ZegarNotAvailable/CloneFactory/CA80-Cube/README.MD

# CA80-Cube.

Jest to kolejna wersja CA80-mini. Wymiary płytek zostały ujednolicone, co umożliwia budowę komputera w formie nakładanych na siebie modułów.

## Hardware

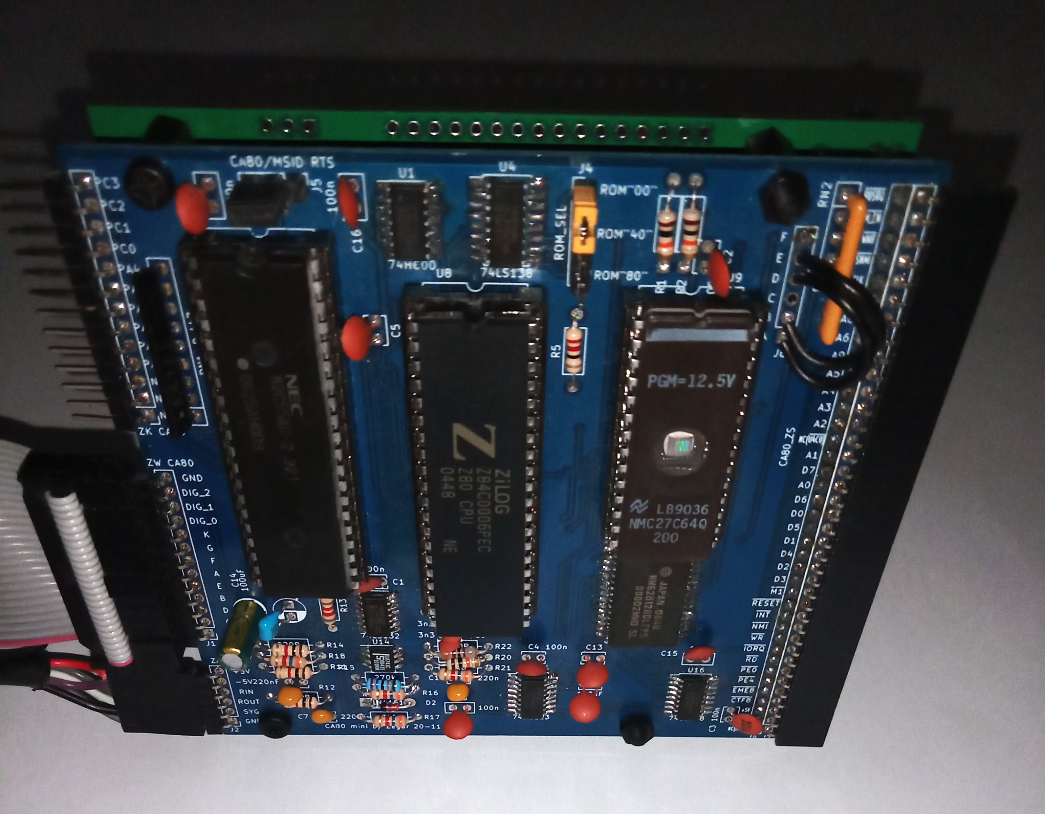
[picture p4: CA80-Cube/HW/Pics/Kanapka-mini-CPU.jpg]
Assembled modules


It is not a CP/M system, but a self-sufficient computer with a hexadecimal keyboard and a seven-segment display.
In the minimum version, 2kB EPROM and 2kB RAM are enough, but it is optimal to use the full 64kB RAM.
It is possible to build a classic version with EPROM and a CLK generator, but using an additional module with an ATmega32A microcontroller significantly increases the computer's capabilities.

### CA80-mini.

It's MIK90 equivalent. Includes processor and memory. The decoder is consistent with the original and divides the address space into four parts. 
By default, all memory is allocated to RAM. We can allocate one or two sixteen-kilobyte areas to EPROM, which we can insert into the U9 socket. 

Contains system interfaces: 
- keyboard,
- display,
- and tape recorder.

### MIK89 module.

The original only included the i8255 and Z80 CTC. On the edge was a ZS connector containing signals for use outside the motherboard. 
Soldering points scattered throughout the board were connected with wires to a male DB50 called ZU50.
In the new version CA80 (1989 - 1990) these chips were moved to the motherboard and ZU64 was added.

Clone takes this change. I also added a CLK generator and an NMI divider, which did not fit on the CA80-CPU.
They are not needed when we use the CA80-bootloader module.

- CLK was originally 4 MHz. This is important in tape recorder operating procedures. We can use a different frequency with some restrictions.
- NMI is the computer's most important signal. In the original it was 500 Hz and that's what it should always be.
  As the name suggests, this signal reports a non-maskable interrupt, which:
  - displays successive display digits multiplexed.
  - Checks if the "M" key has been pressed.
  - Counts down seconds, minutes, hours... years in RTC.
 
### CA80-multi module.

This is an extended replacement for MIK89. Adapted to the CA80-mini format, it allows you to build a "sandwich" computer.

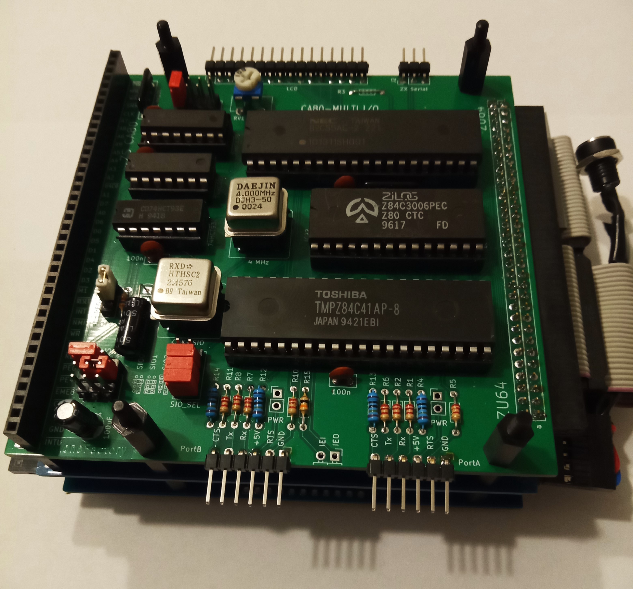
[picture p5: CA80-mini/HW/Pics/CA-MULTI-ASEMBLED.jpg]
CA80-multi


Includes:
- 8255,
- Z80CTC,
- 4 MHz generator,
- NMI divider,
- ZU64 connector,
- Z80SIO,
- 2.4576 MHz generator,
- Port A and Port B serial connectors,
- LCD display interface (HD44780).

### Software.

Dla wersji bez bootloadera należy zastosować zmodyfikowane wersje oprogramowania.

CA80-Cube/Code/HEX/CA804KFL.HEX to pierwsze 4 kB monitora CA80 z dodatkowymi zleceniami. 
*8d przepisuje CAFL z flash do RAM (4000H)
*88 przełącza sektor flash na 0FFH i uruchamia tam monitor CA88. Aktywne są wtedy również pozostałe zlecenia powyżej *84

CA80-Cube/Code/HEX/SST39SF040-CAFL-mini.BIN to program "magnetofonu" z chronionymi sektorami.

File CA80-MLT.HEX (Code-HEX/CA80-MLT.HEX)

In addition to the basic CA80 monitor (MIK290), full "tape recorder" software with functions supporting HEX files, redirected from 2000H. 
You can load it from SD card using CA80-boot module, or program EPROM. It also works without "flash" module.

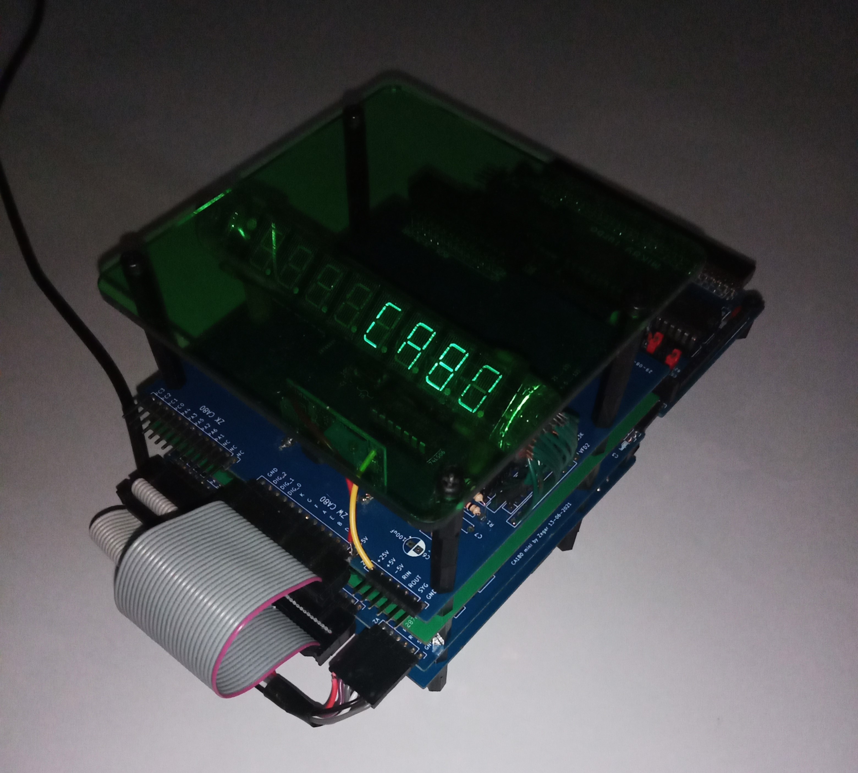
[picture p6: CA80-mini/HW/Pics/Kanapka-big.jpg]
CA80 big sandwich.


## Code for CA80 with Msid

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
