ZegarNotAvailable/CloneFactory/HardWare/IDC-CONN/CA80-Kbd-Disp-Conn.pdf

# | Reference | Qty | Value | Footprint

1 | C1, C2, C3 | 3 | 100n | Capacitor_THT:C_Disc_D3.8mm_W2.6mm_P2.50mm
2 | D1, D2, D3, D4, D5, D6 | 6 | 1N4148 | Diode_THT:D_DO-35_SOD27_P7.62mm_Horizontal
4 | J1 | 1 | ZW, ZK | PinSocket_2x13_P2.54mm_Vertical
5 | J2 | 1 | ZW, ZK | IDC26_Vertical
6 | Boot Loader | 1 | ZK | PinSocket_1x13_P2.54mm_Vertical
