ZegarNotAvailable/CloneFactory/CA80-Cube/HW/Pics/CA-SANDWICH-MINI.jpg

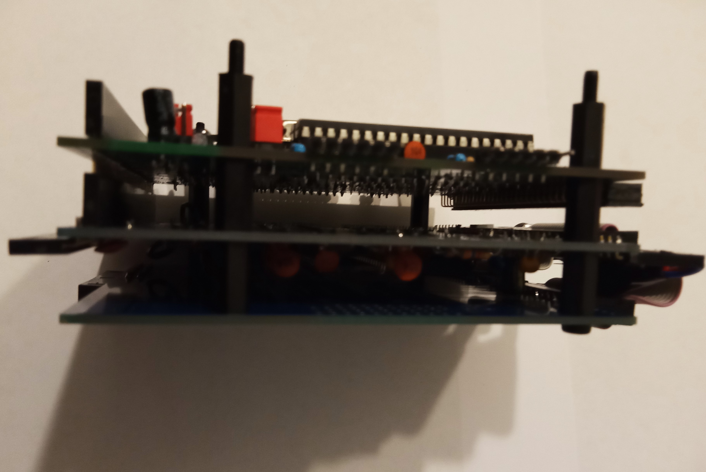
CA80-Cube/HW/Pics/CA-SANDWICH-MINI.jpg
