ZegarNotAvailable/CloneFactory/CA80-Cube/HW/Pics/Kanapka-terminal.jpg

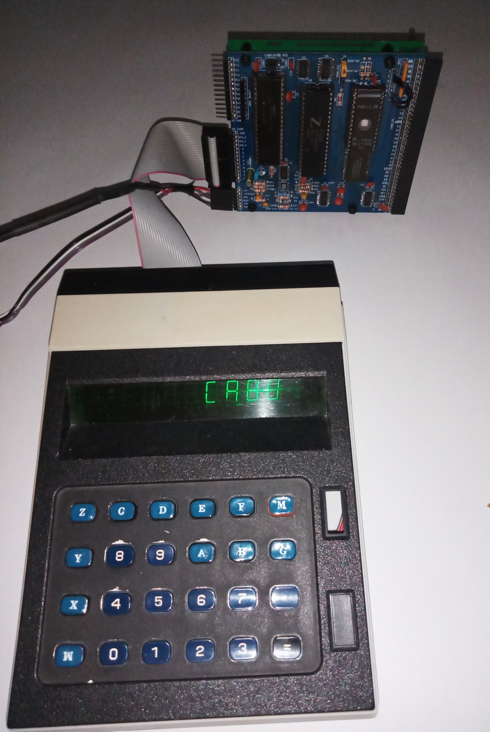
CA80-Cube/HW/Pics/Kanapka-terminal.jpg
