ZegarNotAvailable/CloneFactory/CA80-mini/HW/CA80-FLASH-CF/CA80-FLASH-CF.jpg

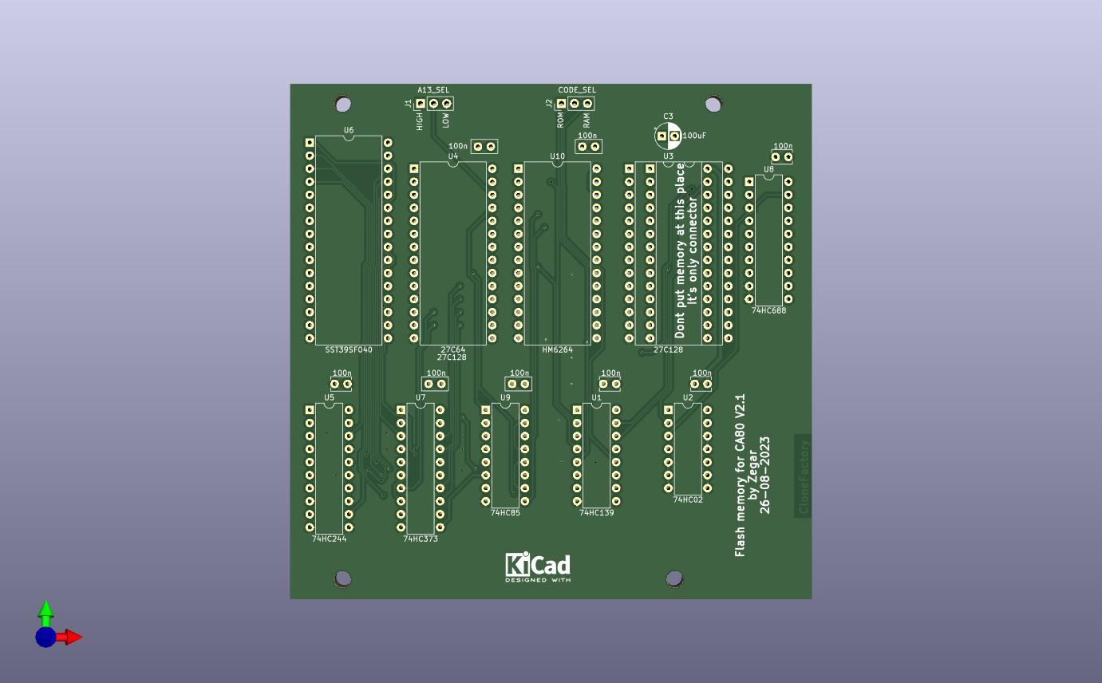
CA80-mini/HW/CA80-FLASH-CF/CA80-FLASH-CF.jpg
