ZegarNotAvailable/CloneFactory/CA80-mini/HW/CA80-mini-boot/CA80-mini-boot.png

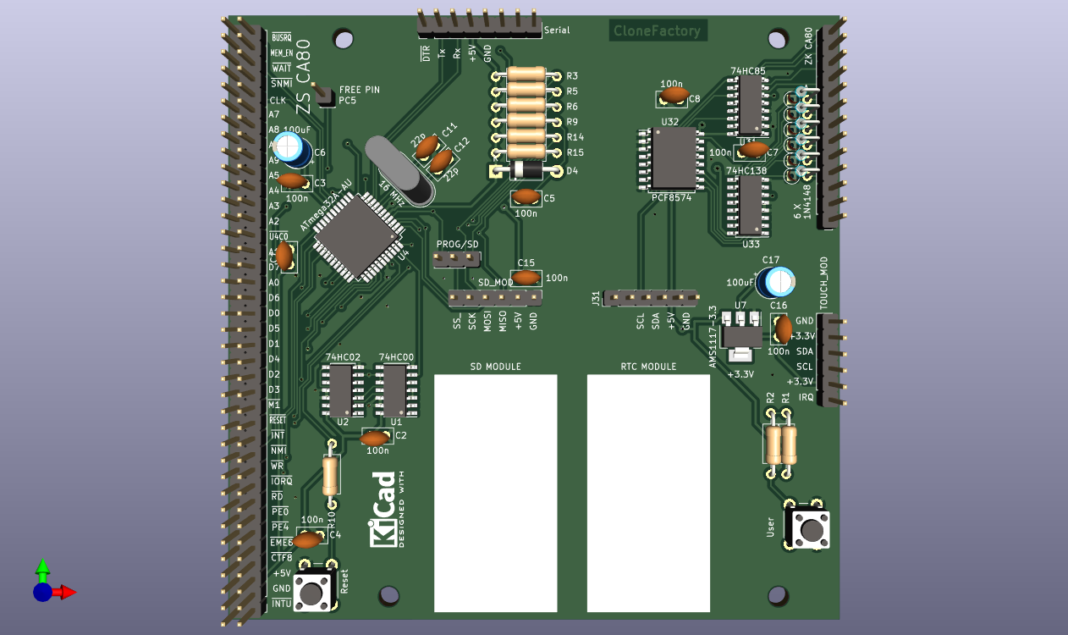
CA80-mini/HW/CA80-mini-boot/CA80-mini-boot.png
