ZegarNotAvailable/CloneFactory/CA80-mini/HW/CA80-mini/CA80-mini-03-23.jpg

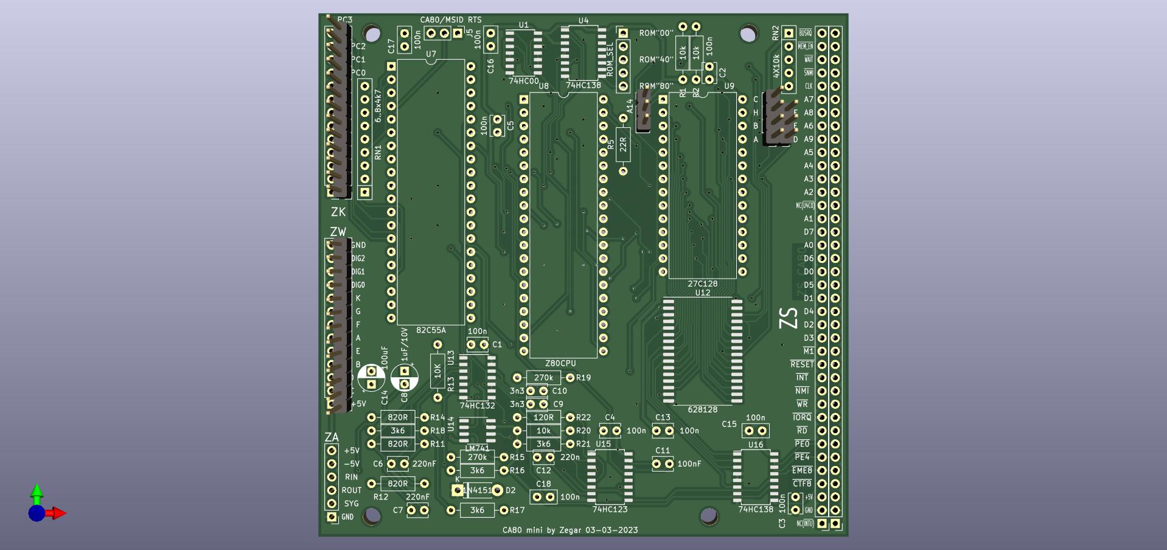
CA80-mini/HW/CA80-mini/CA80-mini-03-23.jpg
