ZegarNotAvailable/CloneFactory/CA80-mini/HW/CA80-mini/CA80-mini-23.png

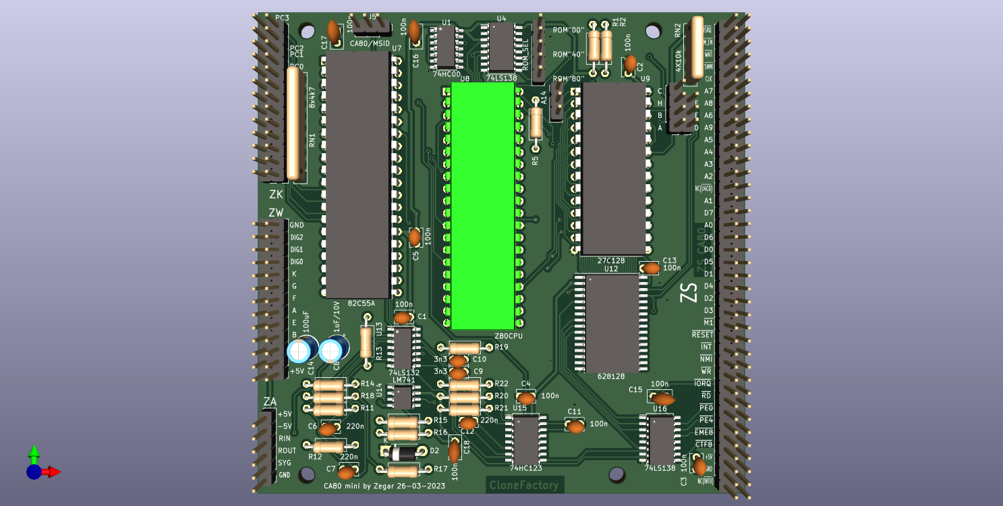
CA80-mini/HW/CA80-mini/CA80-mini-23.png
