ZegarNotAvailable/CloneFactory/CA80-mini/HW/CA80-multi/CA80-MULTI-IO.jpg

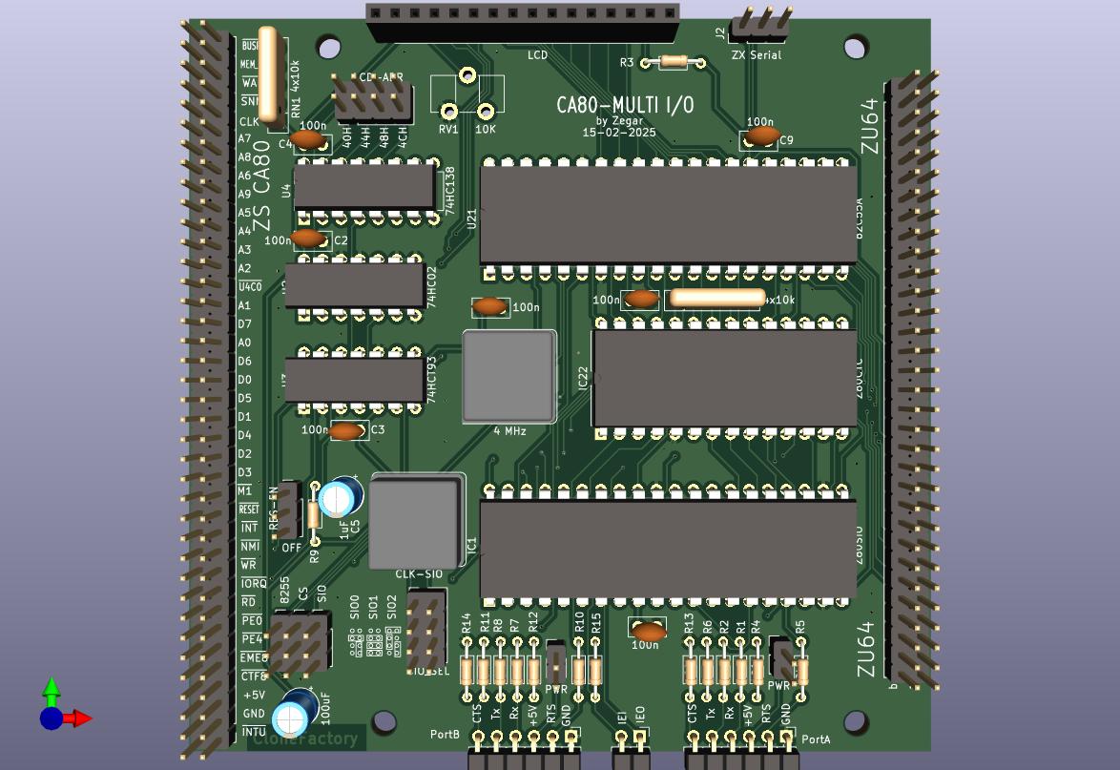
CA80-mini/HW/CA80-multi/CA80-MULTI-IO.jpg
