ZegarNotAvailable/CloneFactory/CA80-mini/HW/MIK89/MIK89_EXT-a.png

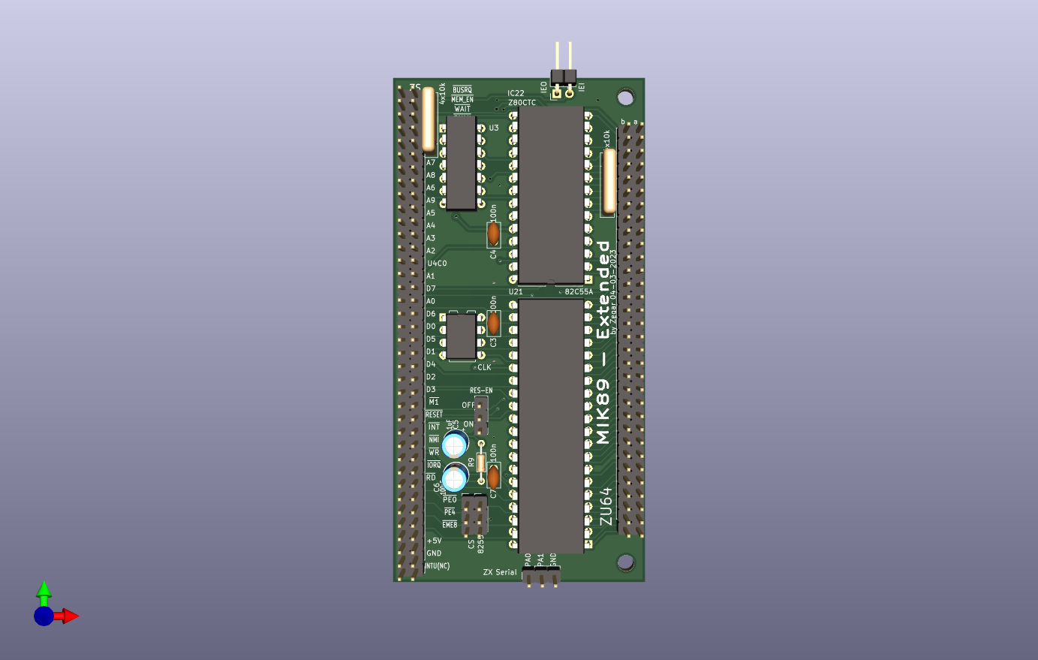
CA80-mini/HW/MIK89/MIK89_EXT-a.png
