ZegarNotAvailable/CloneFactory/CA80-mini/HW/Pics/CA80-mini-sandwich1.jpg

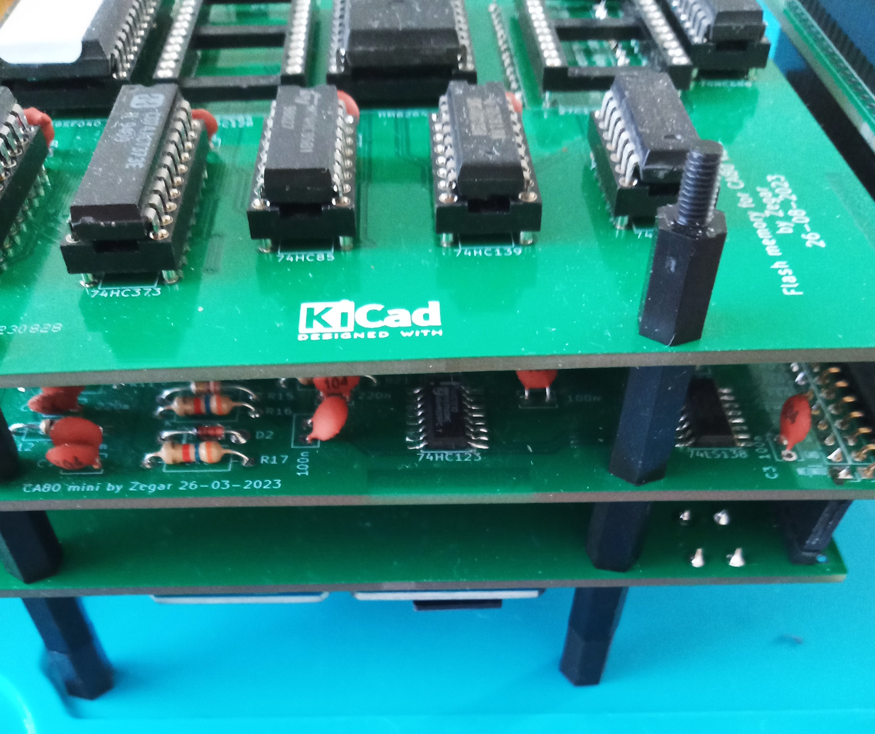
CA80-mini/HW/Pics/CA80-mini-sandwich1.jpg
