ZegarNotAvailable/CloneFactory/CA80-mini/HW/Pics/CA80-mini-sandwich.jpg

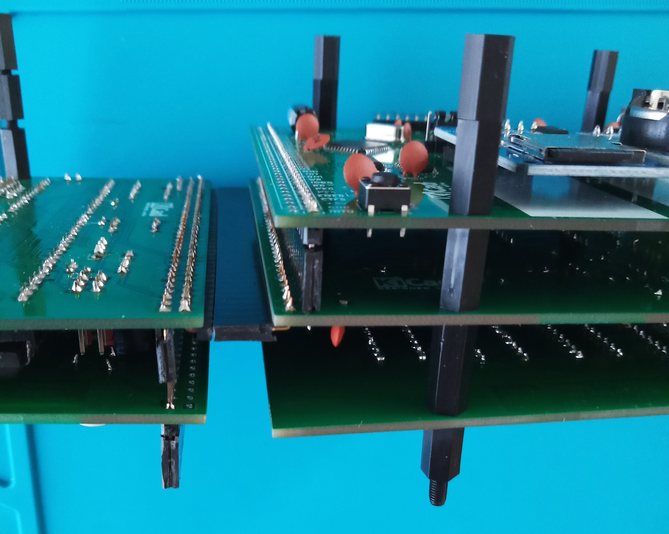
CA80-mini/HW/Pics/CA80-mini-sandwich.jpg
