ZegarNotAvailable/CloneFactory/CA80-mini/HW/Pics/CA80-Multi.jpg

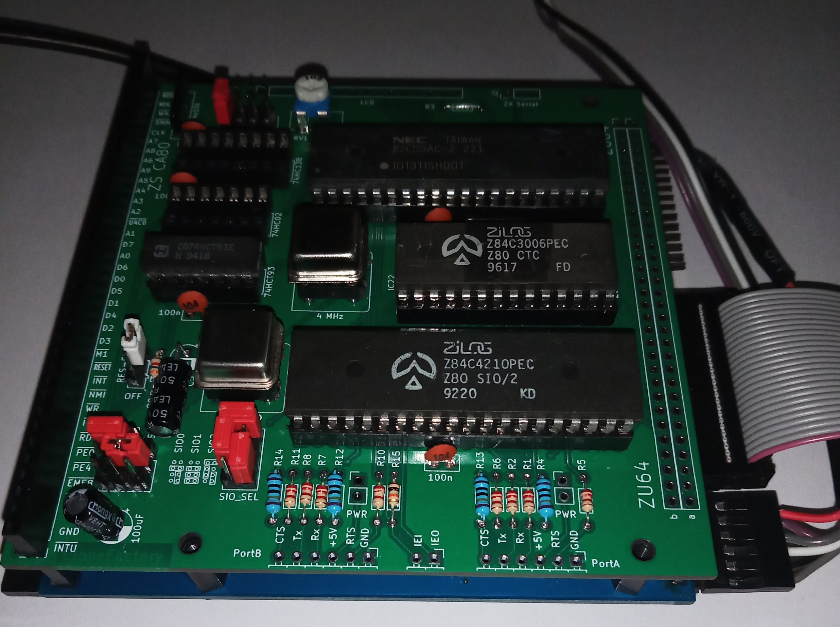
CA80-mini/HW/Pics/CA80-Multi.jpg
