ZegarNotAvailable/CloneFactory/CA80-mini/HW/Pics/Mini-boot-asembled.jpg

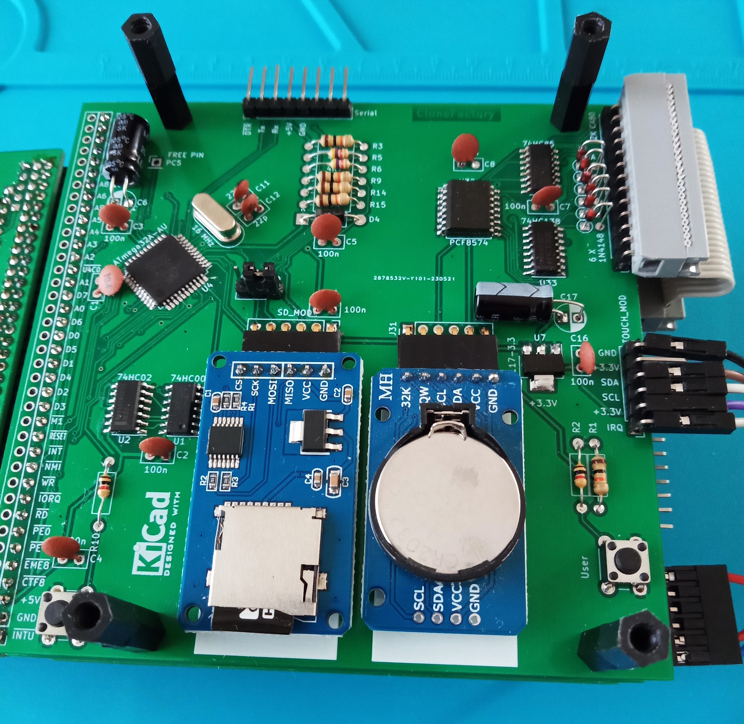
CA80-mini/HW/Pics/Mini-boot-asembled.jpg
