ZegarNotAvailable/CloneFactory/CA80-mini/HW/Pics/Touch-asembled1.jpg

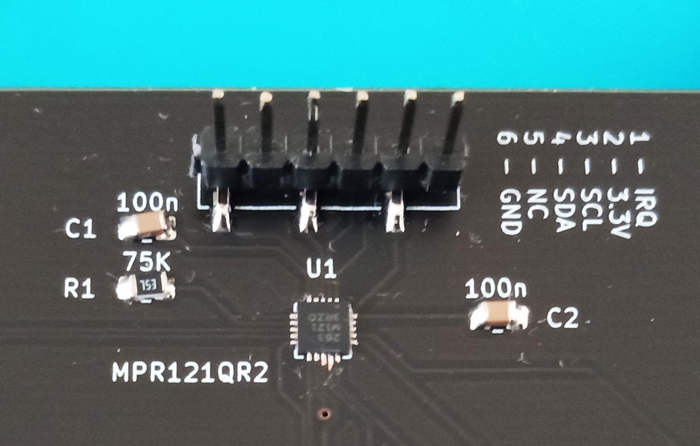
CA80-mini/HW/Pics/Touch-asembled1.jpg
