ZegarNotAvailable/CloneFactory/HardWare/CA80-bootloader/CA80-bootload.jpg

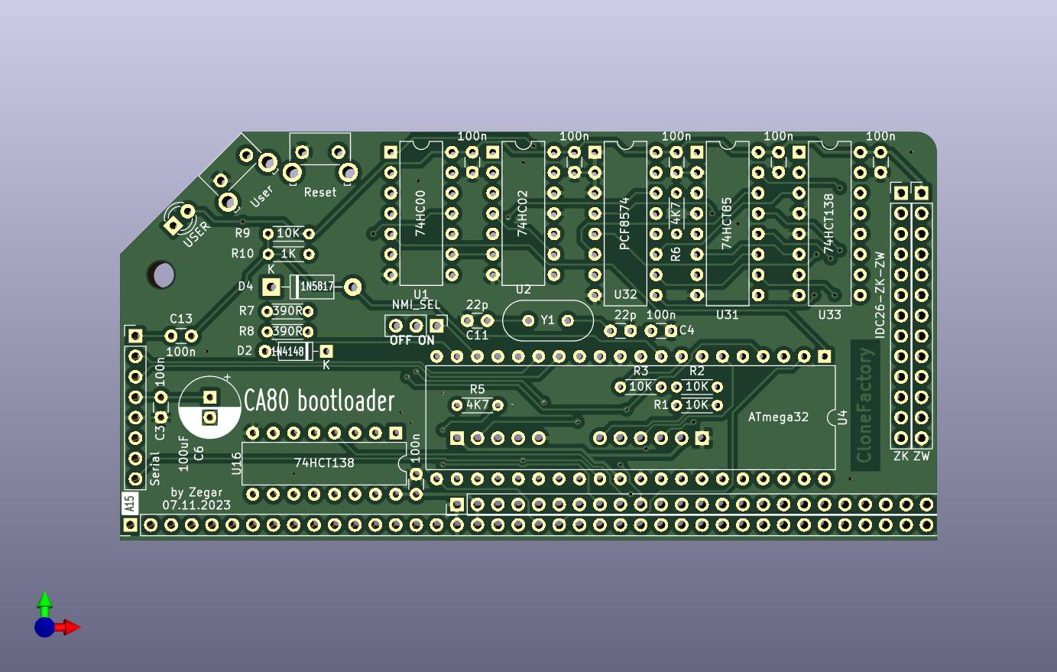
HardWare/CA80-bootloader/CA80-bootload.jpg
