ZegarNotAvailable/CloneFactory/HardWare/CA80-bootloader/CA80-bootloader.jpg

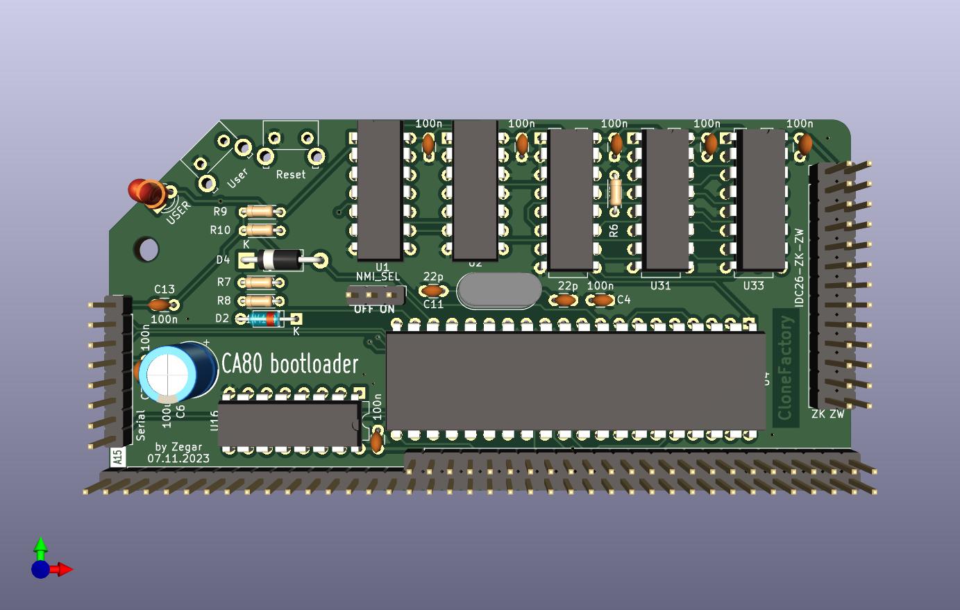
HardWare/CA80-bootloader/CA80-bootloader.jpg
