ZegarNotAvailable/CloneFactory/HardWare/CA80-flash/CA80_flash_RC.png

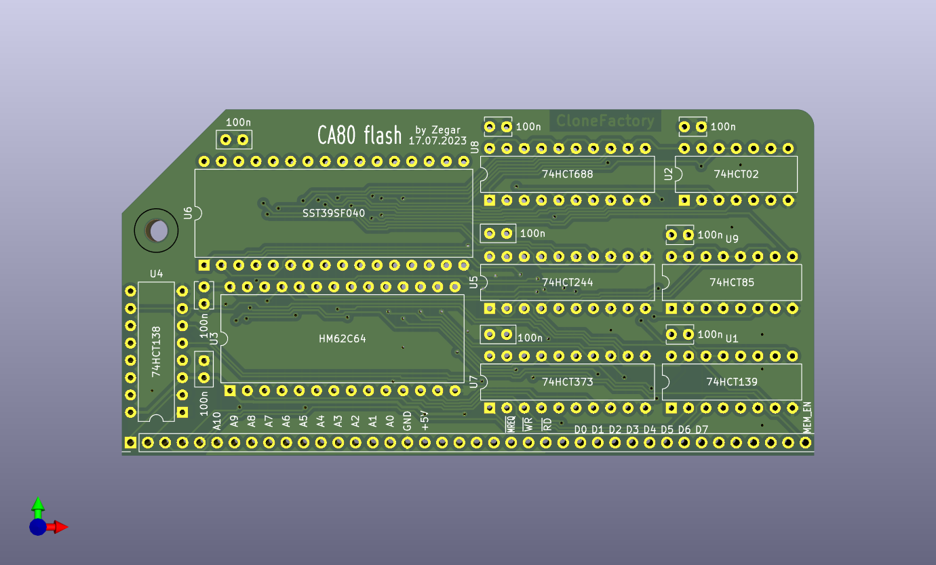
HardWare/CA80-flash/CA80_flash_RC.png
