ZegarNotAvailable/CloneFactory/HardWare/CA80-flash/CA80_flash_RC_uc.png

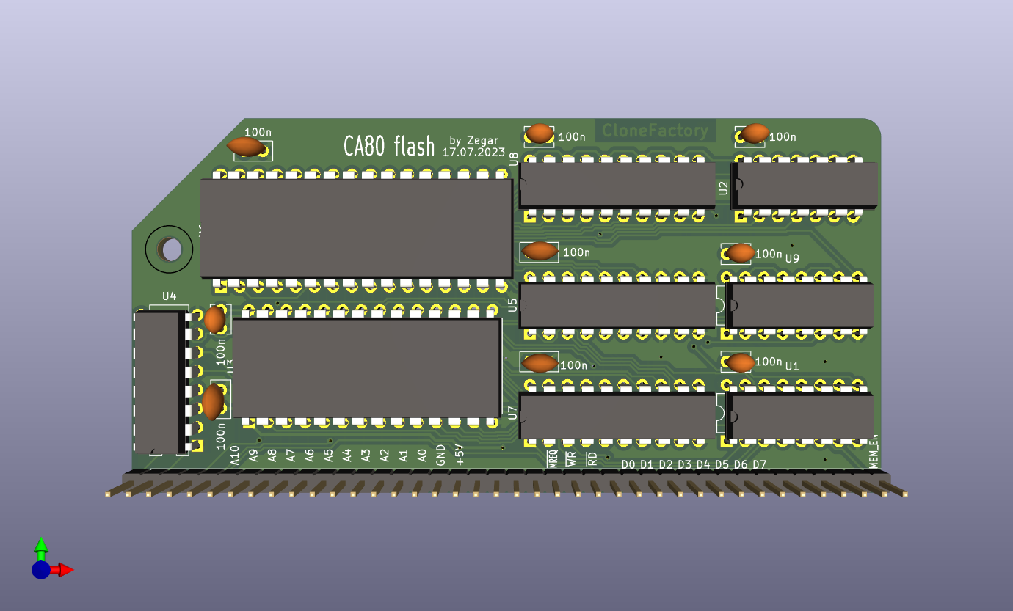
HardWare/CA80-flash/CA80_flash_RC_uc.png
