ZegarNotAvailable/CloneFactory/HardWare/CPU-N/CA80-CPU-12-mod.png

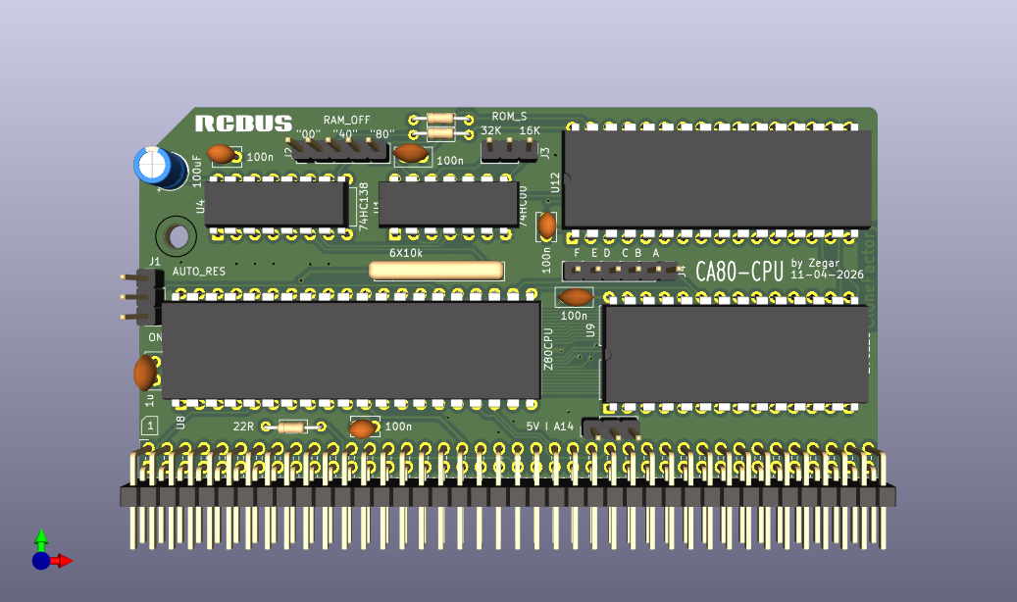
HardWare/CPU-N/CA80-CPU-12-mod.png
