ZegarNotAvailable/CloneFactory/HardWare/CPU-N/CA80-CPU-12-PCB.png

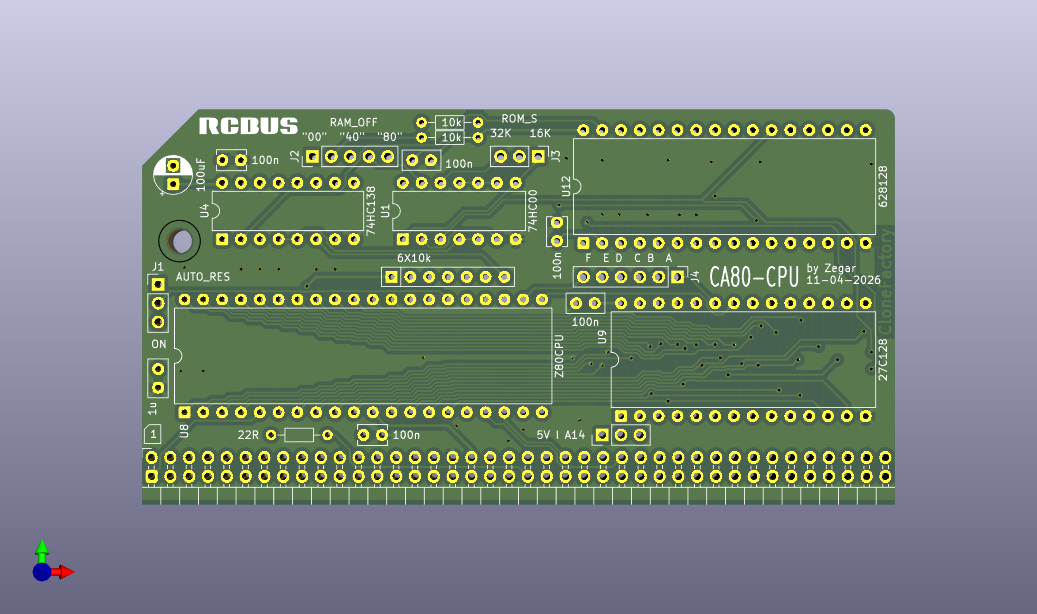
HardWare/CPU-N/CA80-CPU-12-PCB.png
