ZegarNotAvailable/CloneFactory/HardWare/CPU-N/CA80-CPU-N.jpg

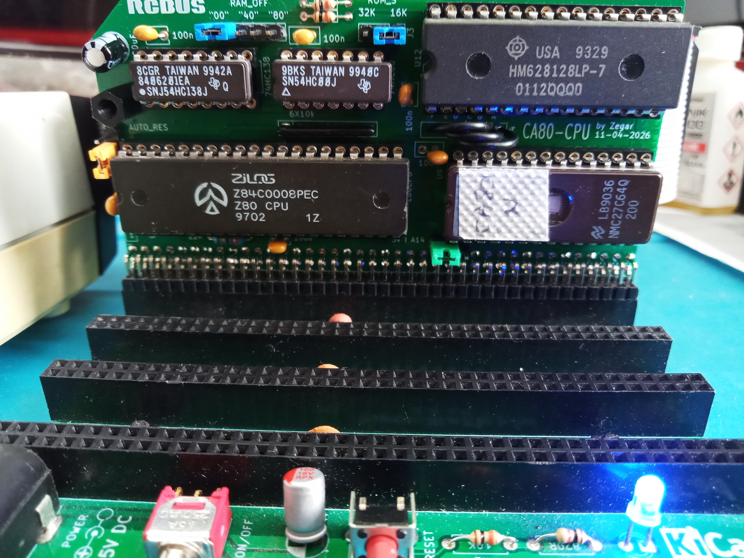
HardWare/CPU-N/CA80-CPU-N.jpg
