ZegarNotAvailable/CloneFactory/HardWare/CPU-N/CA80-RC-N-asembled.jpg

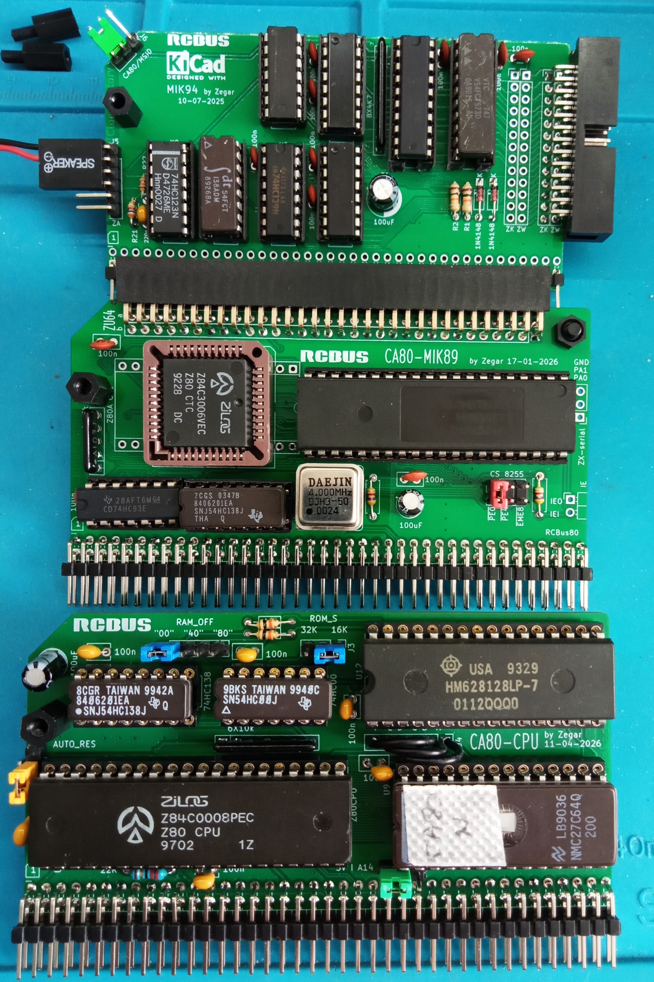
HardWare/CPU-N/CA80-RC-N-asembled.jpg
