ZegarNotAvailable/CloneFactory/HardWare/CPU/CA80-CPU-RCbus.jpg

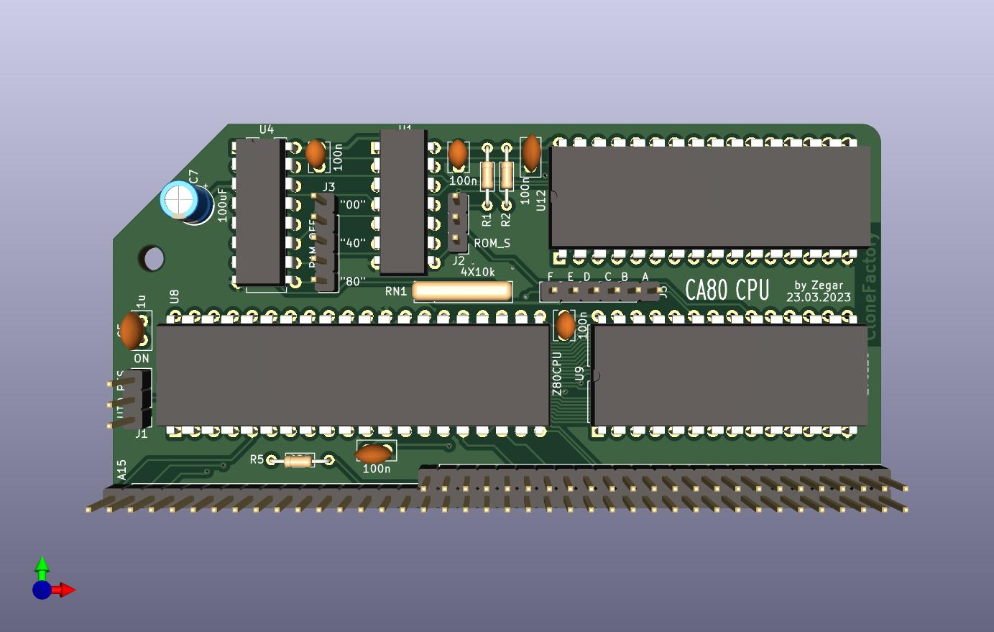
HardWare/CPU/CA80-CPU-RCbus.jpg
