ZegarNotAvailable/CloneFactory/HardWare/Dual-RAM-backplane/D-RAM-backplane-front.png

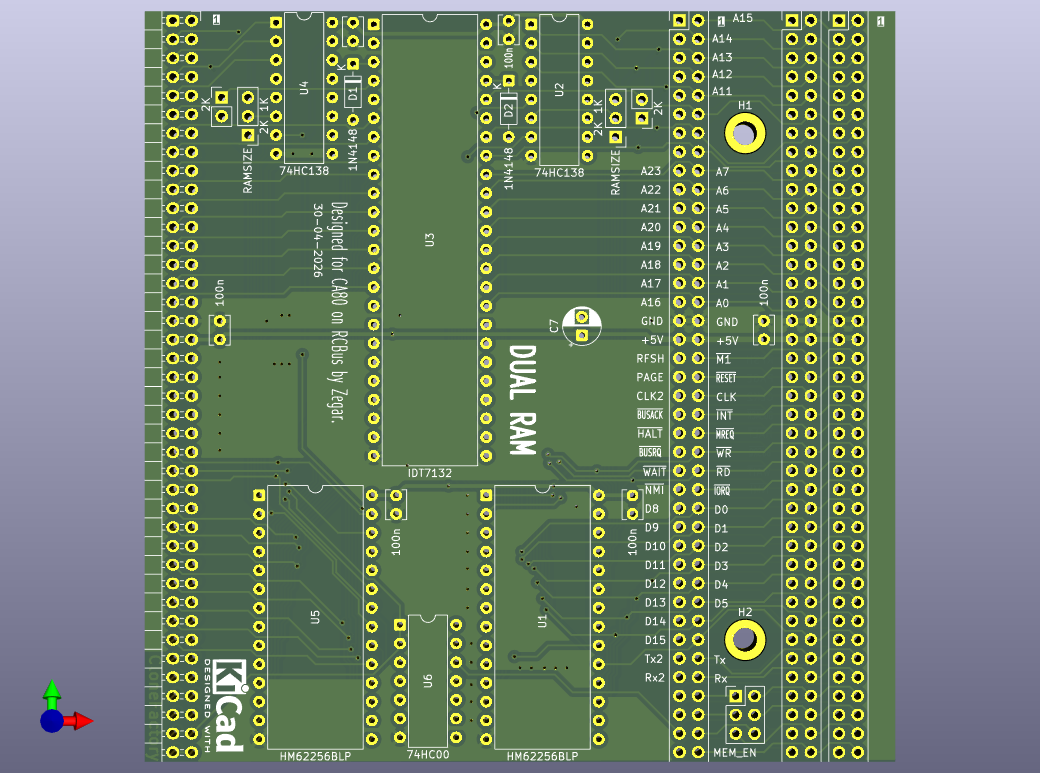
HardWare/Dual-RAM-backplane/D-RAM-backplane-front.png
