ZegarNotAvailable/CloneFactory/HardWare/Dual-RAM-backplane/D-RAM-backplane-PSEN.png

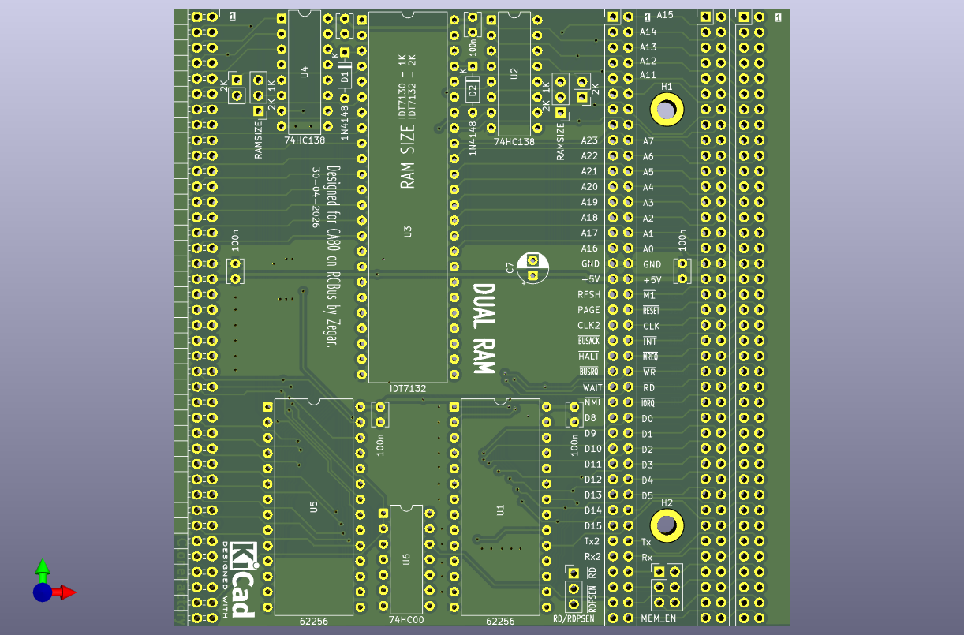
HardWare/Dual-RAM-backplane/D-RAM-backplane-PSEN.png
