ZegarNotAvailable/CloneFactory/HardWare/Dual-RAM-backplane/D-RAM-backplane.png

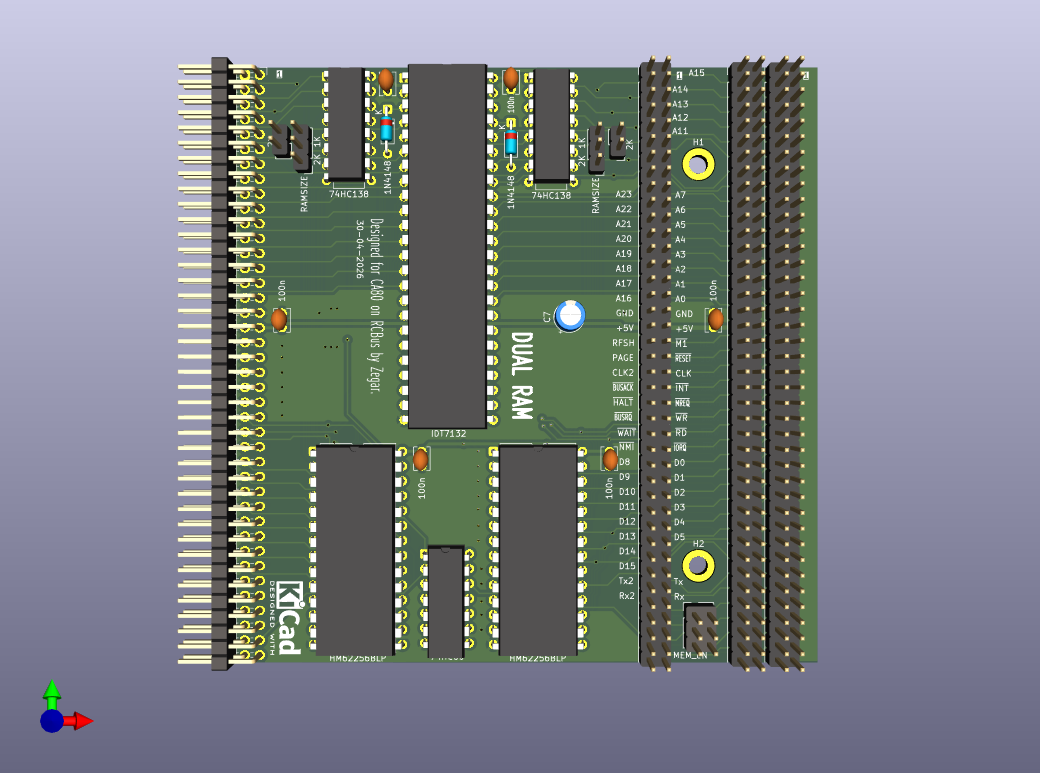
HardWare/Dual-RAM-backplane/D-RAM-backplane.png
