ZegarNotAvailable/CloneFactory/HardWare/IDC-CONN/SYS-IO-BOOT-CONN.jpg

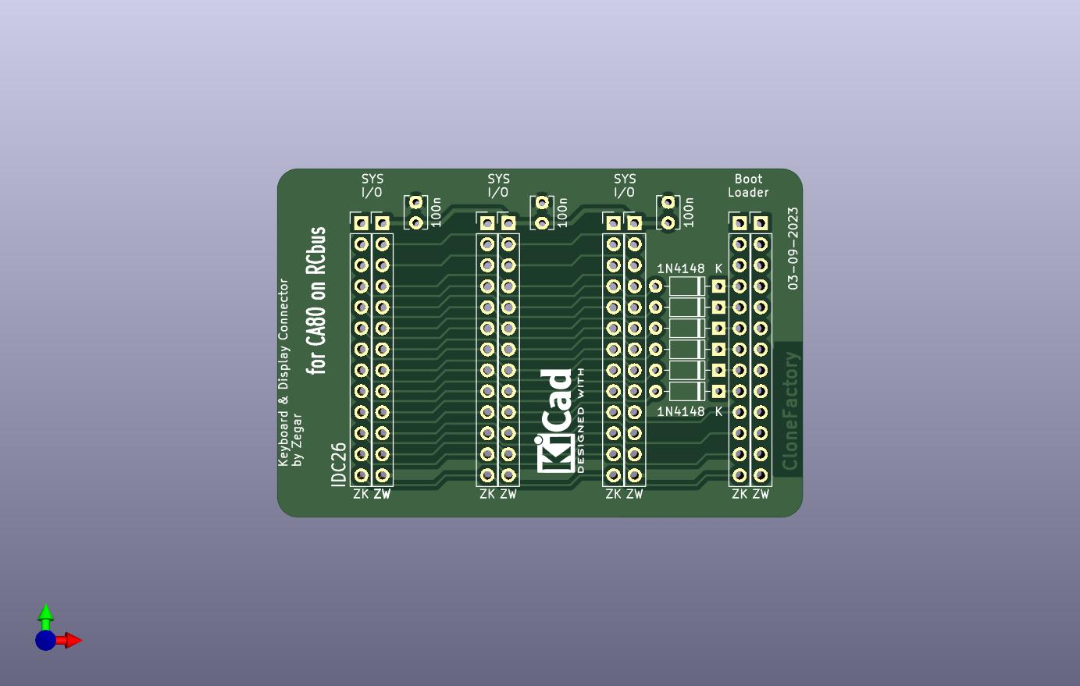
HardWare/IDC-CONN/SYS-IO-BOOT-CONN.jpg
