ZegarNotAvailable/CloneFactory/HardWare/MIK1-PROTO/MIK1-K.jpg

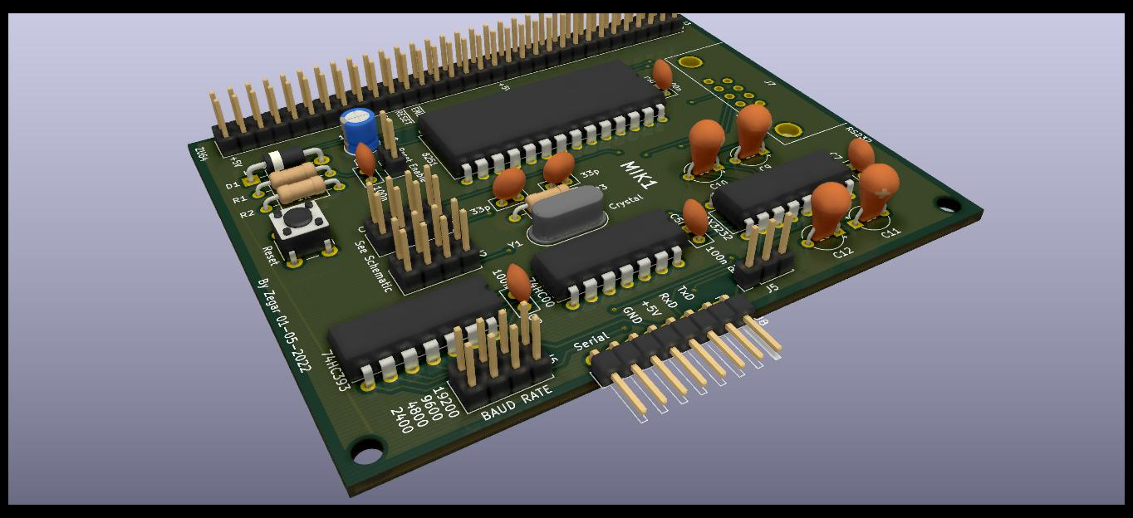
HardWare/MIK1-PROTO/MIK1-K.jpg
