ZegarNotAvailable/CloneFactory/HardWare/MIK1-PROTO/MIK1_RC2014.png

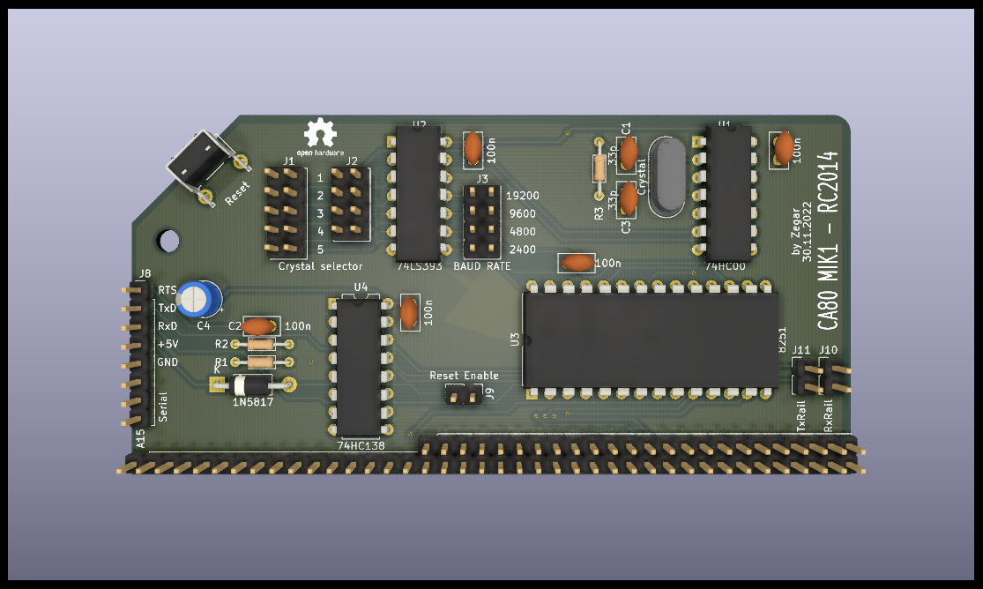
HardWare/MIK1-PROTO/MIK1_RC2014.png
