ZegarNotAvailable/CloneFactory/HardWare/MIK1/MIK1-RC-PCB.png

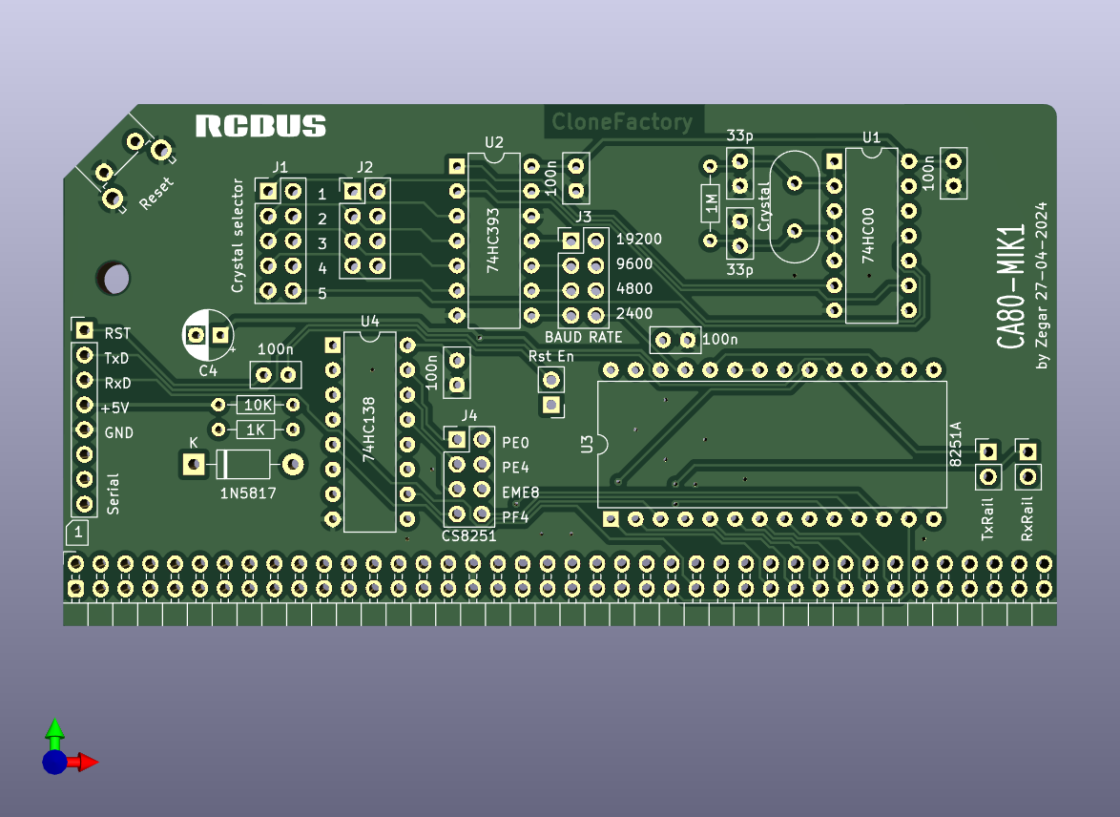
HardWare/MIK1/MIK1-RC-PCB.png
