ZegarNotAvailable/CloneFactory/HardWare/MIK1/MIK1-RC.png

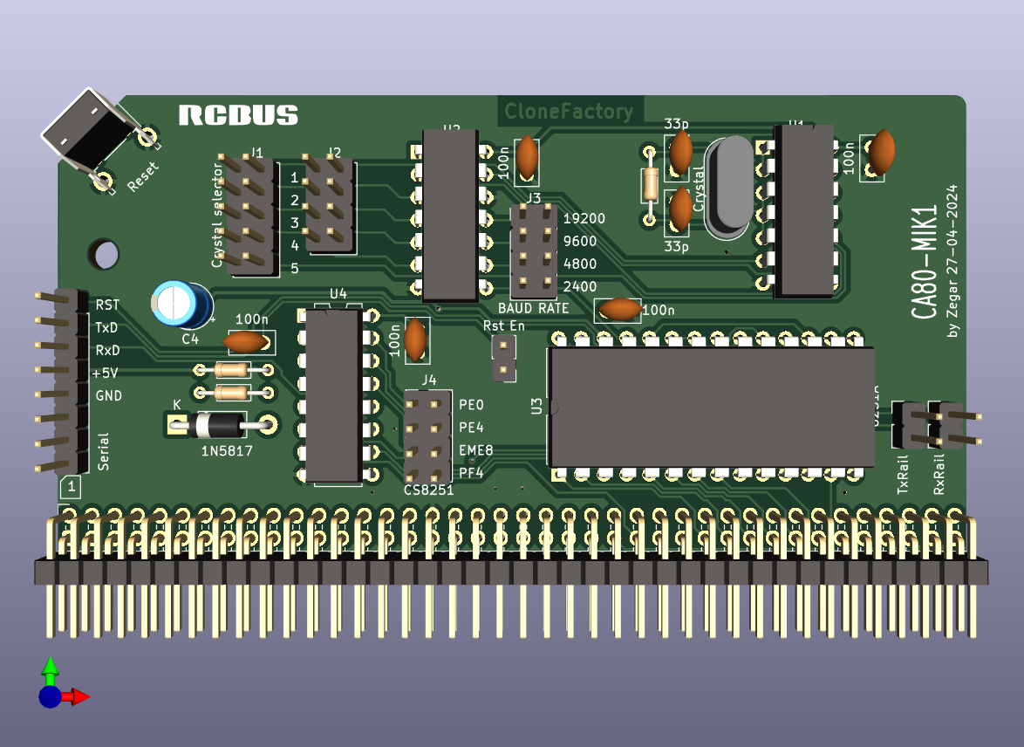
HardWare/MIK1/MIK1-RC.png
