ZegarNotAvailable/CloneFactory/HardWare/MIK51/MIK51-A.png

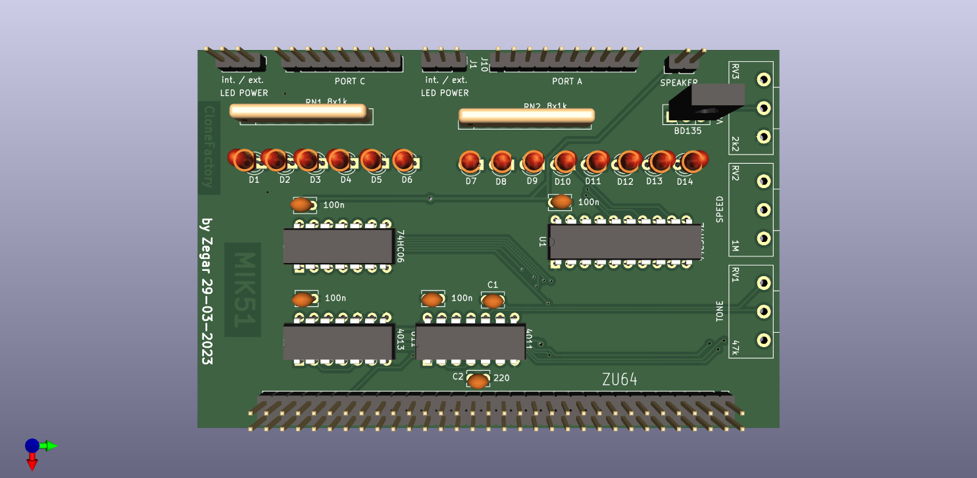
HardWare/MIK51/MIK51-A.png
