ZegarNotAvailable/CloneFactory/HardWare/MIK89-n/CA80-MIK89-n.jpg

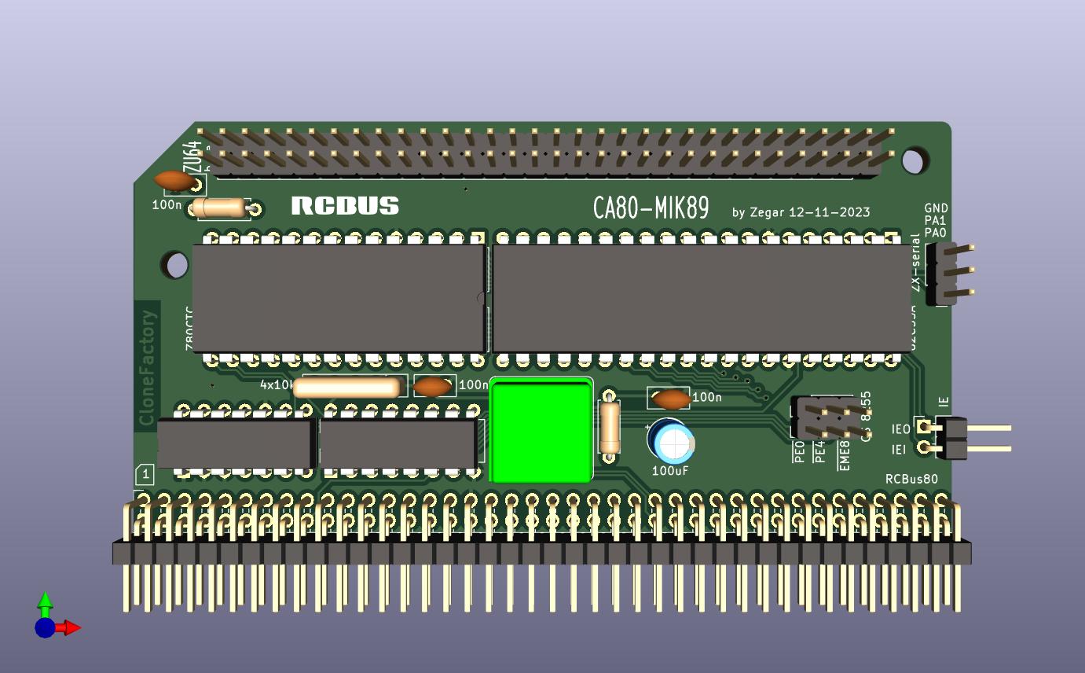
HardWare/MIK89-n/CA80-MIK89-n.jpg
