ZegarNotAvailable/CloneFactory/HardWare/MIK89-n/CA80-MIK89-nc.png

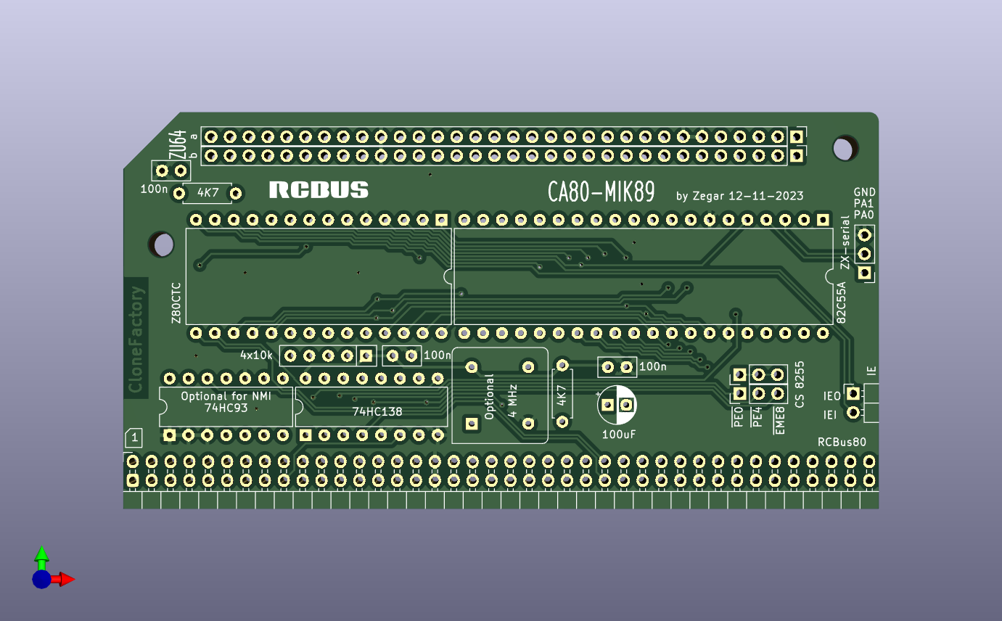
HardWare/MIK89-n/CA80-MIK89-nc.png
