ZegarNotAvailable/CloneFactory/HardWare/MIK89-PLCC/MIK89-RC-PLCC-pcb.png

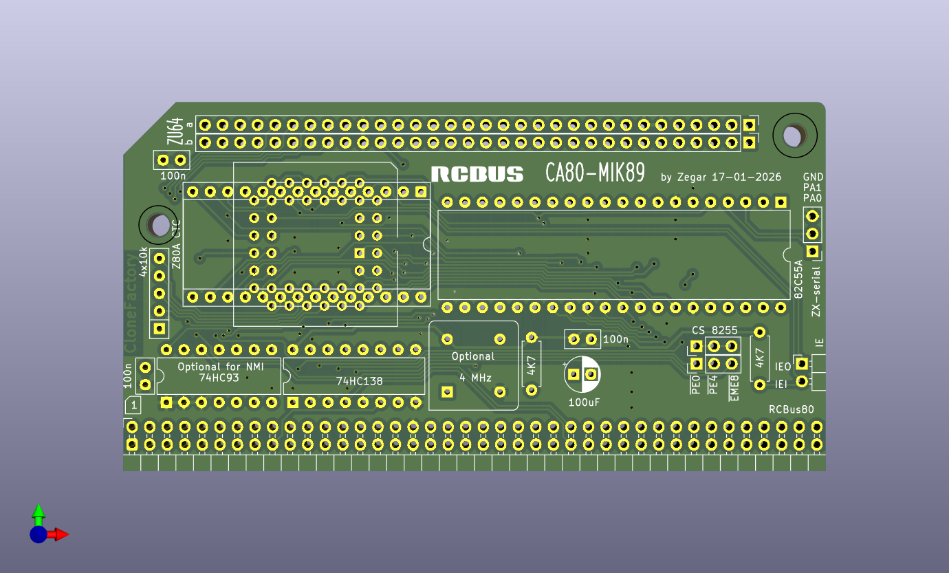
HardWare/MIK89-PLCC/MIK89-RC-PLCC-pcb.png
