ZegarNotAvailable/CloneFactory/HardWare/MIK89-PLCC/MIK89-RC-PLCC.png

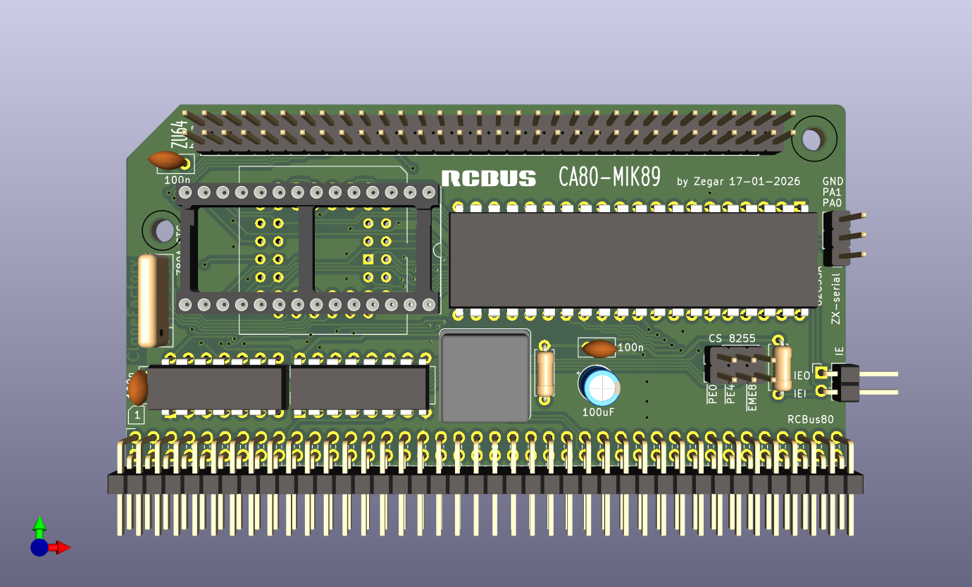
HardWare/MIK89-PLCC/MIK89-RC-PLCC.png
