ZegarNotAvailable/CloneFactory/HardWare/MIK94-N/MIK94-N-RCBus.png

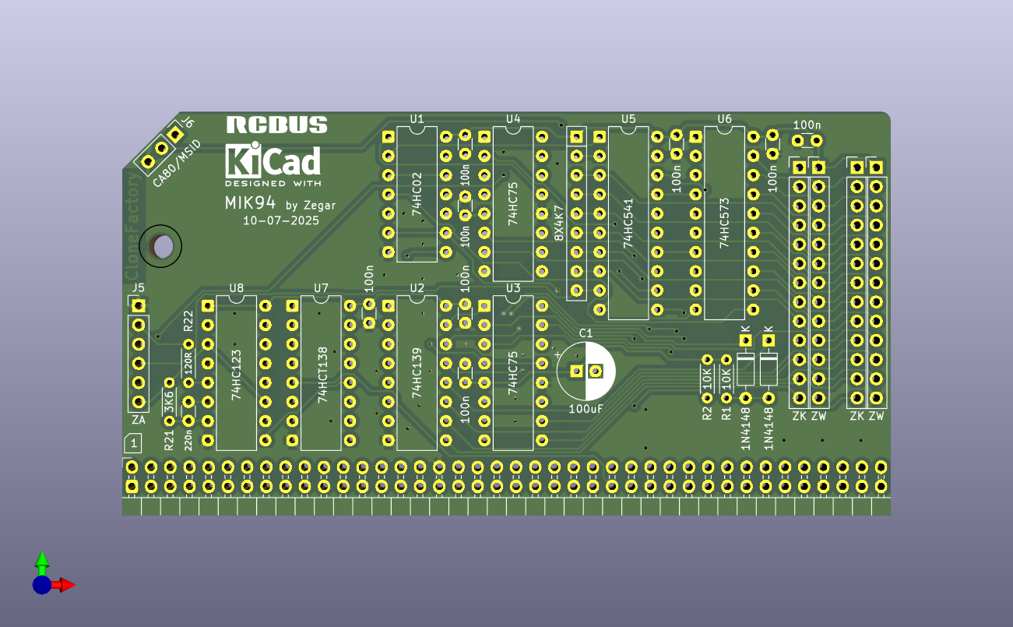
HardWare/MIK94-N/MIK94-N-RCBus.png
