ZegarNotAvailable/CloneFactory/HardWare/Pictures/LED-green.jpg

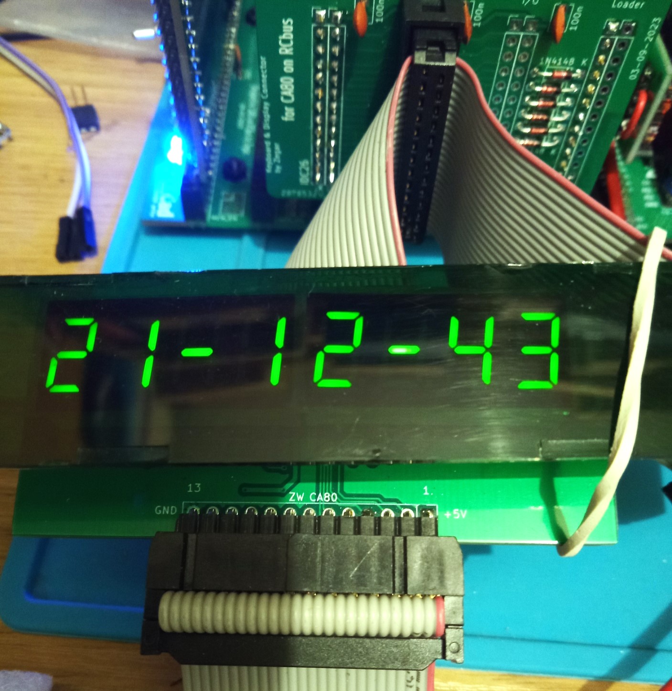
HardWare/Pictures/LED-green.jpg
