ZegarNotAvailable/CloneFactory/HardWare/Pictures/MIK89-CLK.jpg

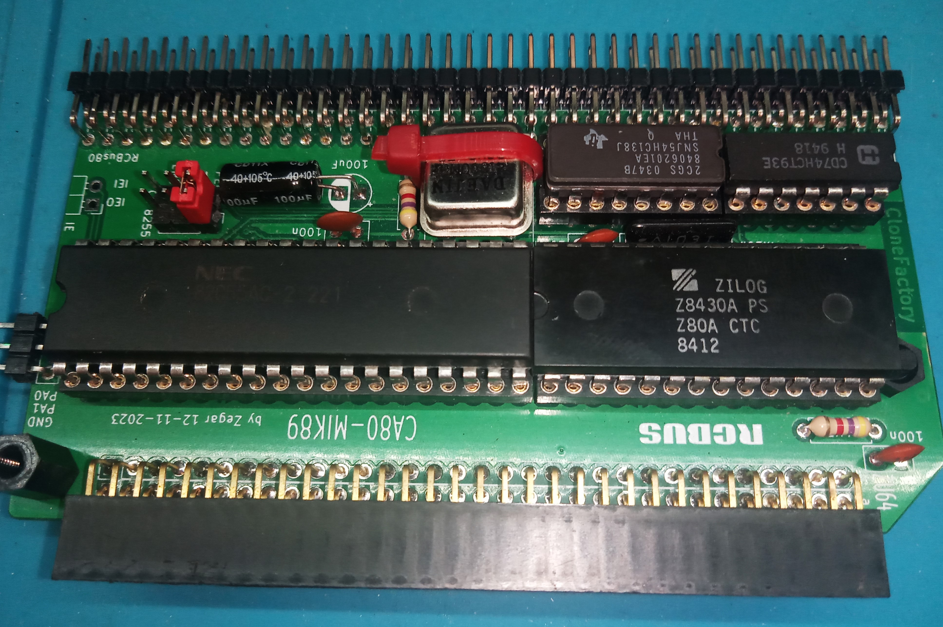
HardWare/Pictures/MIK89-CLK.jpg
