ZegarNotAvailable/CloneFactory/HardWare/Pictures/MSid-simply.jpg

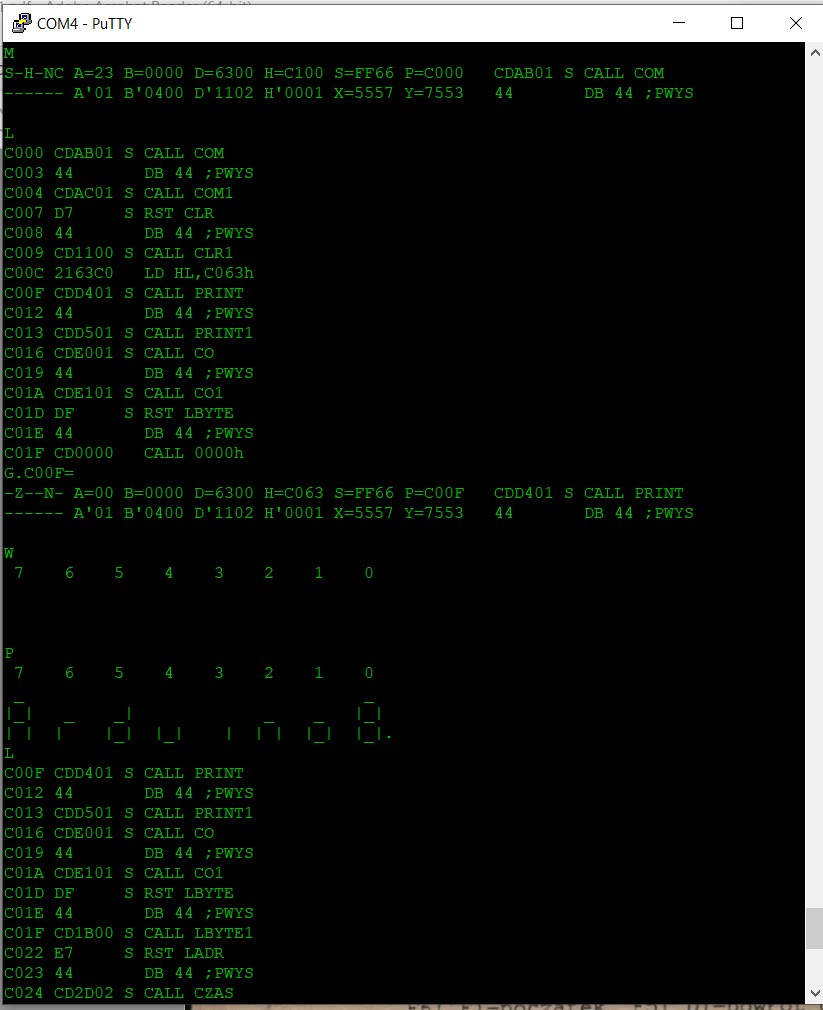
HardWare/Pictures/MSid-simply.jpg
