ZegarNotAvailable/CloneFactory/HardWare/Pictures/Touchpad-CA80-back.jpg

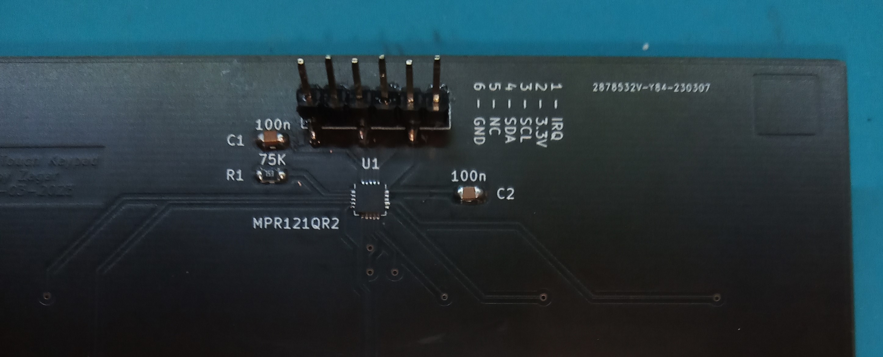
HardWare/Pictures/Touchpad-CA80-back.jpg
