ZegarNotAvailable/CloneFactory/HardWare/Pictures/Touchpad-CA80.jpg

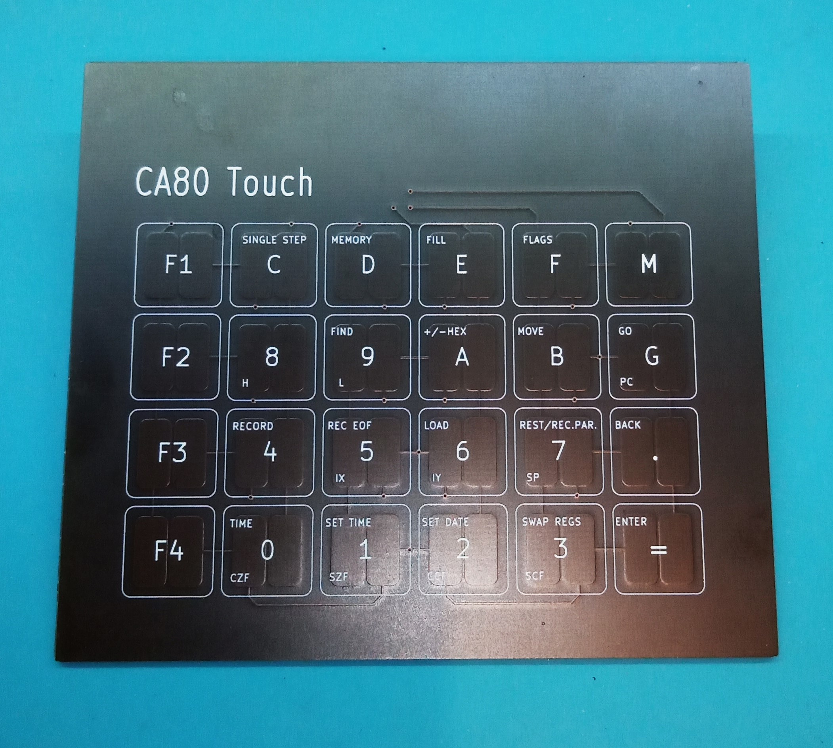
HardWare/Pictures/Touchpad-CA80.jpg
