ZegarNotAvailable/CloneFactory/HardWare/SYS-IO/CA80-SYS-IO-RCbus.jpg

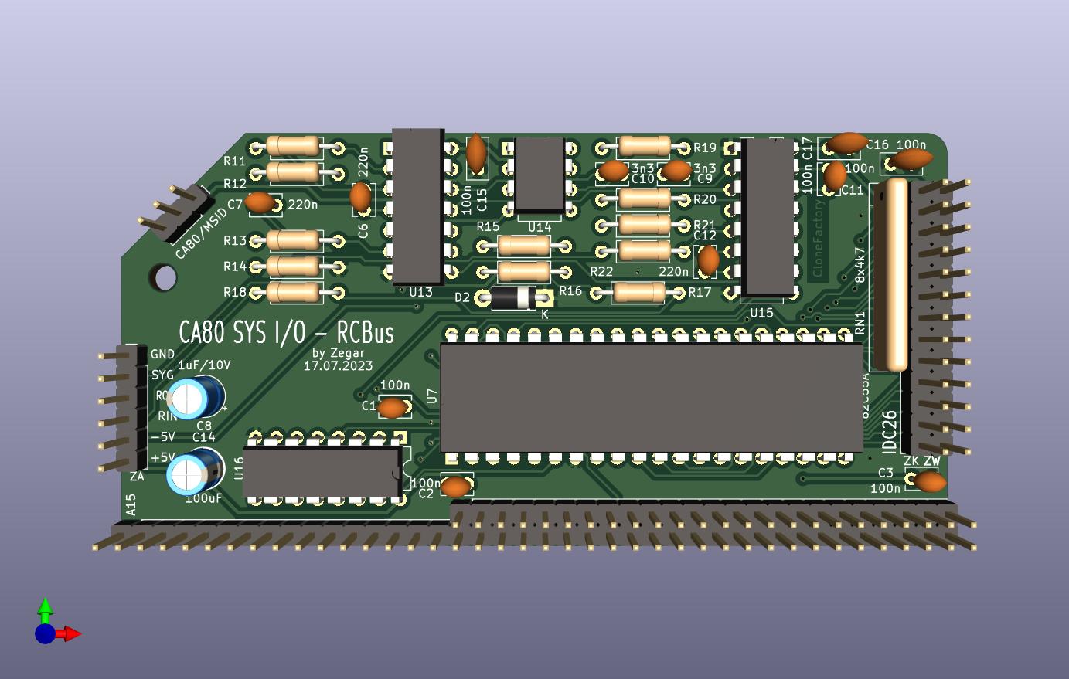
HardWare/SYS-IO/CA80-SYS-IO-RCbus.jpg
