ZegarNotAvailable/CloneFactory/HardWare/MIK94-N/MIK94-RC-BOM.pdf

MIK94-RC

Reference | Value | Footprint | Qty
C1 | 100uF | Capacitor_THT:CP_Radial_D7.5mm_P2.50mm | 1
C2,C3,C4,C5,C6,C7,C8,C9 | 100n | Capacitor_THT:C_Disc_D3.0mm_W1.6mm_P2.50mm | 8
C12 | 220n | Capacitor_THT:C_Disc_D3.0mm_W1.6mm_P2.50mm | 1
D1,D2 | 1N4148 | Diode_THT:D_DO-35_SOD27_P7.62mm_Horizontal | 2
ZW-ZK | ZW-ZK | PinHeader_2x13_P2.54mm_Vertical | 2
ZW-ZK | ZW-ZK | IDC26_ANGLE | 2
J5 | ZA | PinHeader_1x06_P2.54mm_Horizontal | 1
J6 | CA80/MSID | PinHeader_1x03_P2.54mm_Horizontal | 1
R1,R2 | 10K | Resistor_THT_L3.6mm_D1.6mm_P5.08mm_Horizontal | 2
R21 | 3K6 | Resistor_THT_L3.6mm_D1.6mm_P5.08mm_Horizontal | 1
R22 | 120R | Resistor_THT_L3.6mm_D1.6mm_P5.08mm_Horizontal | 1
RN1 | 8X4K7 | Resistor_THT:R_Array_SIP9 | 1
S1 | RCBus80 | RCbus:PinHeader_RCBus80 | 1
U1 | 74HC02 | Package_DIP:DIP-14_W7.62mm | 1
U2 | 74HC139 | Package_DIP:DIP-16_W7.62mm | 1
U3,U4 | 74HC75 | Package_DIP:DIP-16_W7.62mm | 2
U5 | 74HC541 | Package_DIP:DIP-20_W7.62mm | 1
U6 | 74HC573 | Package_DIP:DIP-20_W7.62mm | 1
U7 | 74HCT138 | Package_DIP:DIP-16_W7.62mm | 1
U8 | 74HC123 | Package_DIP:DIP-16_W7.62mm | 1

CA80-RC-BOM
