ZegarNotAvailable/CloneFactory/HardWare/CPU/CA80-RC-BOM.pdf

CA80-RC-BOM

# | Reference | Qty | Value | Footprint

1 | C1, C2, C3, C4, C6 | 5 | 100n | Capacitor_THT:C_Disc_D3.8mm_W2.6mm_P2.50mm
3 | C5 | 1 | 1u | Capacitor_THT:C_Disc_D5.0mm_W2.5mm_P2.50mm
4 | C7 | 1 | 100uF | Capacitor_THT:CP_Radial_D5.0mm_P2.50mm
6 | J1 | 1 | AUTO_RES | PinHeader_1x03_P2.54mm_Vertical
7 | J2 | 1 | ROM_S | PinHeader_1x03_P2.54mm_Vertical
8 | J3 | 1 | RAM_OFF | PinHeader_1x05_P2.54mm_Vertical
9 | J4 | 1 | Rcbus | PinHeader_2x40_P2.54mm_Angle
10 | J5 | 1 | F E D C B A | PinHeader_1x06_P2.54mm_Vertical
12 | R1, R2 | 2 | 10k | Resistor_1/8W
13 | R5 | 1 | 22R | Resistor_1/8W
14 | RN1 | 1 | 4X10k | Resistor_THT:R_Array_SIP5
15 | U1 | 1 | 74HC00 | Package_DIP:DIP-14_W7.62mm
16 | U4 | 1 | 74LS138 | Package_DIP:DIP-16_W7.62mm
17 | U8 | 1 | Z80CPU | Package_DIP:DIP-40_W15.24mm
18 | U9 | 1 | 27C128 | Package_DIP:DIP-28_W15.24mm
19 | U12 | 1 | HM628128 | Package_DIP:DIP-32_W15.24mm

CPU
