ZegarNotAvailable/CloneFactory/HardWare/SYS-IO/CA80-RC-SYS-IO-BOM.pdf

CA80-RC-BOM

Reference | Value | Footprint | Liczba
C1-C3, C11, C15-C17 | 100n | Capacitor_THT:C_Disc_D3.8mm_W2.6mm_P2.50mm | 7
C6, C7, C12 | 220nF | Capacitor_THT:C_Disc_D3.8mm_W2.6mm_P2.50mm | 3
C8 | 1uF/10V | Capacitor_THT:CP_Radial_D5.0mm_P2.50mm | 1
C9, C10 | 3n3 | Capacitor_THT:C_Disc_D3.8mm_W2.6mm_P2.50mm | 2
C14 | 100uF | Capacitor_THT:CP_Radial_D5.0mm_P2.50mm | 1
D2 | 1N4151 | Diode_THT:D_DO-41_SOD81_P7.62mm_Horizontal | 1
J1 | ZW, ZK CA80 | IDC 26 | 1
J2 | ZA | PinHeader_1x06_P2.54mm_Angle | 1
J4 | RCbus | PinHeader_2x40_P2.54mm_Angle | 1
J5 | CA80/MSID RTS | PinHeader_1x03_P2.54mm_Angle | 1
R11, R12, R14 | 820R | Resistor_THT 1/8W | 3
R13, R20 | 10K | Resistor_THT 1/8W | 2
R15, R19 | 270k | Resistor_THT 1/8W | 2
R16-R18, R21 | 3k6 | Resistor_THT 1/8W | 4
R22 | 120R | Resistor_THT 1/8W | 1
RN1 | 8x4k7 | Resistor_THT:R_Array_SIP9 | 1
U7 | 82C55A | Package_DIP:DIP-40_W15.24mm | 1
U13 | 74HCT132 | Package_DIP:DIP-14_W7.62mm | 1
U14 | LM741 | Package_DIP:DIP-8_W7.62mm | 1
U15 | 74HCT123 | Package_DIP:DIP-16_W7.62mm | 1
U16 | 74HCT138 | Package_DIP:DIP-16_W7.62mm | 1

SYS IO
