ZegarNotAvailable/CloneFactory/Z80-Tester/Schematic/Tester-mini-BOM.pdf

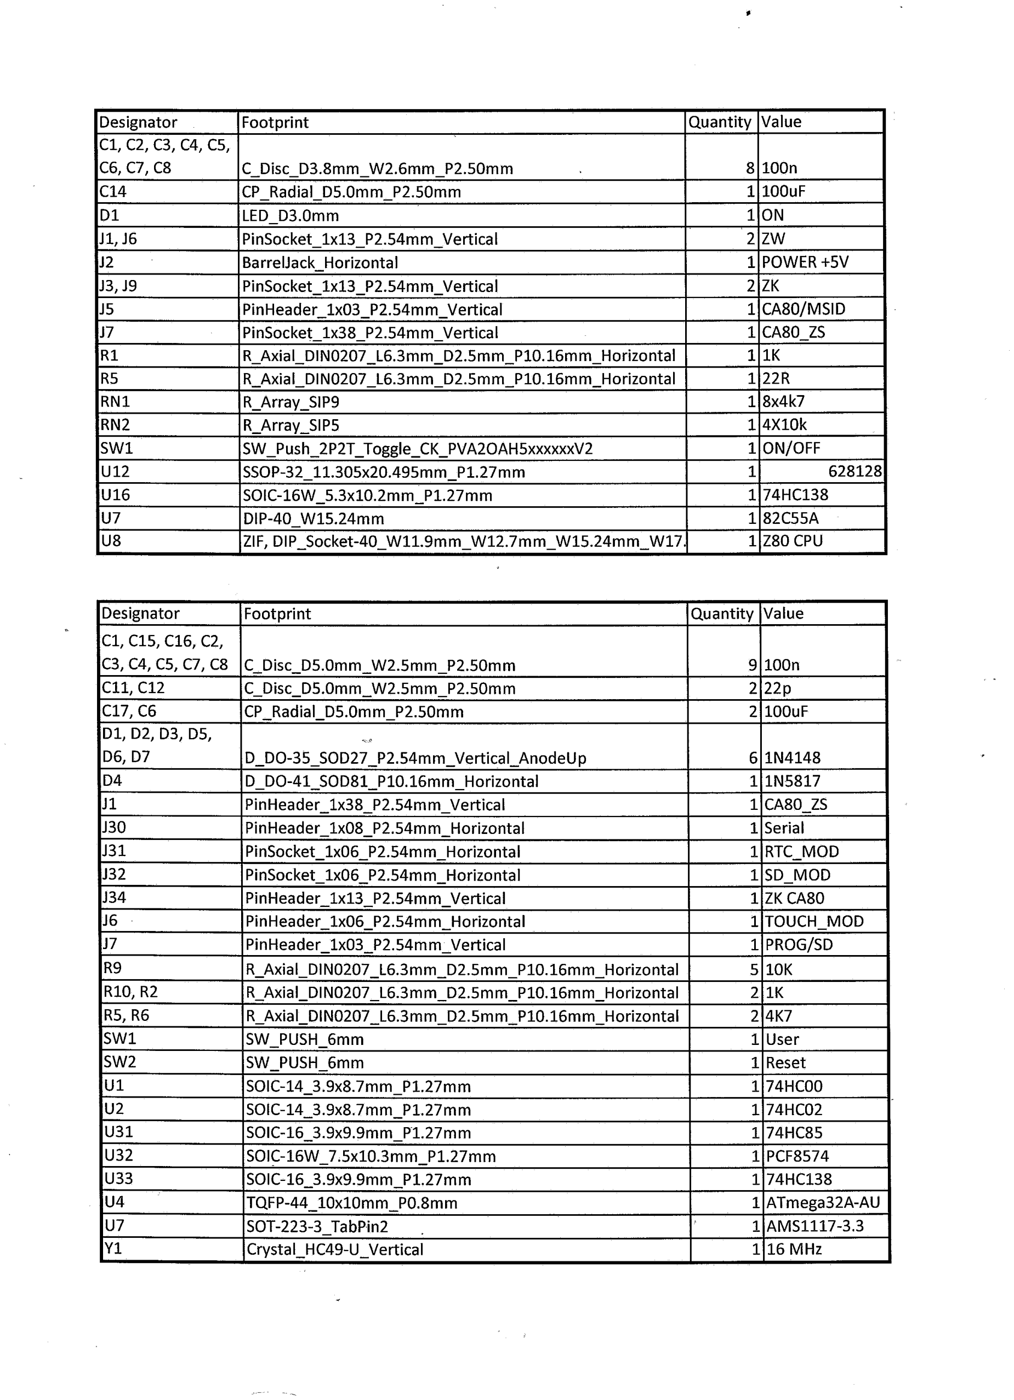
[picture p50: page 1]
