ZegarNotAvailable/CloneFactory/CA80-mini/HW/Pics/Touch-parts.jpg

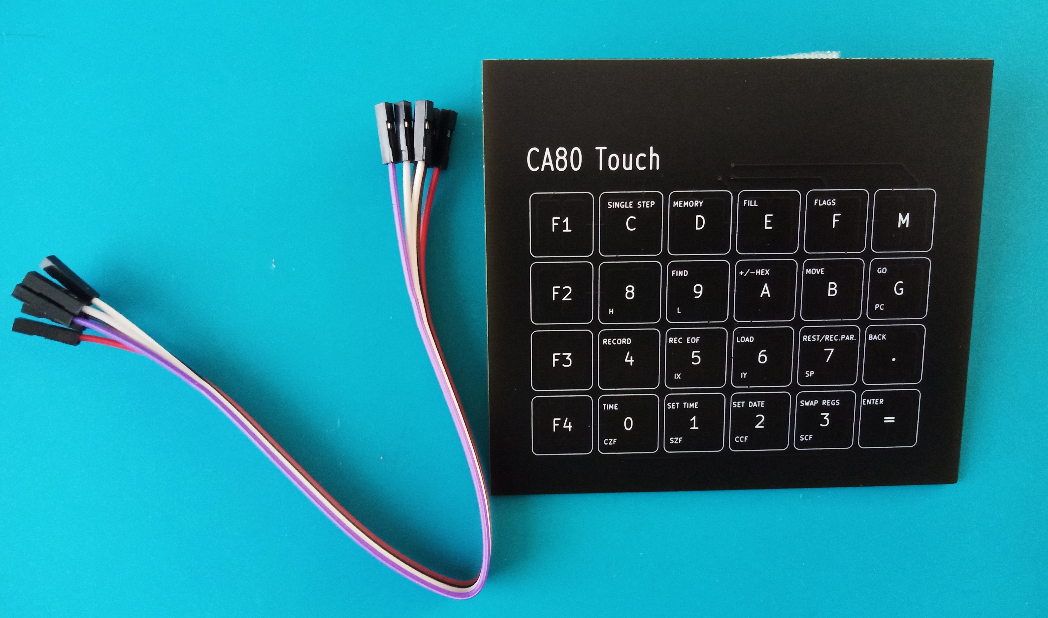
CA80-mini/HW/Pics/Touch-parts.jpg
