ZegarNotAvailable/CloneFactory/Z80-Tester/Schematic/Z80-tester-RC.jpg

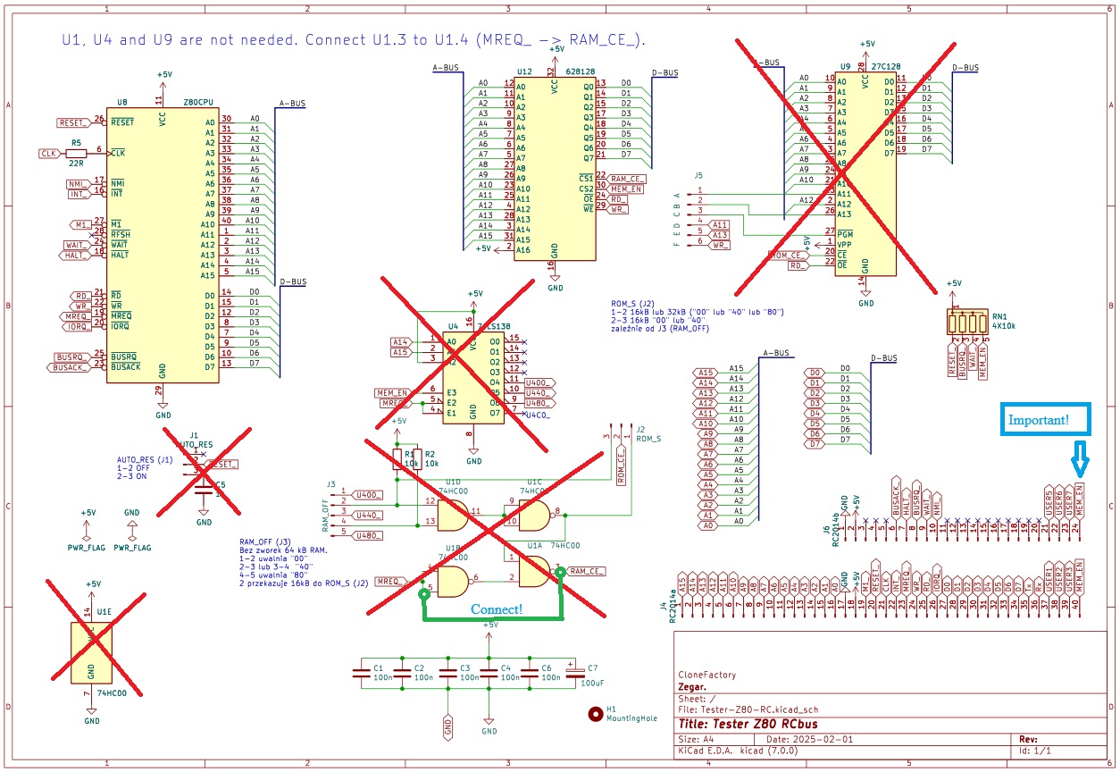
Z80-Tester/Schematic/Z80-tester-RC.jpg
