ZegarNotAvailable/CloneFactory/Z80-Tester/Schematic/Tester-Z80-mini12.pdf

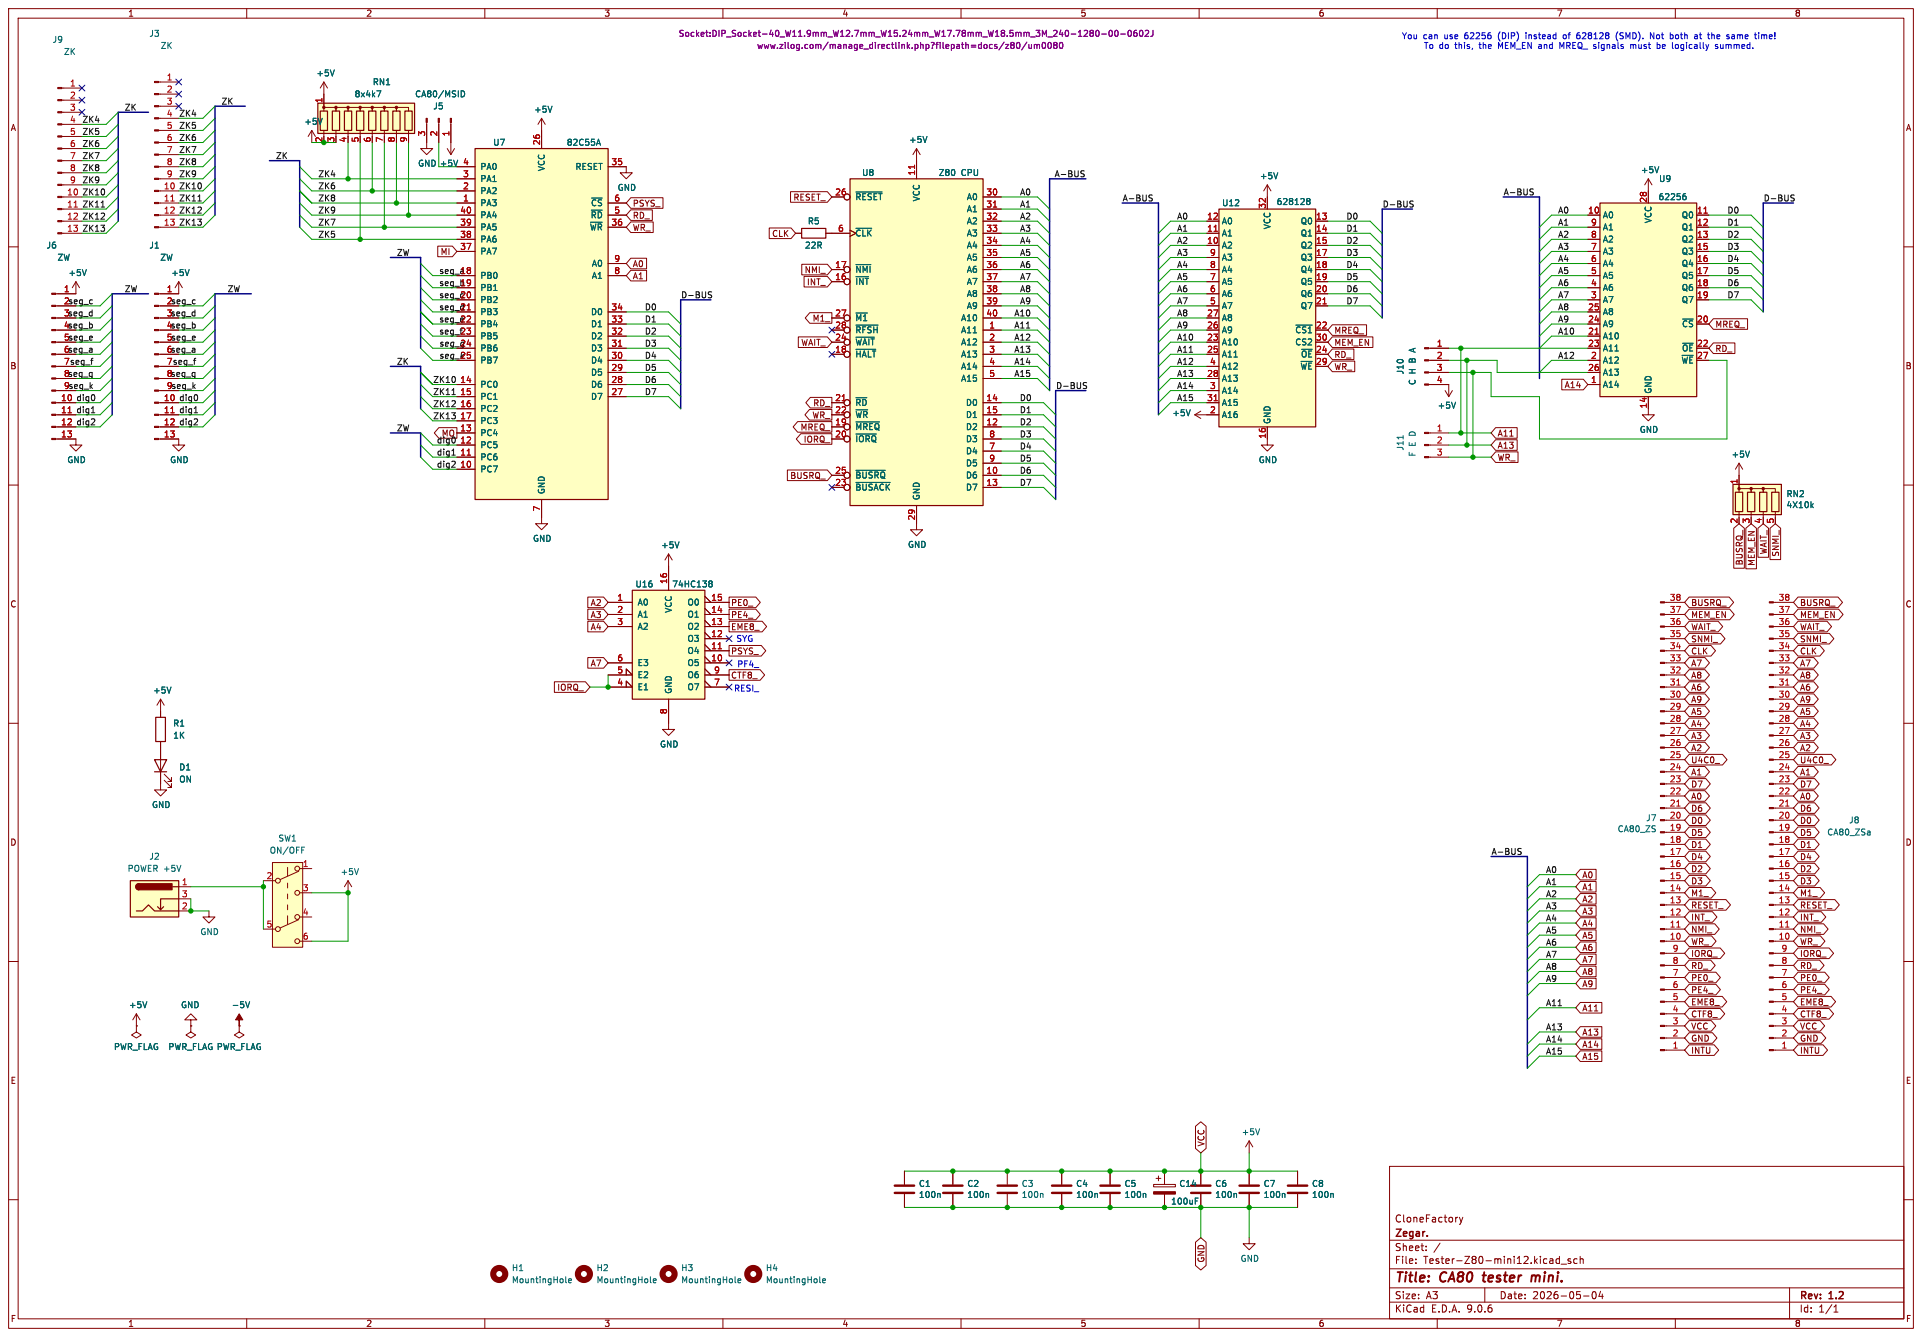
[picture p54: page 1]

Socket:DIP_Socket-40_W11.9mm_W12.7mm_W15.24mm_W17.78mm_W18.5mm_3M_240-1280-00-0602J www.zilog.com/manage_directlink.php?filepath=docs/z80/um0080

7 PA0 4 PA1 3 PA2 2 PA3 1 PA4 40 PA5 39 PA6 38 PA7 37 PB0 18 PB1 19 PB2 20 PB3 21 PB4 22 PB5 23 PB6 24 PB7 25 PC0 14 PC1 15 PC2 16 PC3 17 PC4 13 PC5 12 PC6 11 PC7 10 U12 628128 VCC 32 GND 16 A0 12 A1 11 A2 10 A3 9 A4 8 A5 7 A6 6 A7 5 A8 27 A9 26 A10 23 A11 25 A12 4 A13 28 A14 3 A15 31 A16 2 Q0 13 Q1 14 Q2 15 Q3 17 Q4 18 Q5 19 Q6 20 Q7 21 ~{CS1}22 CS2 30 ~{OE} 24 ~{WE} 29 +5V

19 ~{CS} 20 ~{OE} 22 ~{WE} 27 GND

CloneFactory
Id: 1/1 Title: CA80 tester mini. File: Tester-Z80-mini12.kicad_sch Sheet: / Zegar.
