ZegarNotAvailable/CloneFactory/Z80-Tester/Schematic/Tester-Z80-mini.pdf

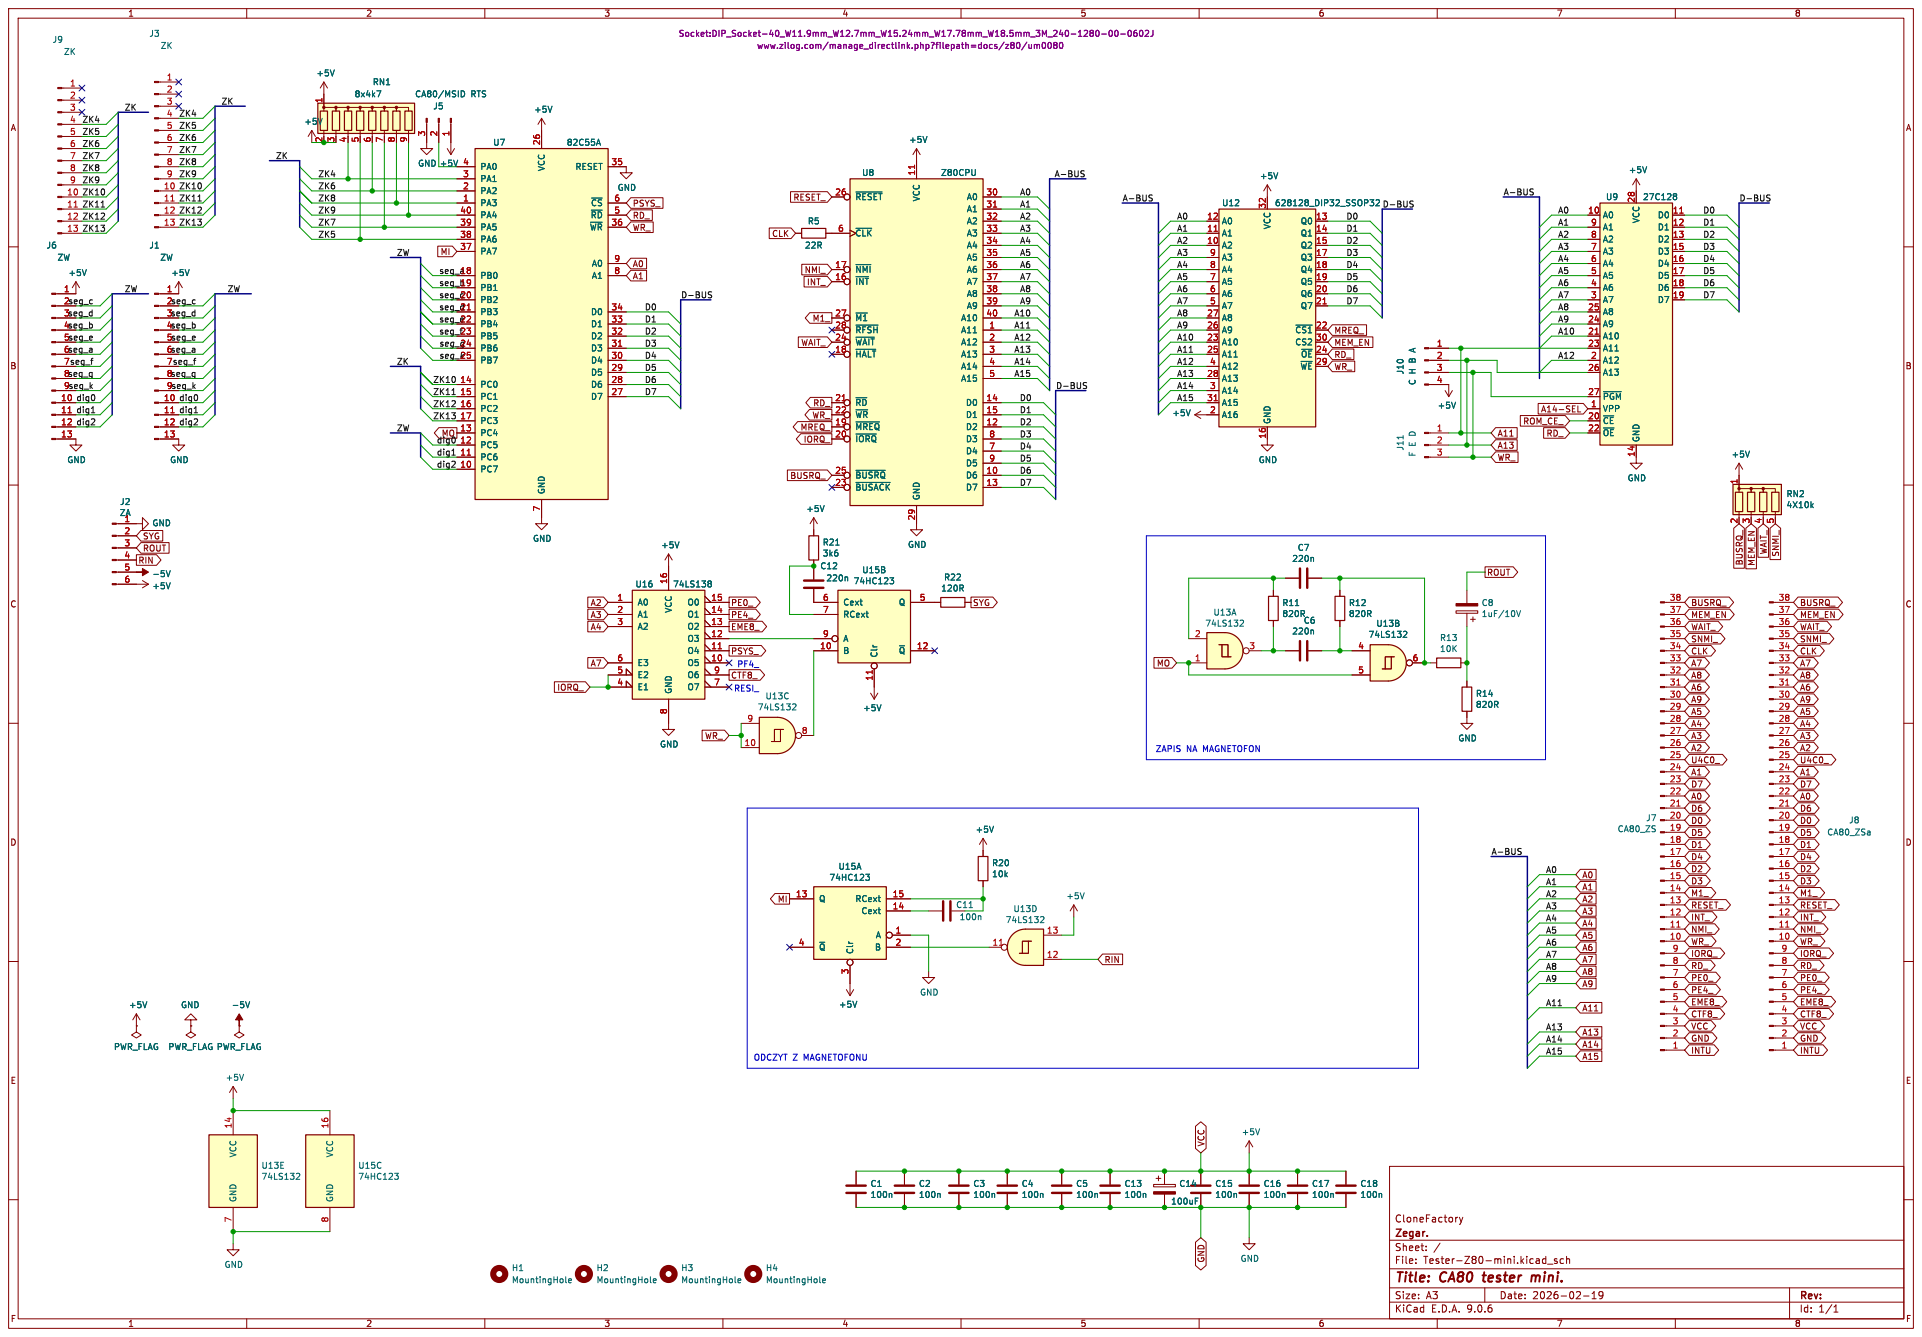
[picture p55: page 1]
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

Id: 1/1 Title: CA80 tester mini. File: Tester-Z80-mini.kicad_sch Sheet: / Zegar.
