ZegarNotAvailable/CloneFactory/Z80-Tester/Schematic/Tester-Z80-RC.pdf

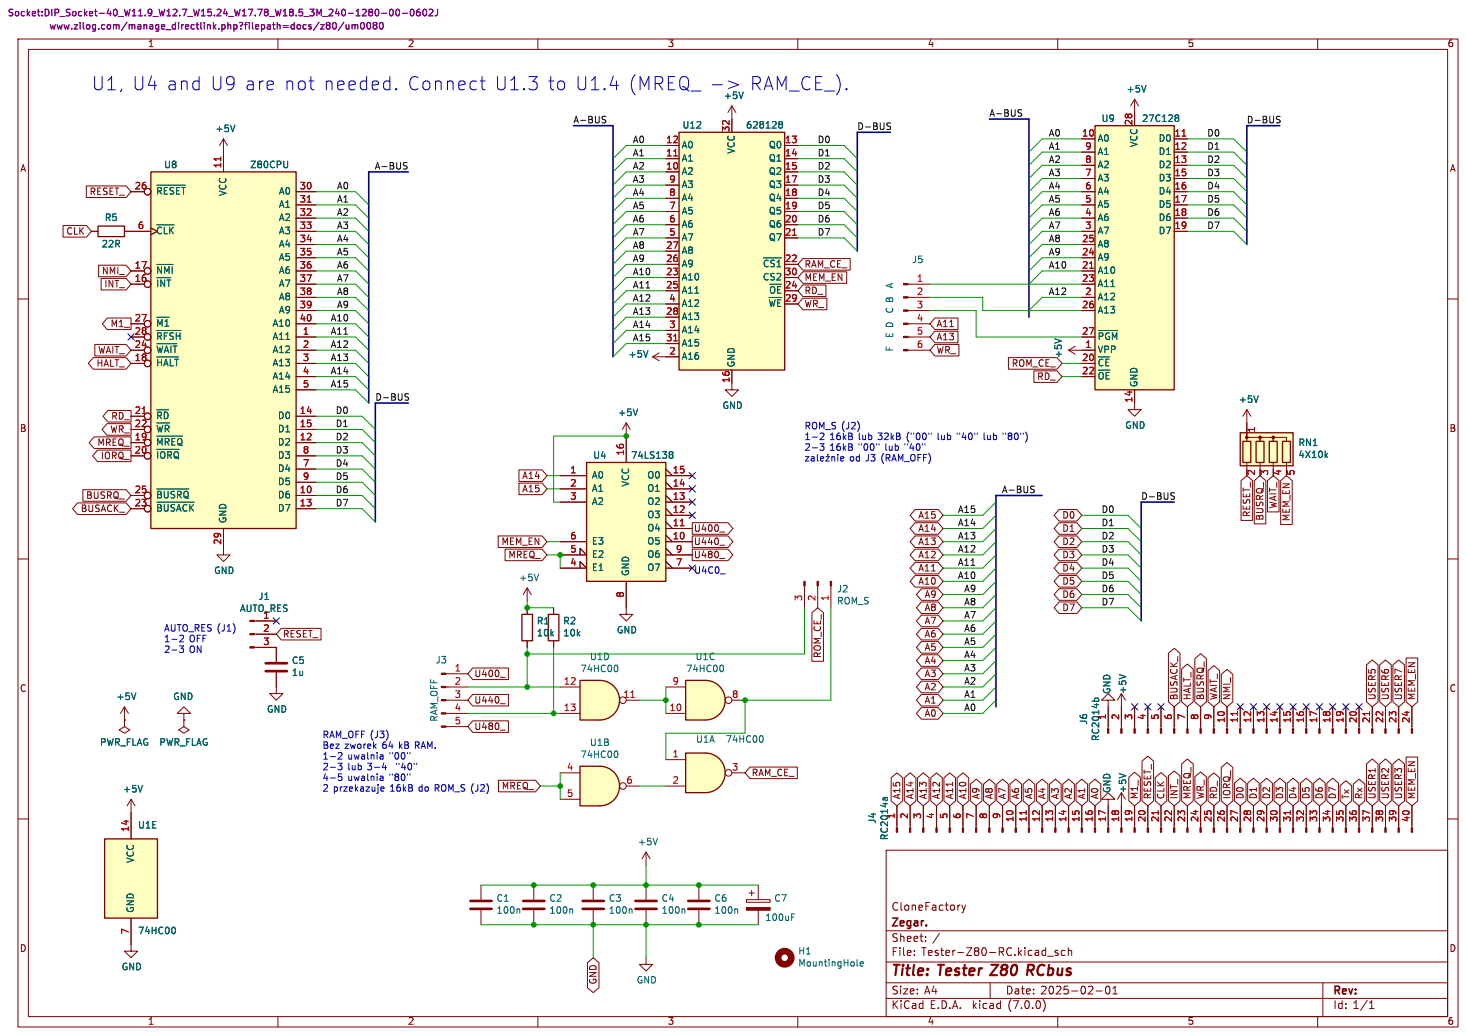
[picture p56: page 1]

Socket:DIP_Socket-40_W11.9_W12.7_W15.24_W17.78_W18.5_3M_240-1280-00-0602J www.zilog.com/manage_directlink.php?filepath=docs/z80/um0080 R5

5 +5V U9 27C128 VPP 1 A0 10 D0 11 D1 12 D2 13 GND 14 D3 15 D4 16 D5 17 D6 18 D7 19 A12 2 ~{CE} 20 A10 21 ~{OE} 22 A11 23 A9 24 A8 25 A13 26 ~{PGM} 27 VCC 28 A7 3 A6 4 A5 5 A4 6 A3 7 A2 8 A1 9 +5V

File: Tester-Z80-RC.kicad_sch Sheet: / Zegar.

Id: 1/1 Title: Tester Z80 RCbus
