ZegarNotAvailable/CloneFactory/CA80-Cube/HW/Schematics/CA80-FLASH-CF.pdf

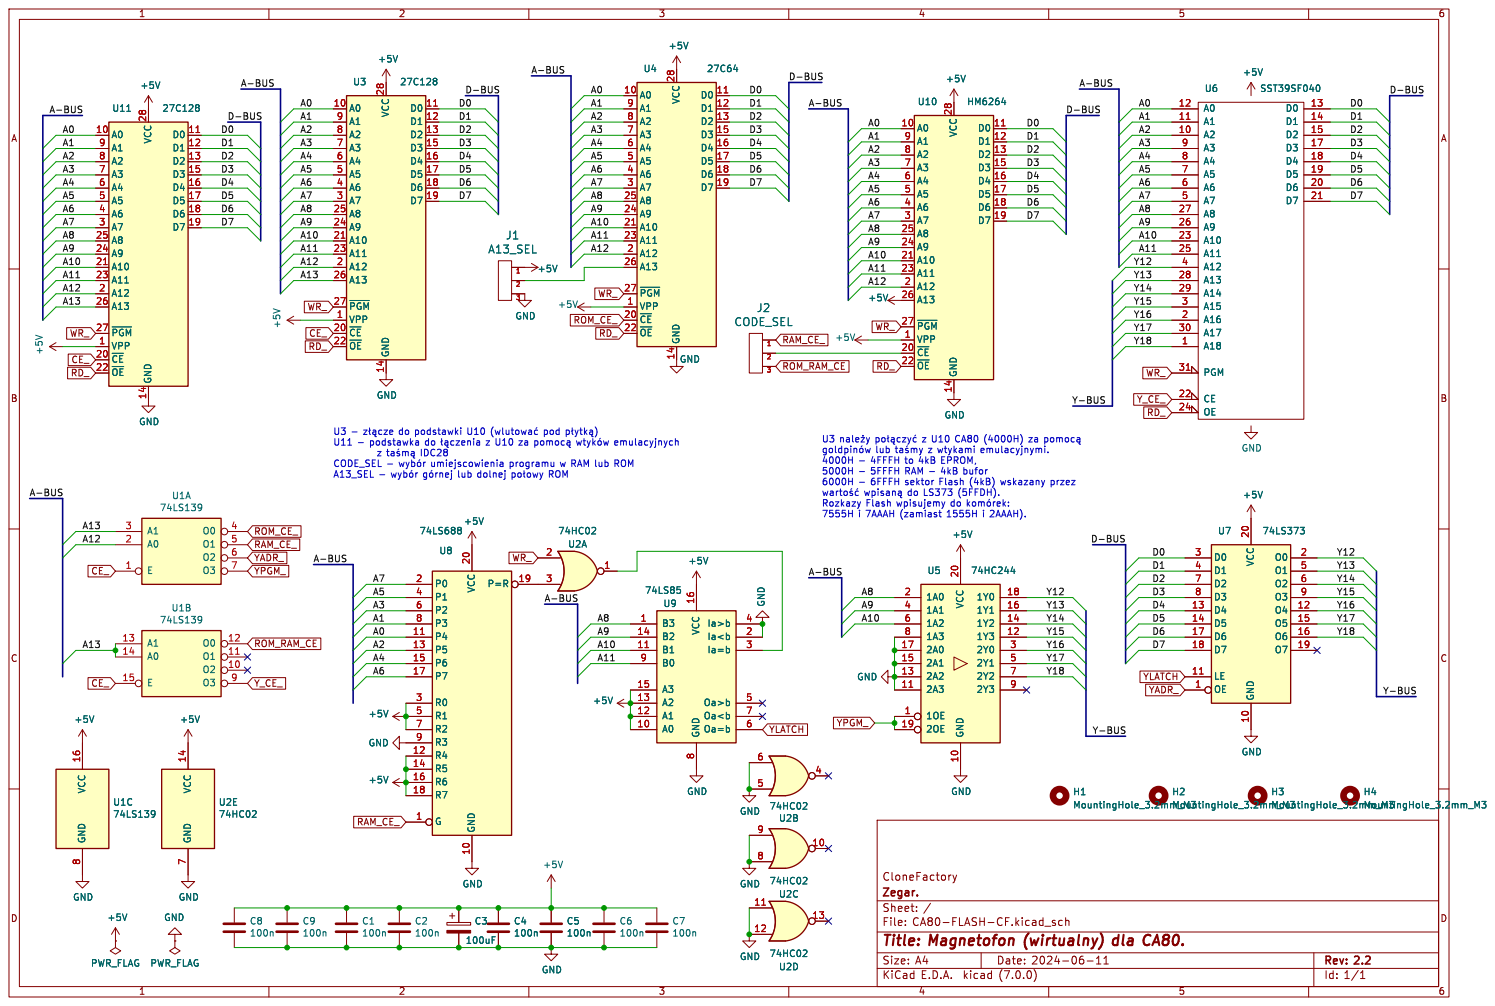
[picture p57: page 1]

Rozkazy Flash wpisujemy do þÿkomórek: 7555H i 7AAAH (zamiast 1555H i 2AAAH). U3 - þÿzBcze do podstawki U10 þÿ(wlutowa pod þÿpBytk) U11 - podstawka do þÿBczenia z U10 za þÿpomoc þÿwtyków emulacyjnych

þÿgoldpinów lub þÿta[my z wtykami emulacyjnymi. 4000H - 4FFFH to 4kB EPROM, 5000H - 5FFFH RAM - 4kB bufor 6000H - 6FFFH sektor Flash (4kB) wskazany przez þÿwarto[ þÿwpisan do LS373 (5FFDH).

A13_SEL - þÿwybór þÿgórnej lub dolnej þÿpoBowy ROM

Id: 1/1 Title: Magnetofon (wirtualny) dla CA80. File: CA80-FLASH-CF.kicad_sch Sheet: / Zegar.
