ZegarNotAvailable/CloneFactory/CA80-Cube/HW/Schematics/CA80_mini.pdf

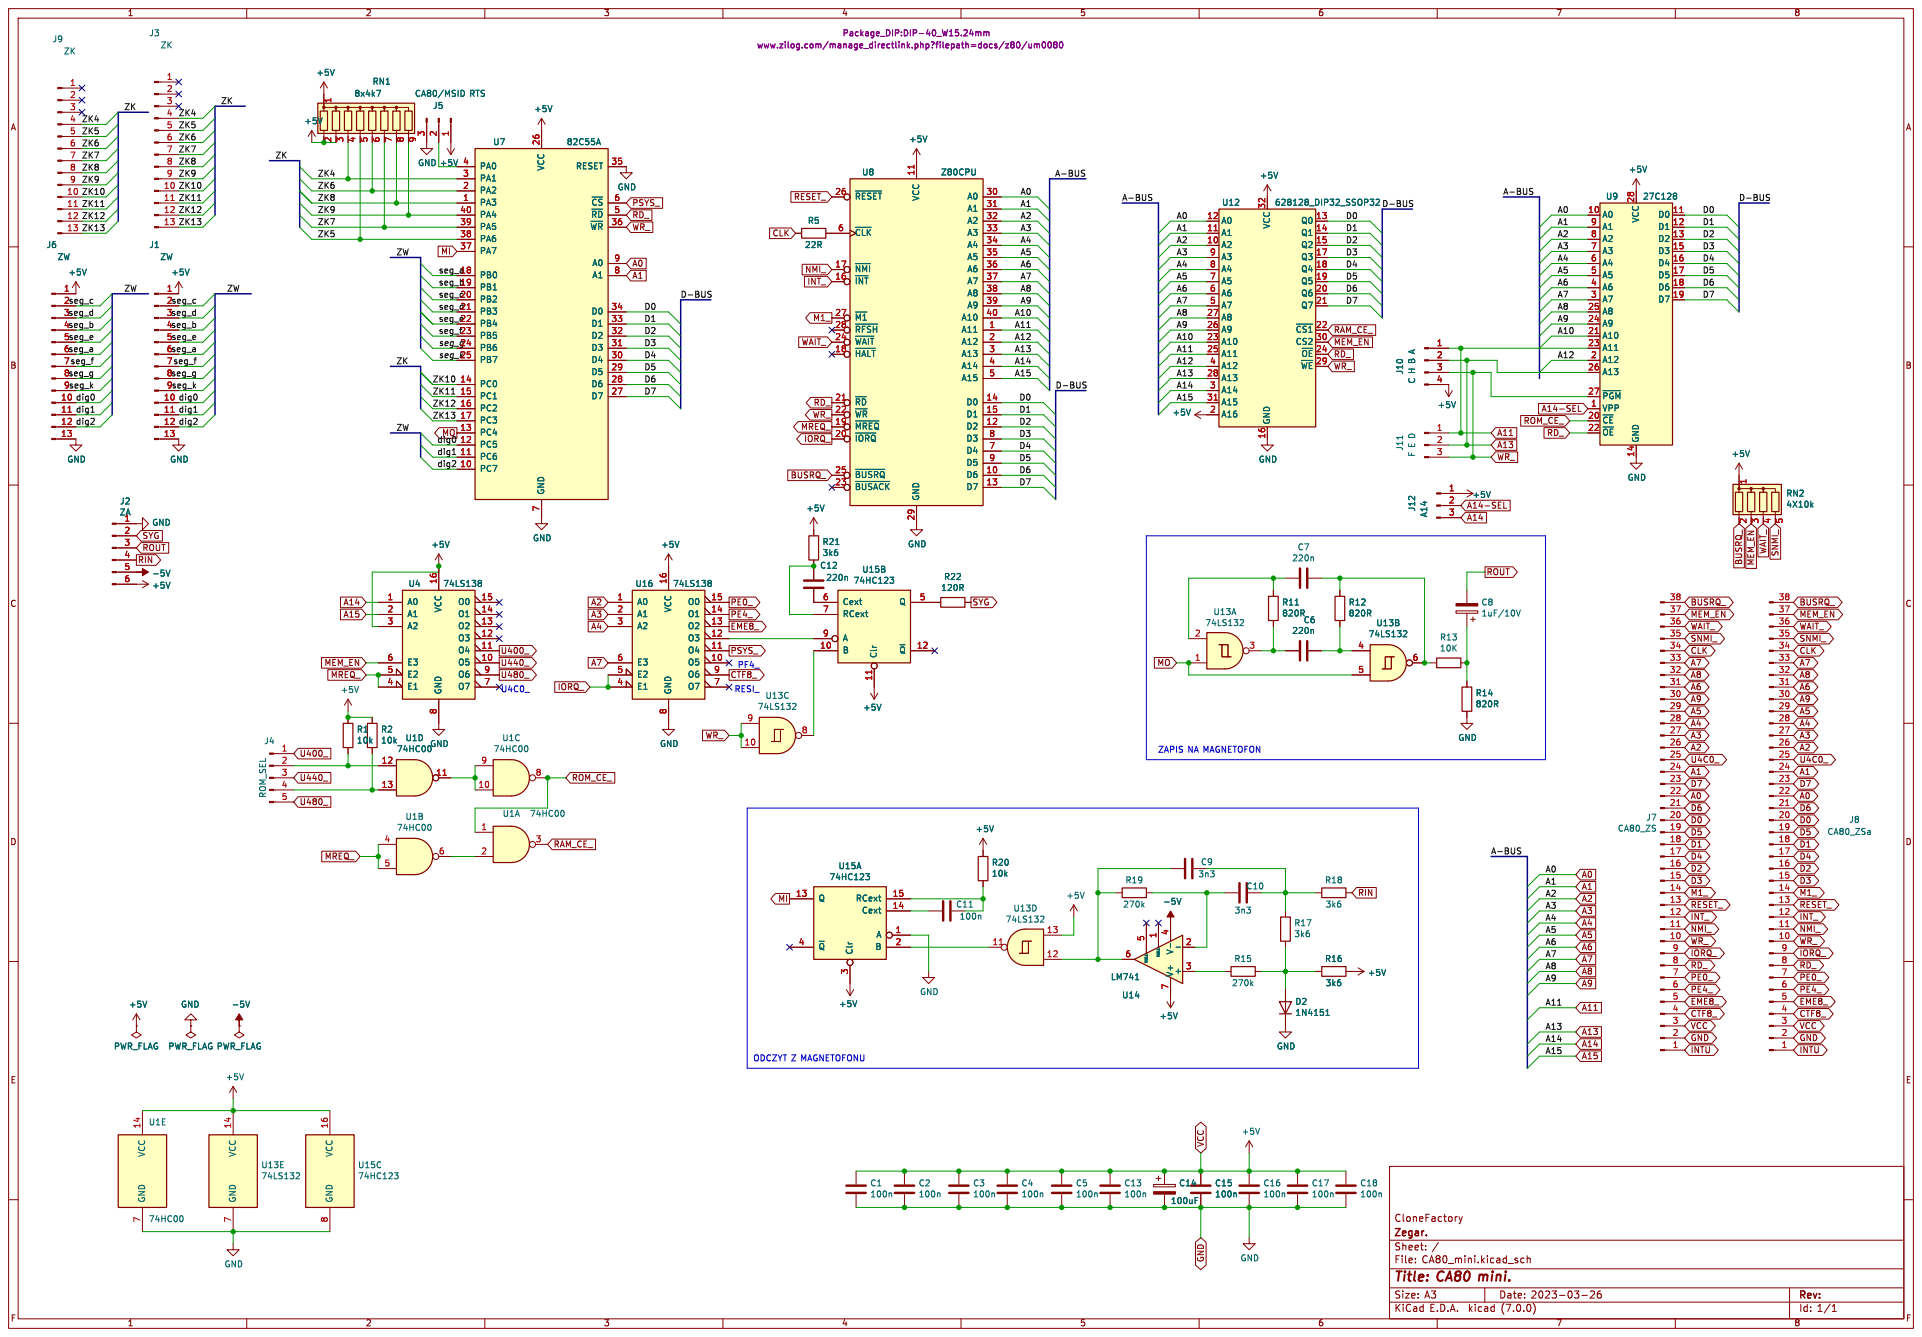
[picture p58: page 1]

Id: 1/1 Title: CA80 mini. File: CA80_mini.kicad_sch Sheet: / Zegar.
