ZegarNotAvailable/CloneFactory/HardWare/MIK89-PLCC/MIK89-RC-PLCC.pdf

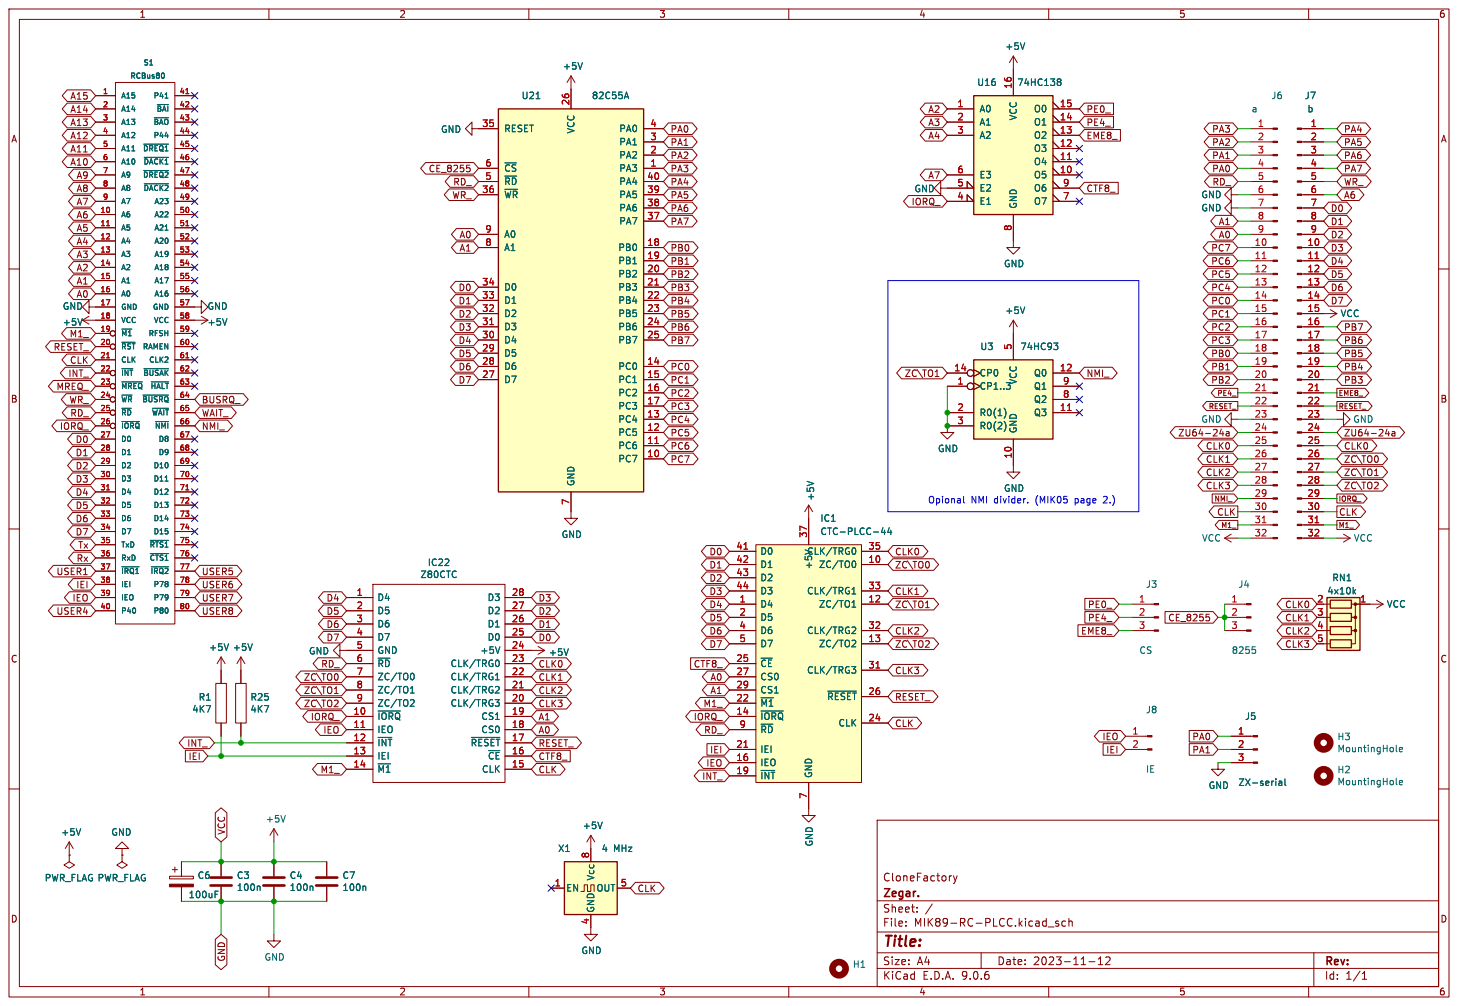
[picture p59: page 1]

7 CLK/TRG0 35 ZC/TO0 10 CLK/TRG1 33 ZC/TO1 12 CLK/TRG2 32 ZC/TO2 13 CLK/TRG3 31 ~{RESET}26 CLK 24 +5V GND

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
