ZegarNotAvailable/CloneFactory/HardWare/CPU-N/CA80-CPU-12.pdf

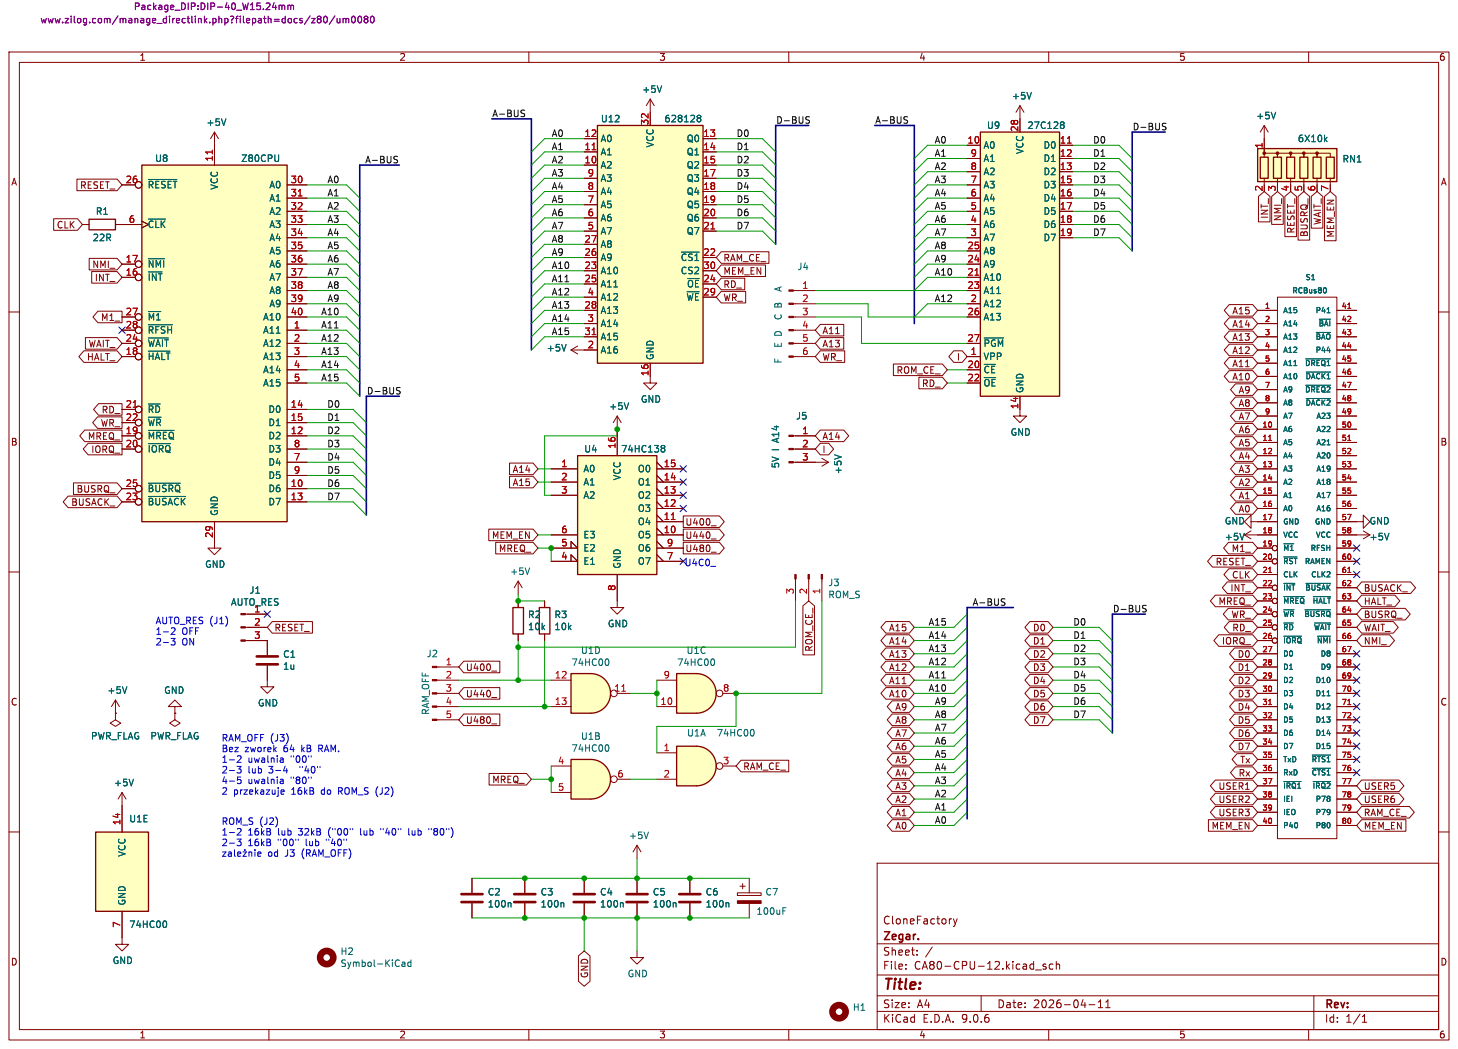
[picture p60: page 1]

www.zilog.com/manage_directlink.php?filepath=docs/z80/um0080

7 +5V U9 27C128 A0 10 A1 9 A2 8 A3 7 A4 6 A5 5 A6 4 A7 3 A8 25 A9 24 A10 21 A11 23 A12 2 A13 26 ~{PGM} 27 VPP 1 ~{CE} 20 ~{OE} 22 VCC 28 GND 14 D0 11 D1 12 D2 13 D3 15 D4 16 D5 17 D6 18 D7 19 +5V U12 628128 VCC 32 GND 16 A0 12 A1 11 A2 10 A3 9 A4 8 A5 7 A6 6 A7 5 A8 27 A9 26 A10 23 A11 25 A12 4 A13 28 A14 3 A15 31 A16 2 Q0 13 Q1 14 Q2 15 Q3 17 Q4 18 Q5 19 Q6 20 Q7 21 ~{CS1}22 CS2 30 ~{OE} 24 ~{WE} 29 GND

Id: 1/1 Title: File: CA80-CPU-12.kicad_sch Sheet: / Zegar.
