ZegarNotAvailable/CloneFactory/HardWare/CA80-flash/CA80_flash_RCbus.pdf

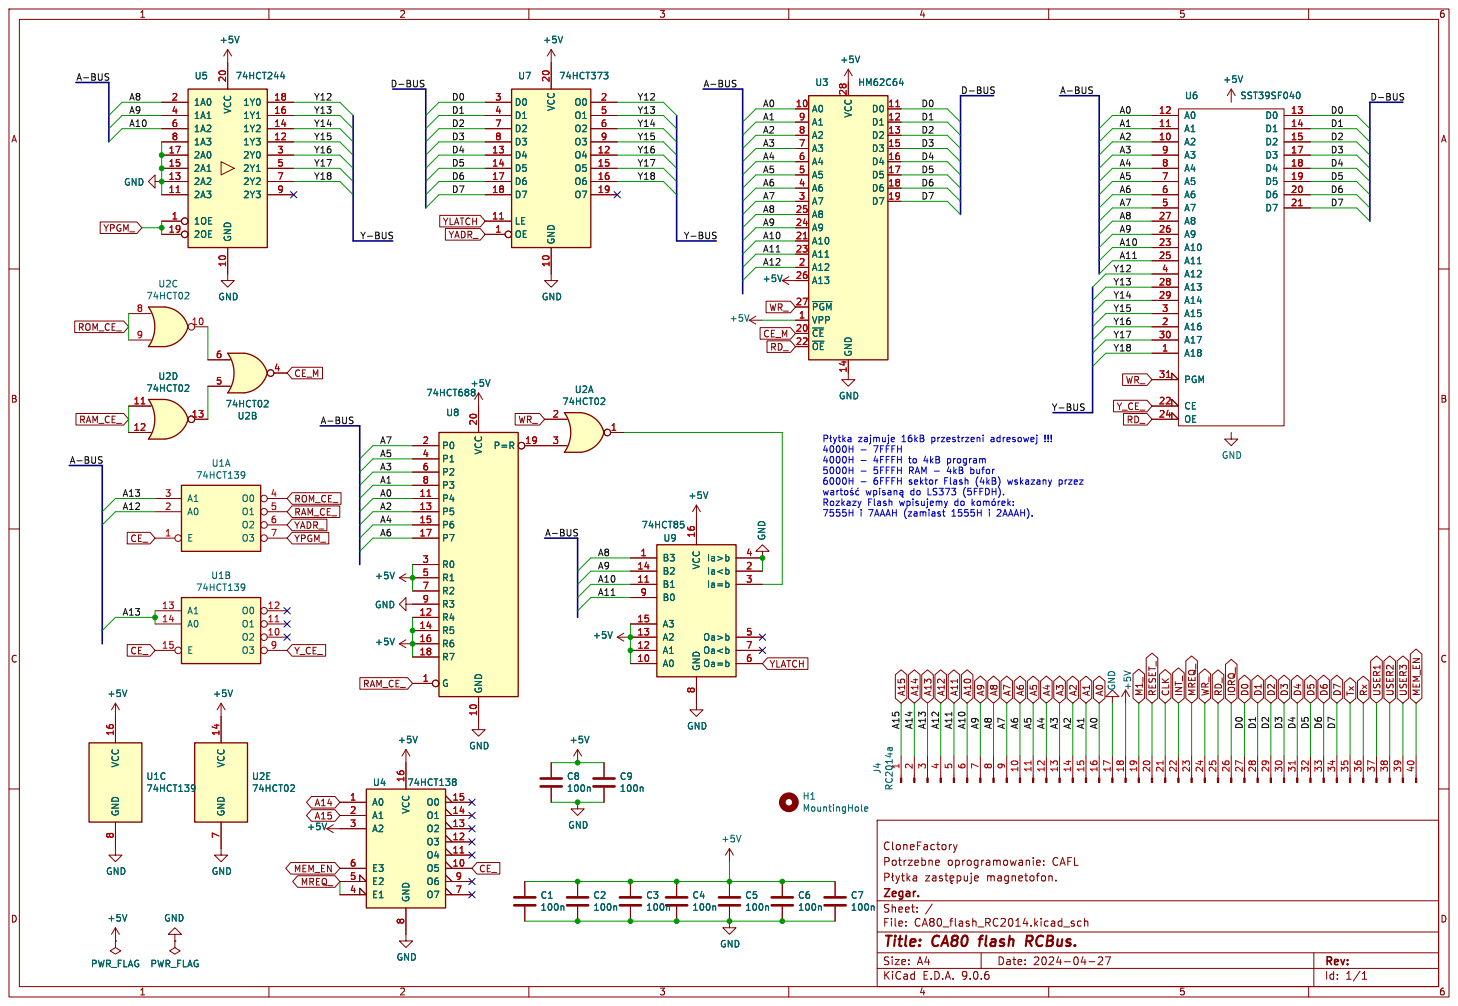
[picture p61: page 1]

4000H - 4FFFH to 4kB program
5000H - 5FFFH RAM - 4kB bufor 6000H - 6FFFH sektor Flash (4kB) wskazany przez þÿwarto[ þÿwpisan do LS373 (5FFDH).

Id: 1/1 Title: CA80 flash RCBus. File: CA80_flash_RC2014.kicad_sch Sheet: / Zegar.
