ZegarNotAvailable/CloneFactory/HardWare/MIK1/MIK1-RC.pdf

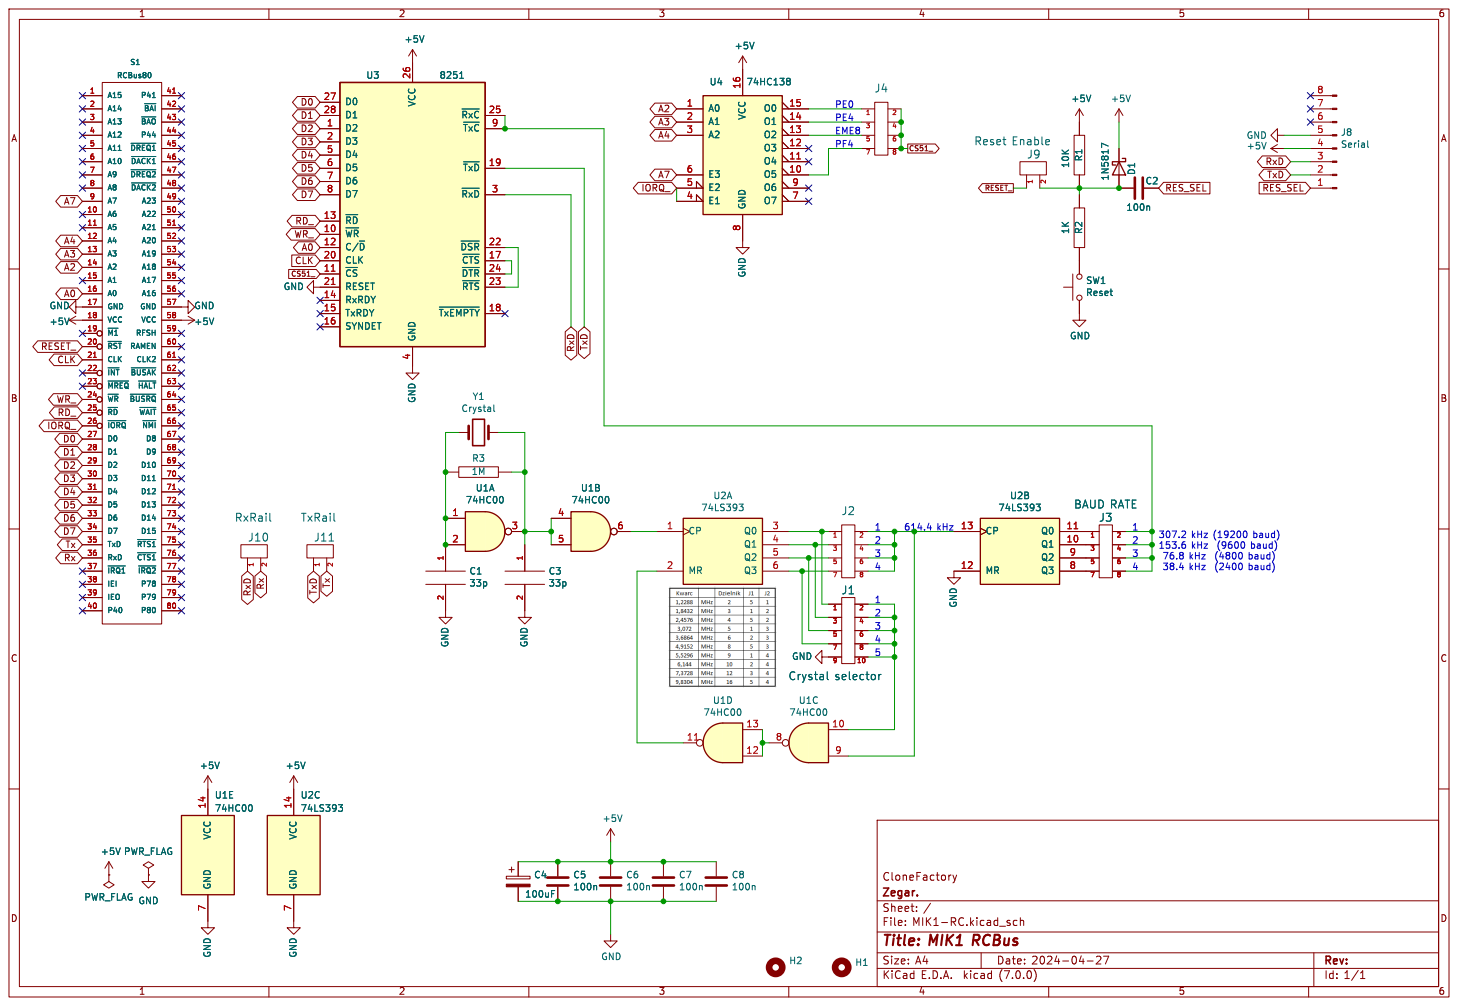
[picture p62: page 1]

CloneFactory
File: MIK1-RC.kicad_sch Sheet: / Zegar.
