ZegarNotAvailable/CloneFactory/HardWare/MIK1-PROTO/MIK1_RC2014.pdf

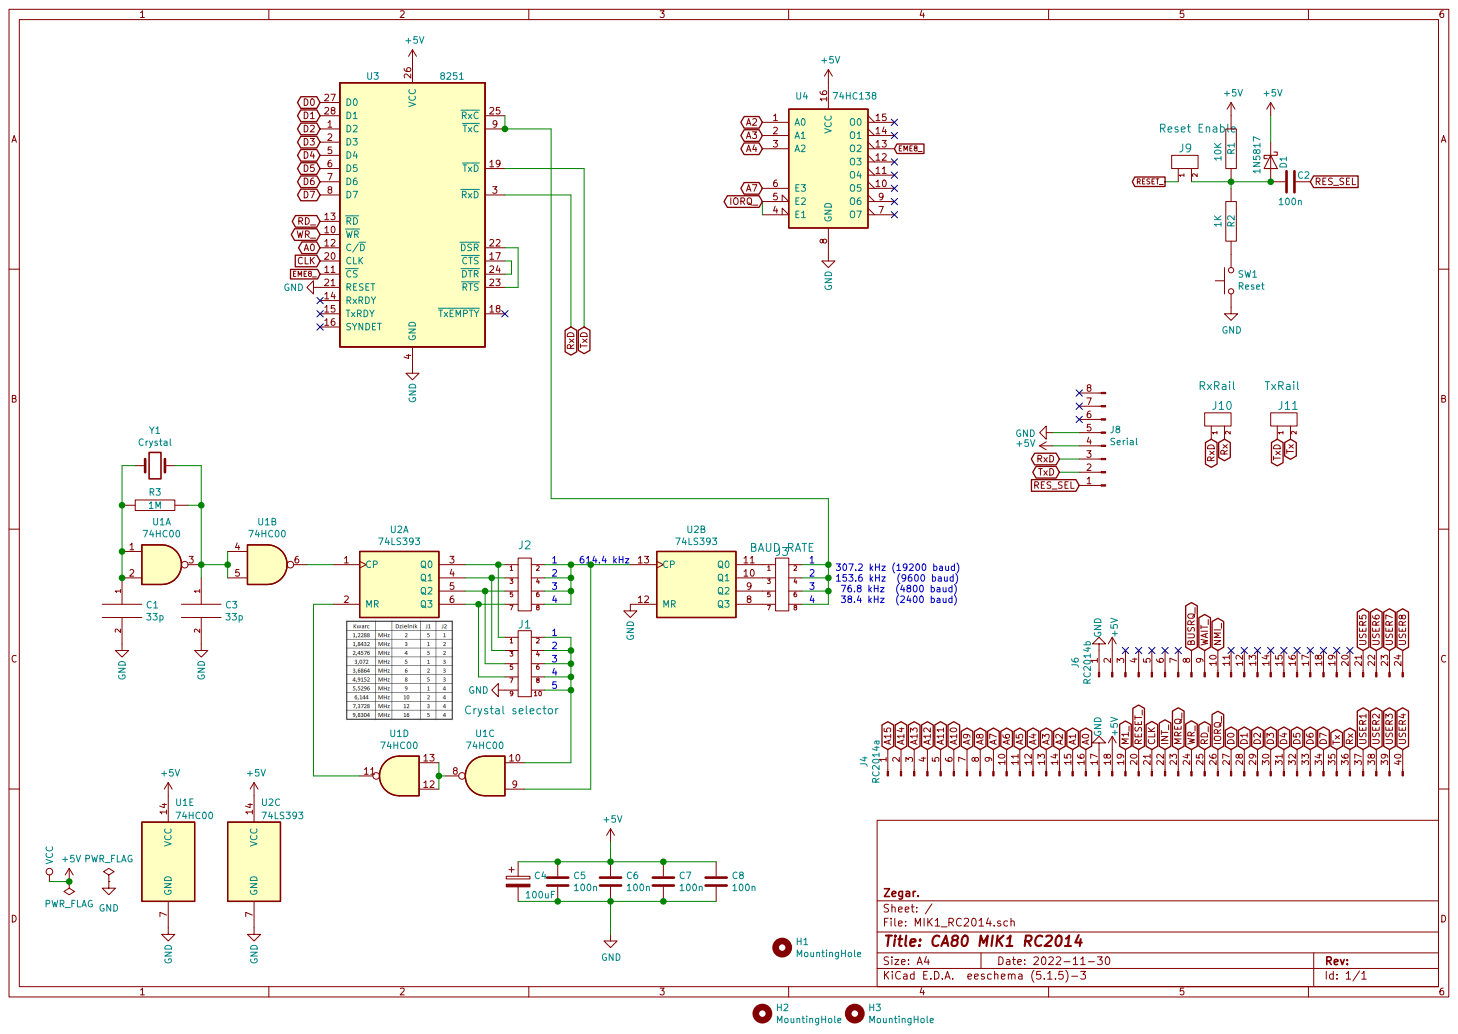
[picture p63: page 1]

File: MIK1_RC2014.sch Sheet: / Zegar. GND

3 | 4 3 | 3 | 4 3 | 38.4 kHz (2400 baud) 2
