ZegarNotAvailable/CloneFactory/HardWare/MIK89-n/CA80-MIK89-n.pdf

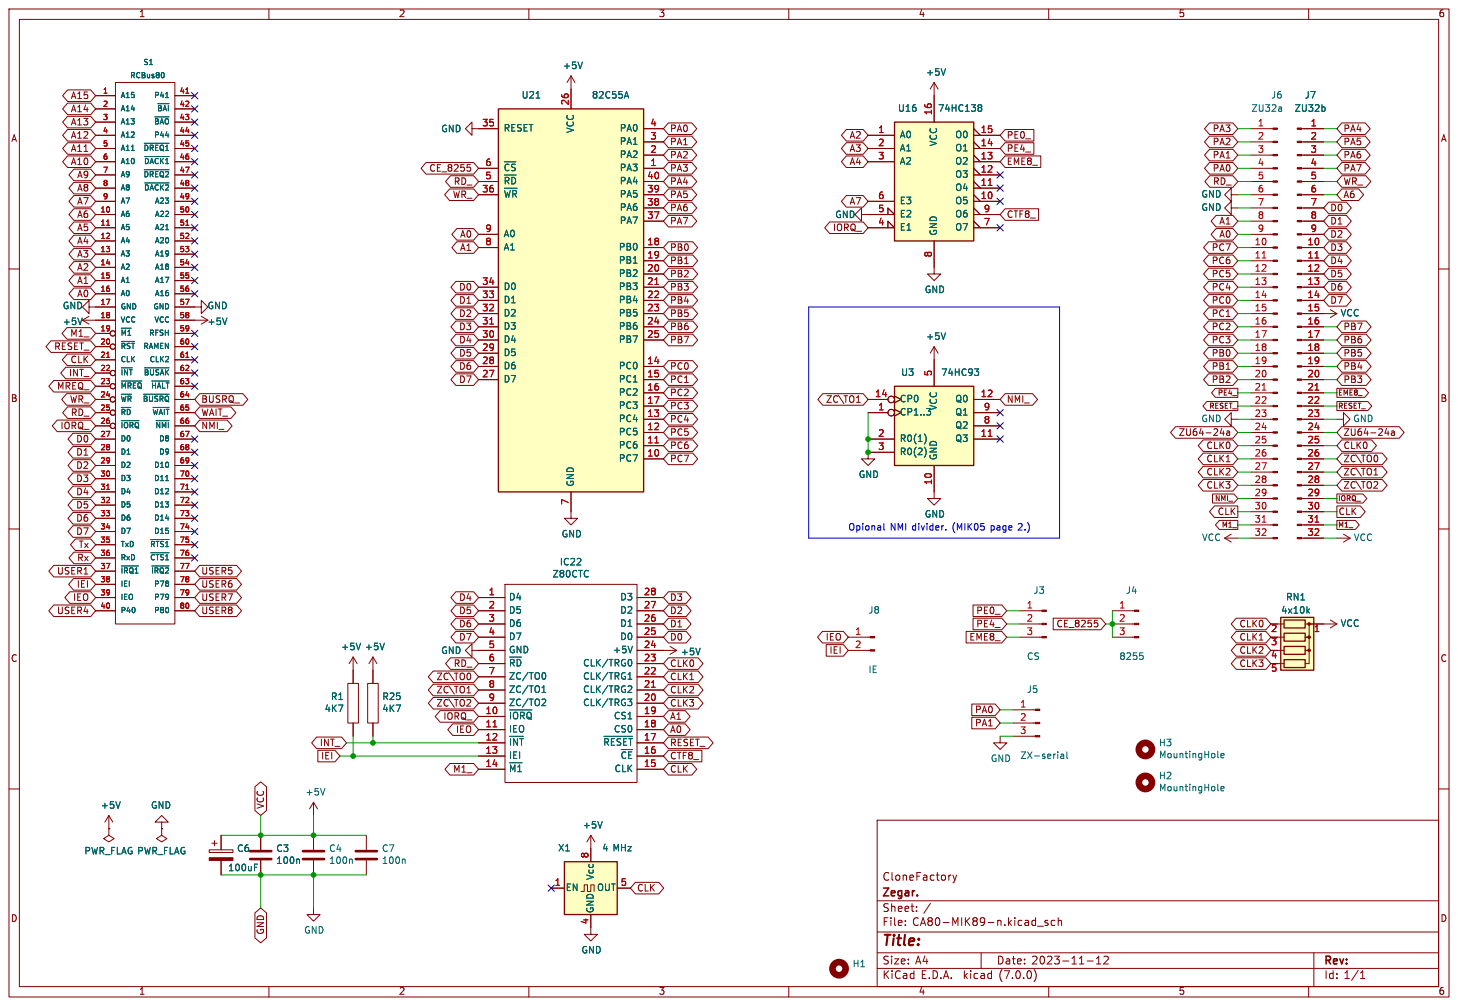
[picture p64: page 1]

J5 GND ZX-serial GND

Id: 1/1 Title: File: CA80-MIK89-n.kicad_sch Sheet: / Zegar.
