ZegarNotAvailable/CloneFactory/HardWare/CPU/CA80-CPU-RCbus.pdf

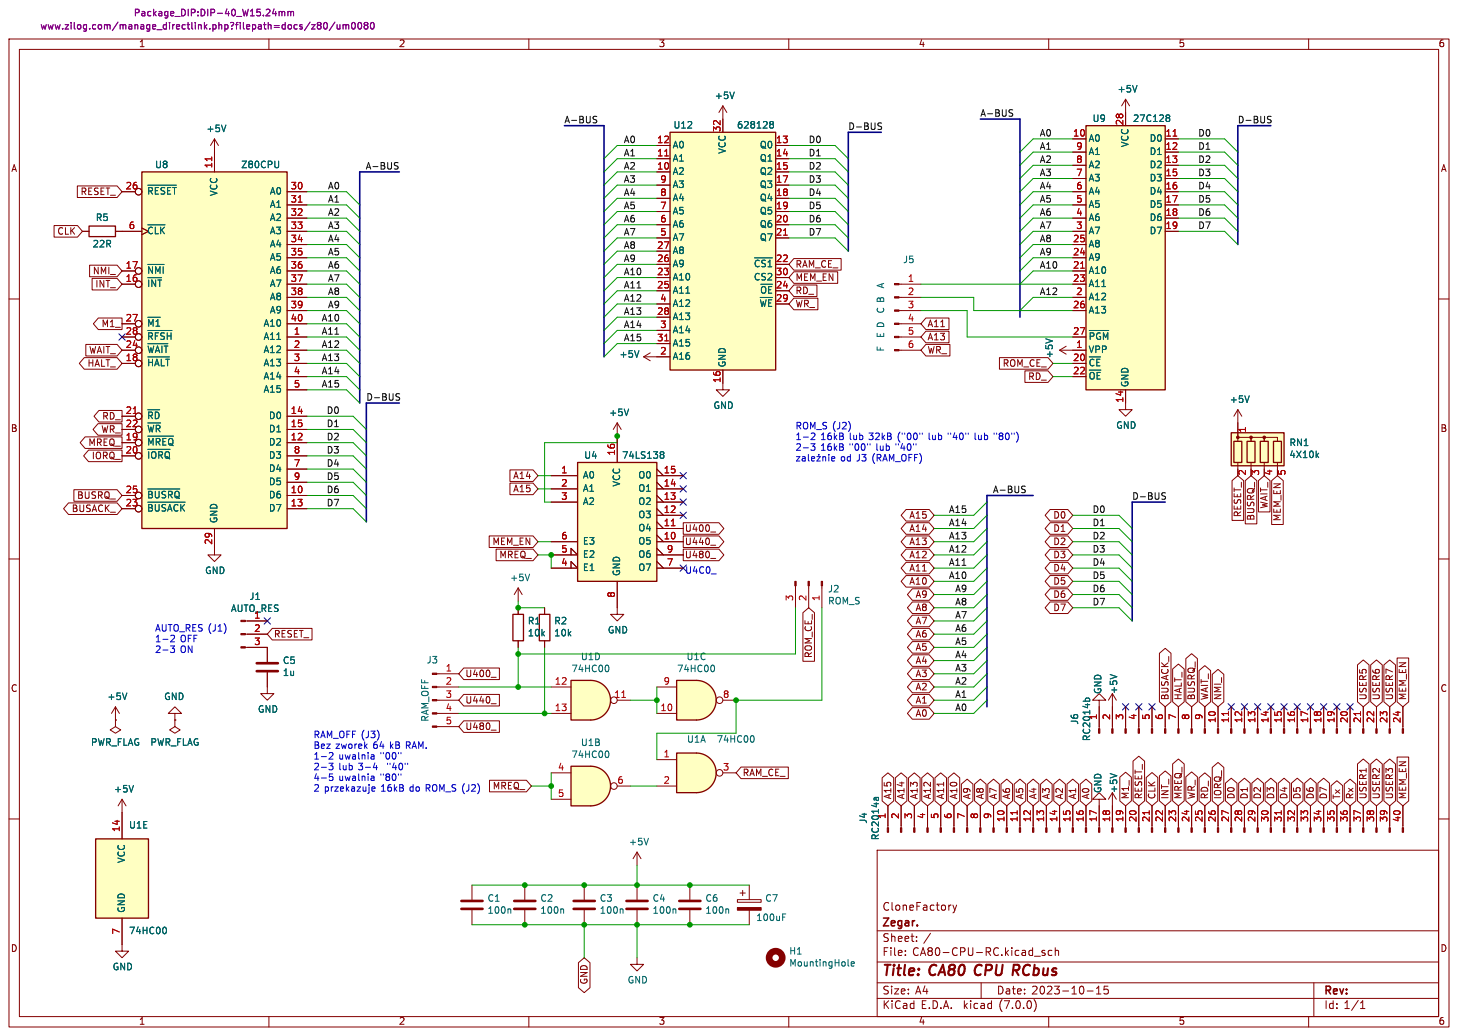
[picture p65: page 1]

www.zilog.com/manage_directlink.php?filepath=docs/z80/um0080

9J4 RC2014a VPP 1 A0 10 D0 11 D1 12 D2 13 GND 14 D3 15 D4 16 D5 17 D6 18 D7 19 A12 2 ~{CE} 20 A10 21 ~{OE} 22 A11 23 A9 24 A8 25 A13 26 ~{PGM} 27 VCC 28 A7 3 A6 4 A5 5 A4 6 A3 7 A2 8 A1 9 U9 27C128 GND 1 2

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

CloneFactory
File: CA80-CPU-RC.kicad_sch Sheet: / Zegar.

Id: 1/1 Title: CA80 CPU RCbus
