ZegarNotAvailable/CloneFactory/HardWare/SYS-IO/CA80-SYS-IO-RCbus.pdf

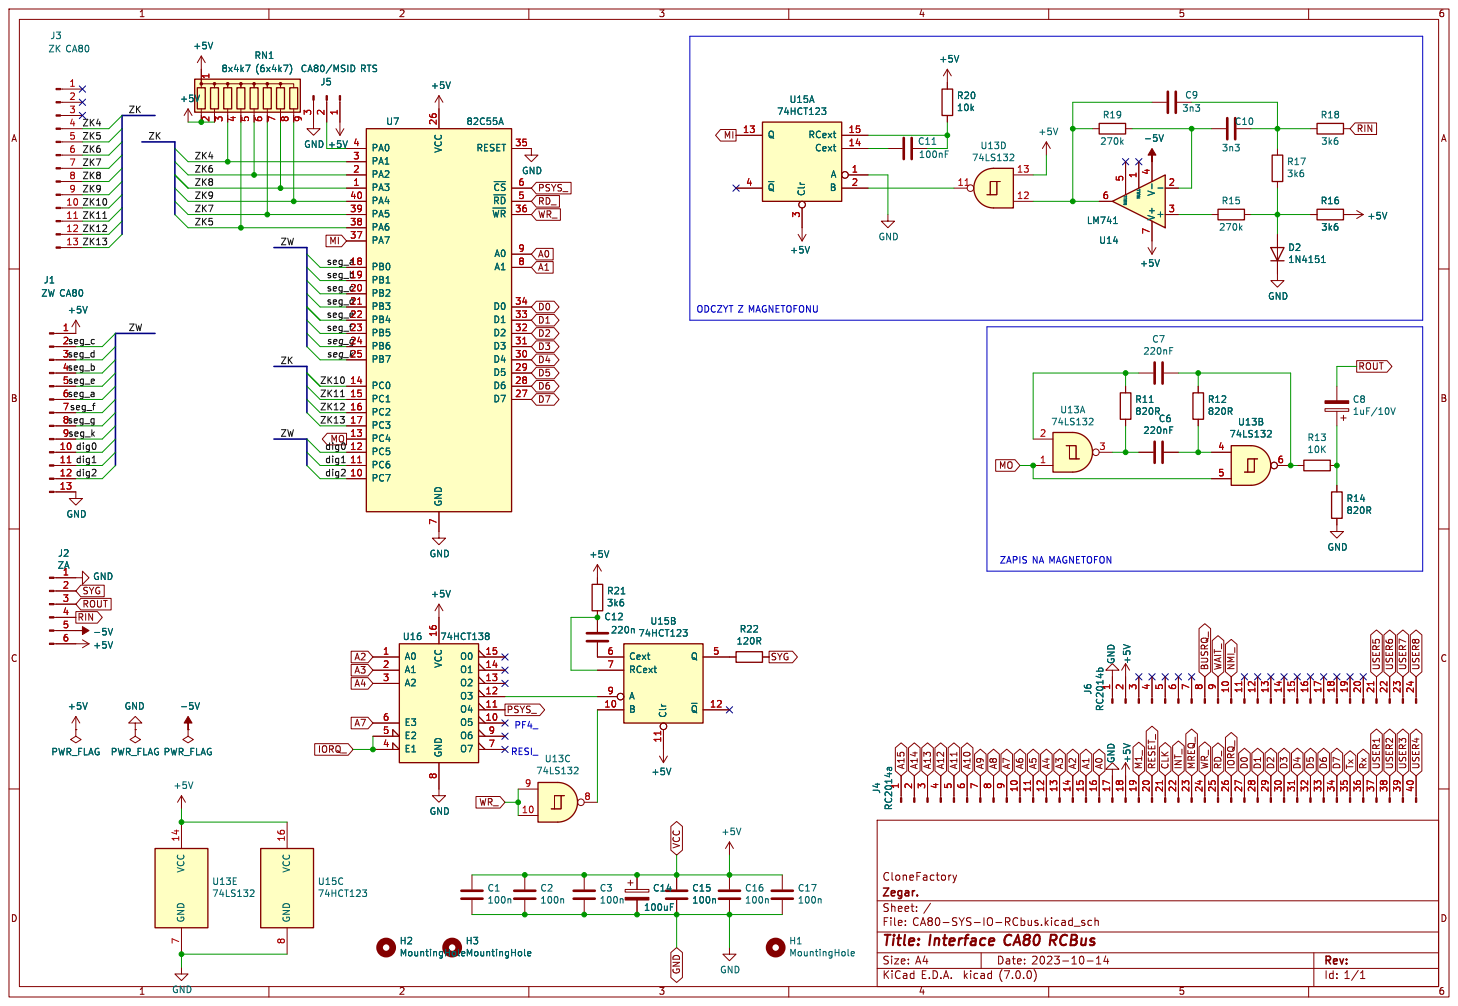
[picture p66: page 1]

File: CA80-SYS-IO-RCbus.kicad_sch Sheet: / Zegar.

Id: 1/1 Title: Interface CA80 RCBus
