ZegarNotAvailable/CloneFactory/CA80-Cube/HW/Schematics/CA80_Klaw_Elwro144.pdf

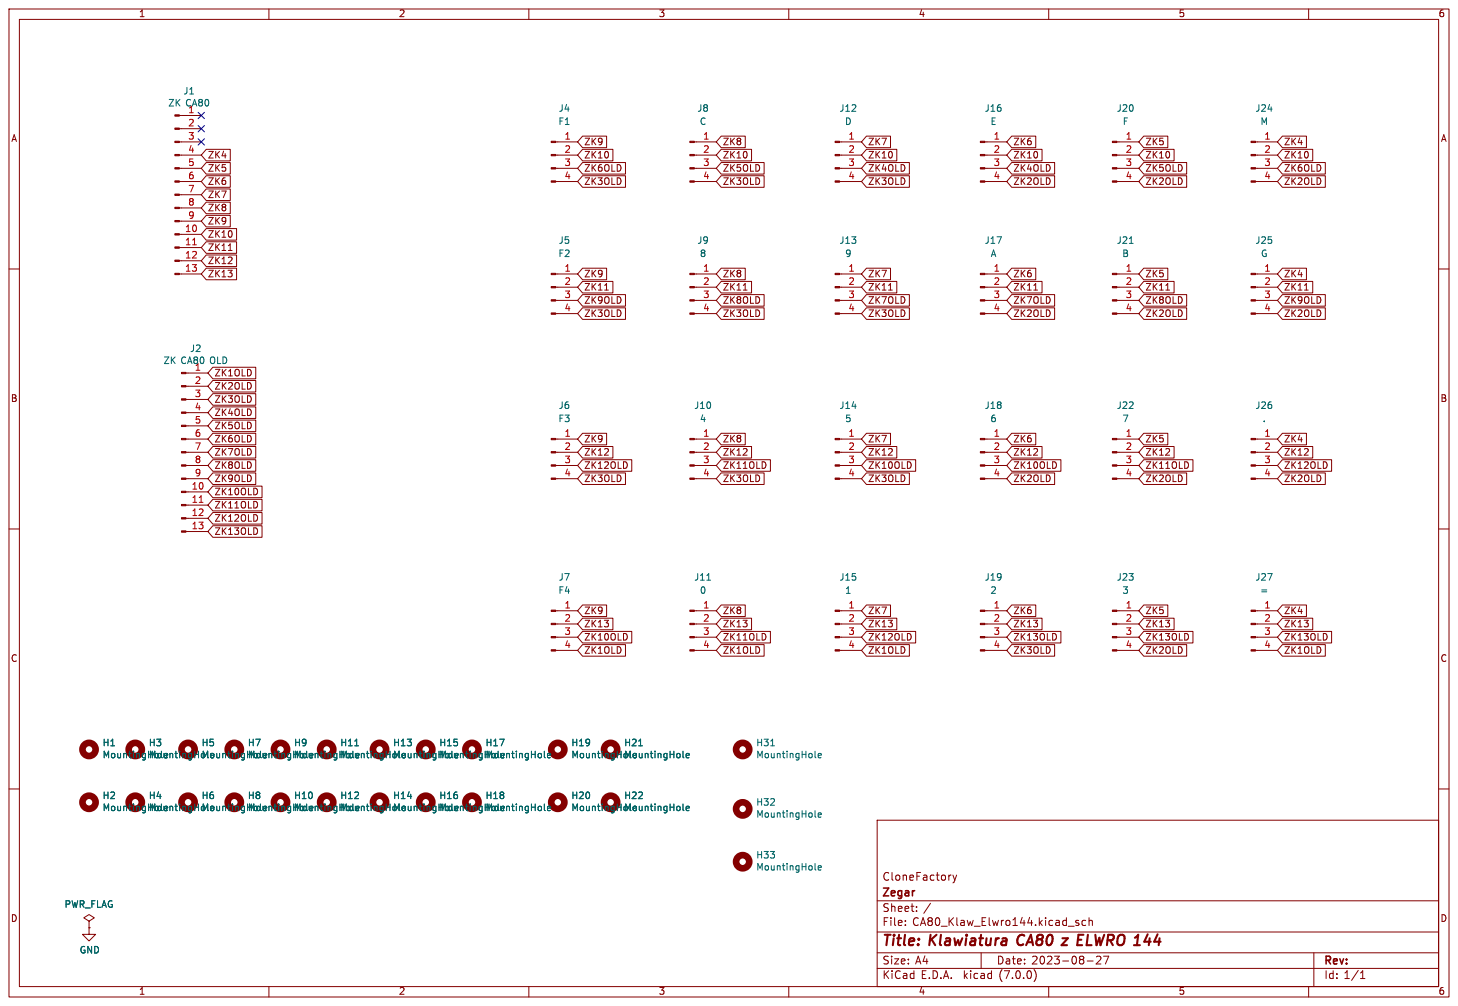
[picture p67: page 1]

Id: 1/1 Title: Klawiatura CA80 z ELWRO 144
