ZegarNotAvailable/CloneFactory/CA80-Cube/HW/Schematics/CA80_WYSW_ELWRO.pdf

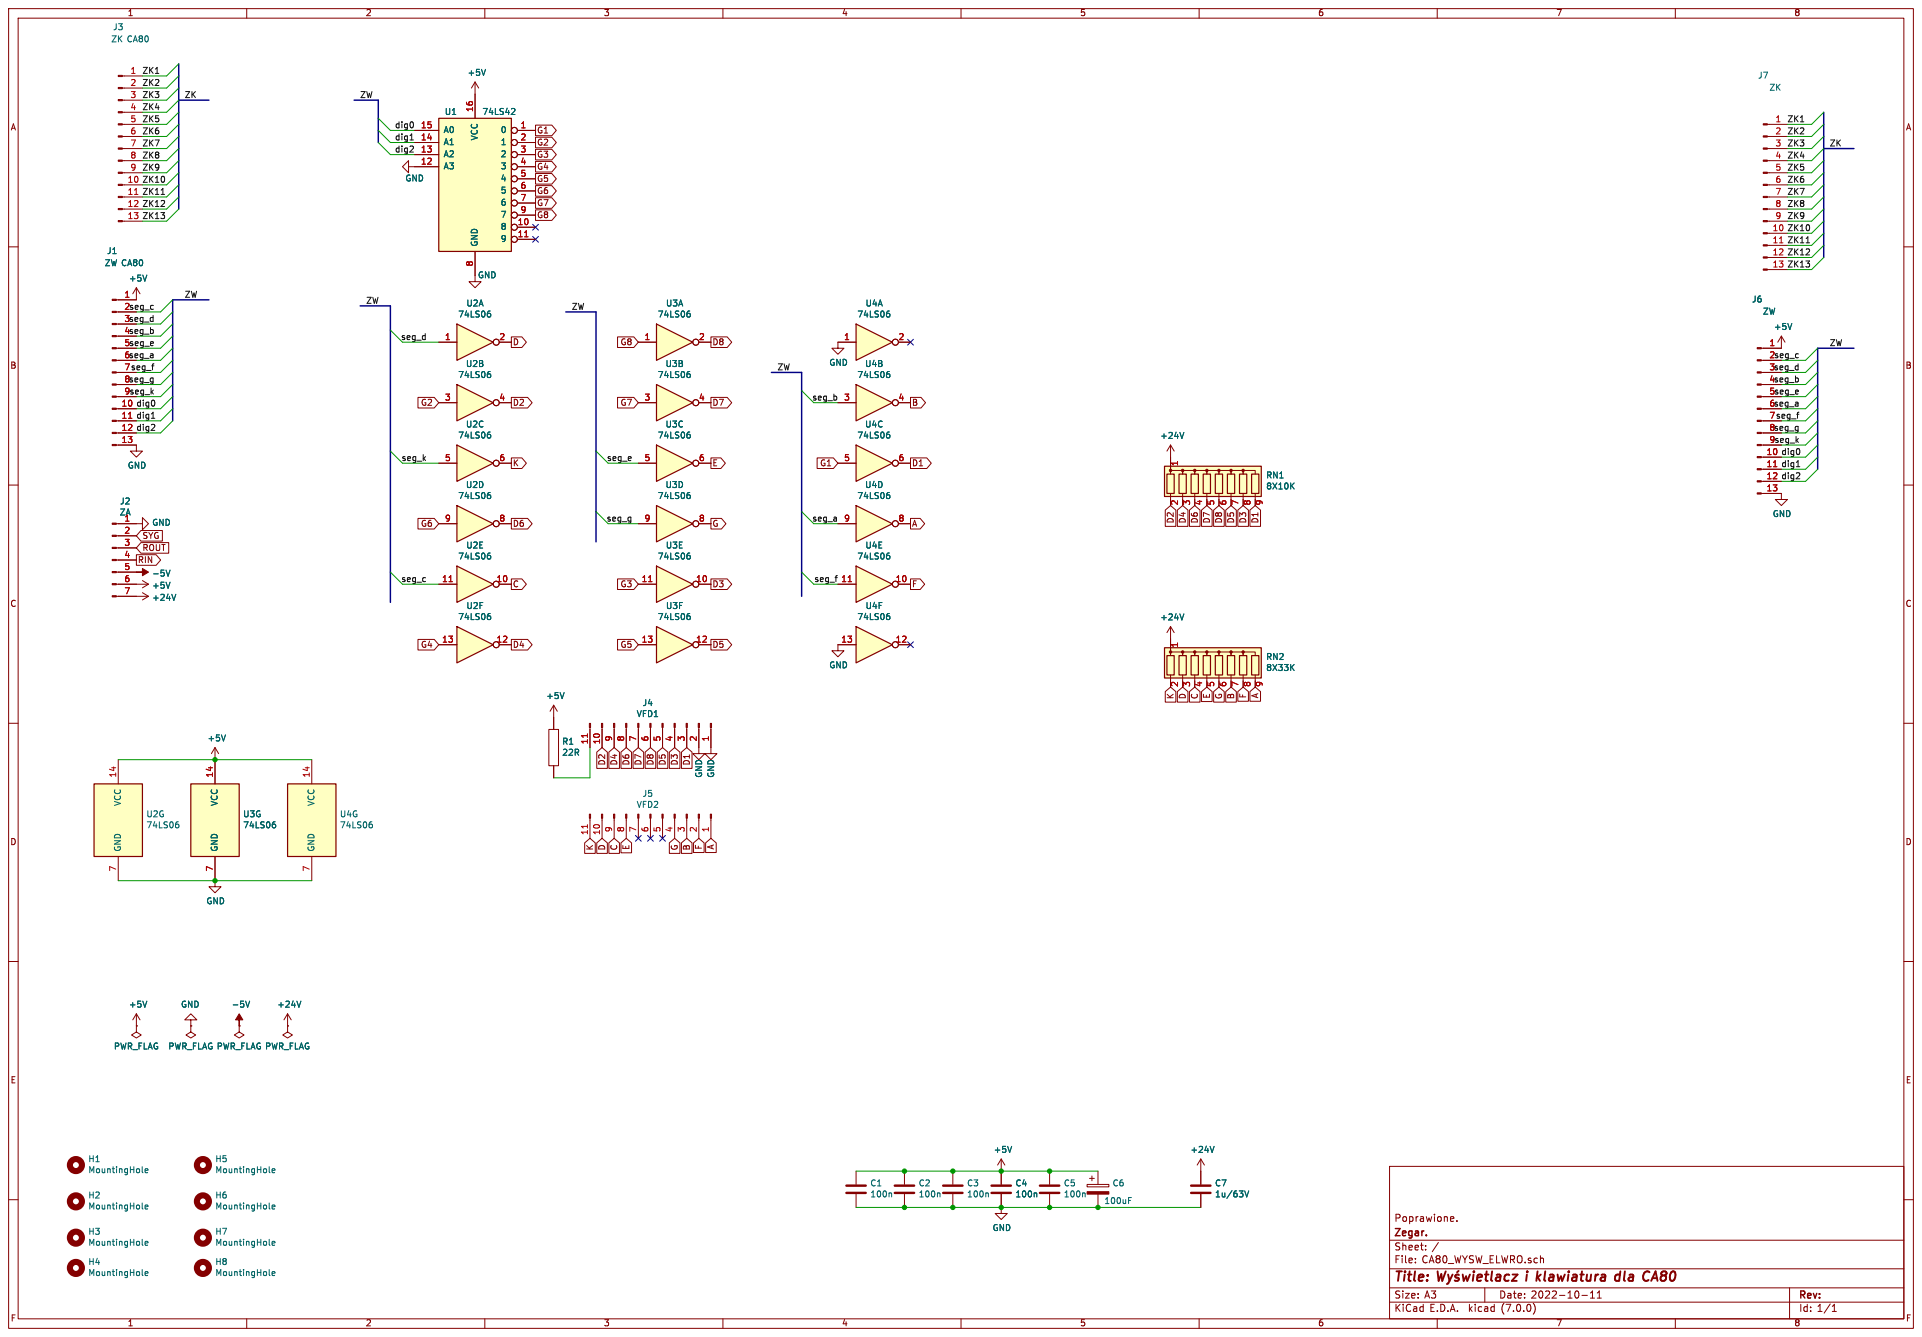
[picture p68: page 1]

Poprawione.
File: CA80_WYSW_ELWRO.sch Sheet: / Zegar.

Id: 1/1 Title: þÿWy[wietlacz i klawiatura dla CA80
