ZegarNotAvailable/CloneFactory/CA80-Cube/HW/Schematics/CA80-MULTI-IO.pdf

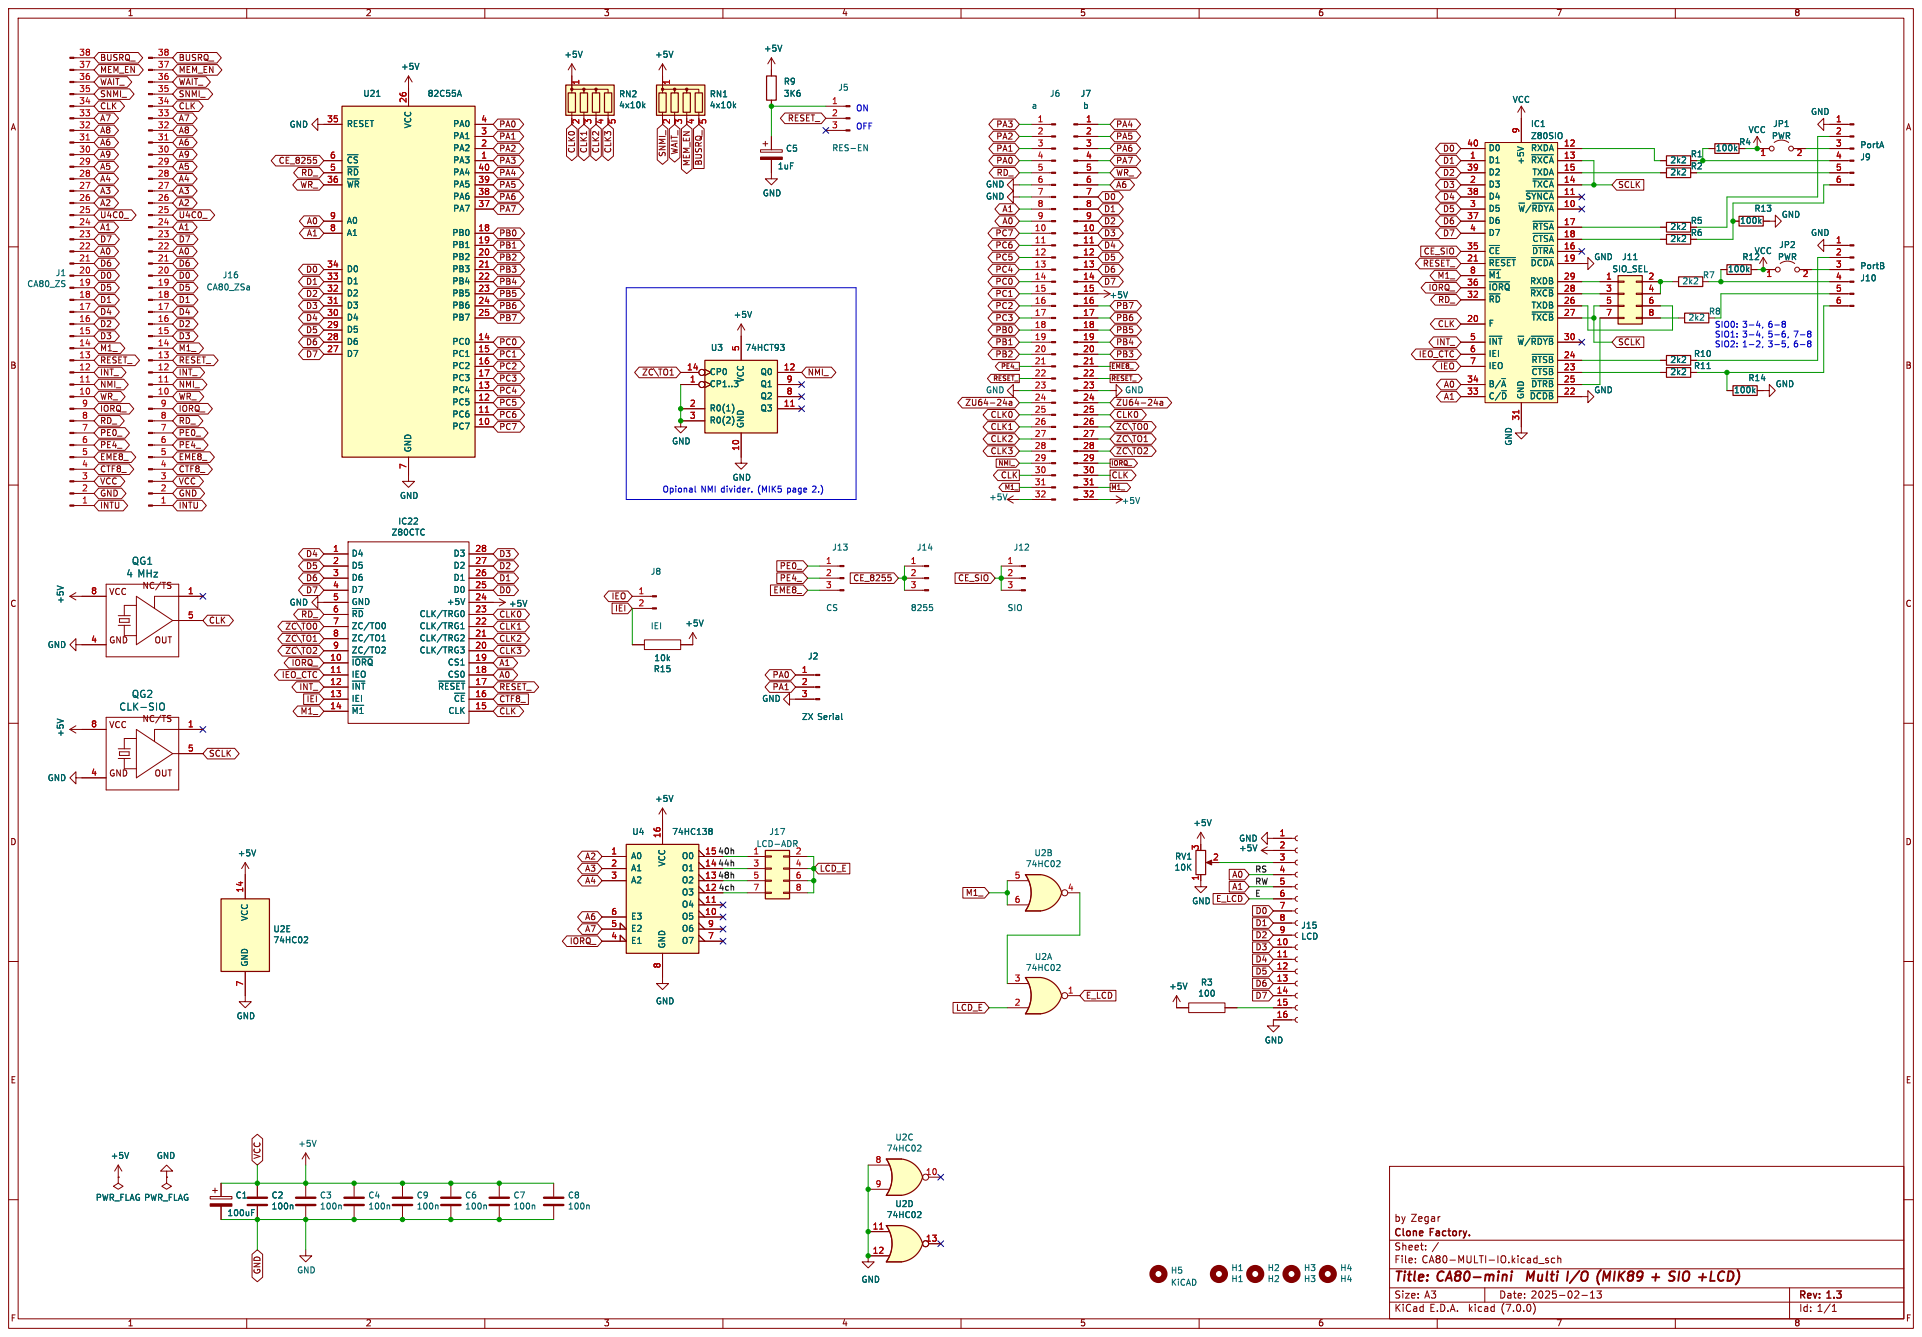
[picture p69: page 1]
