ZegarNotAvailable/CloneFactory/HardWare/Dual-RAM-backplane/D-RAM-backplane.pdf

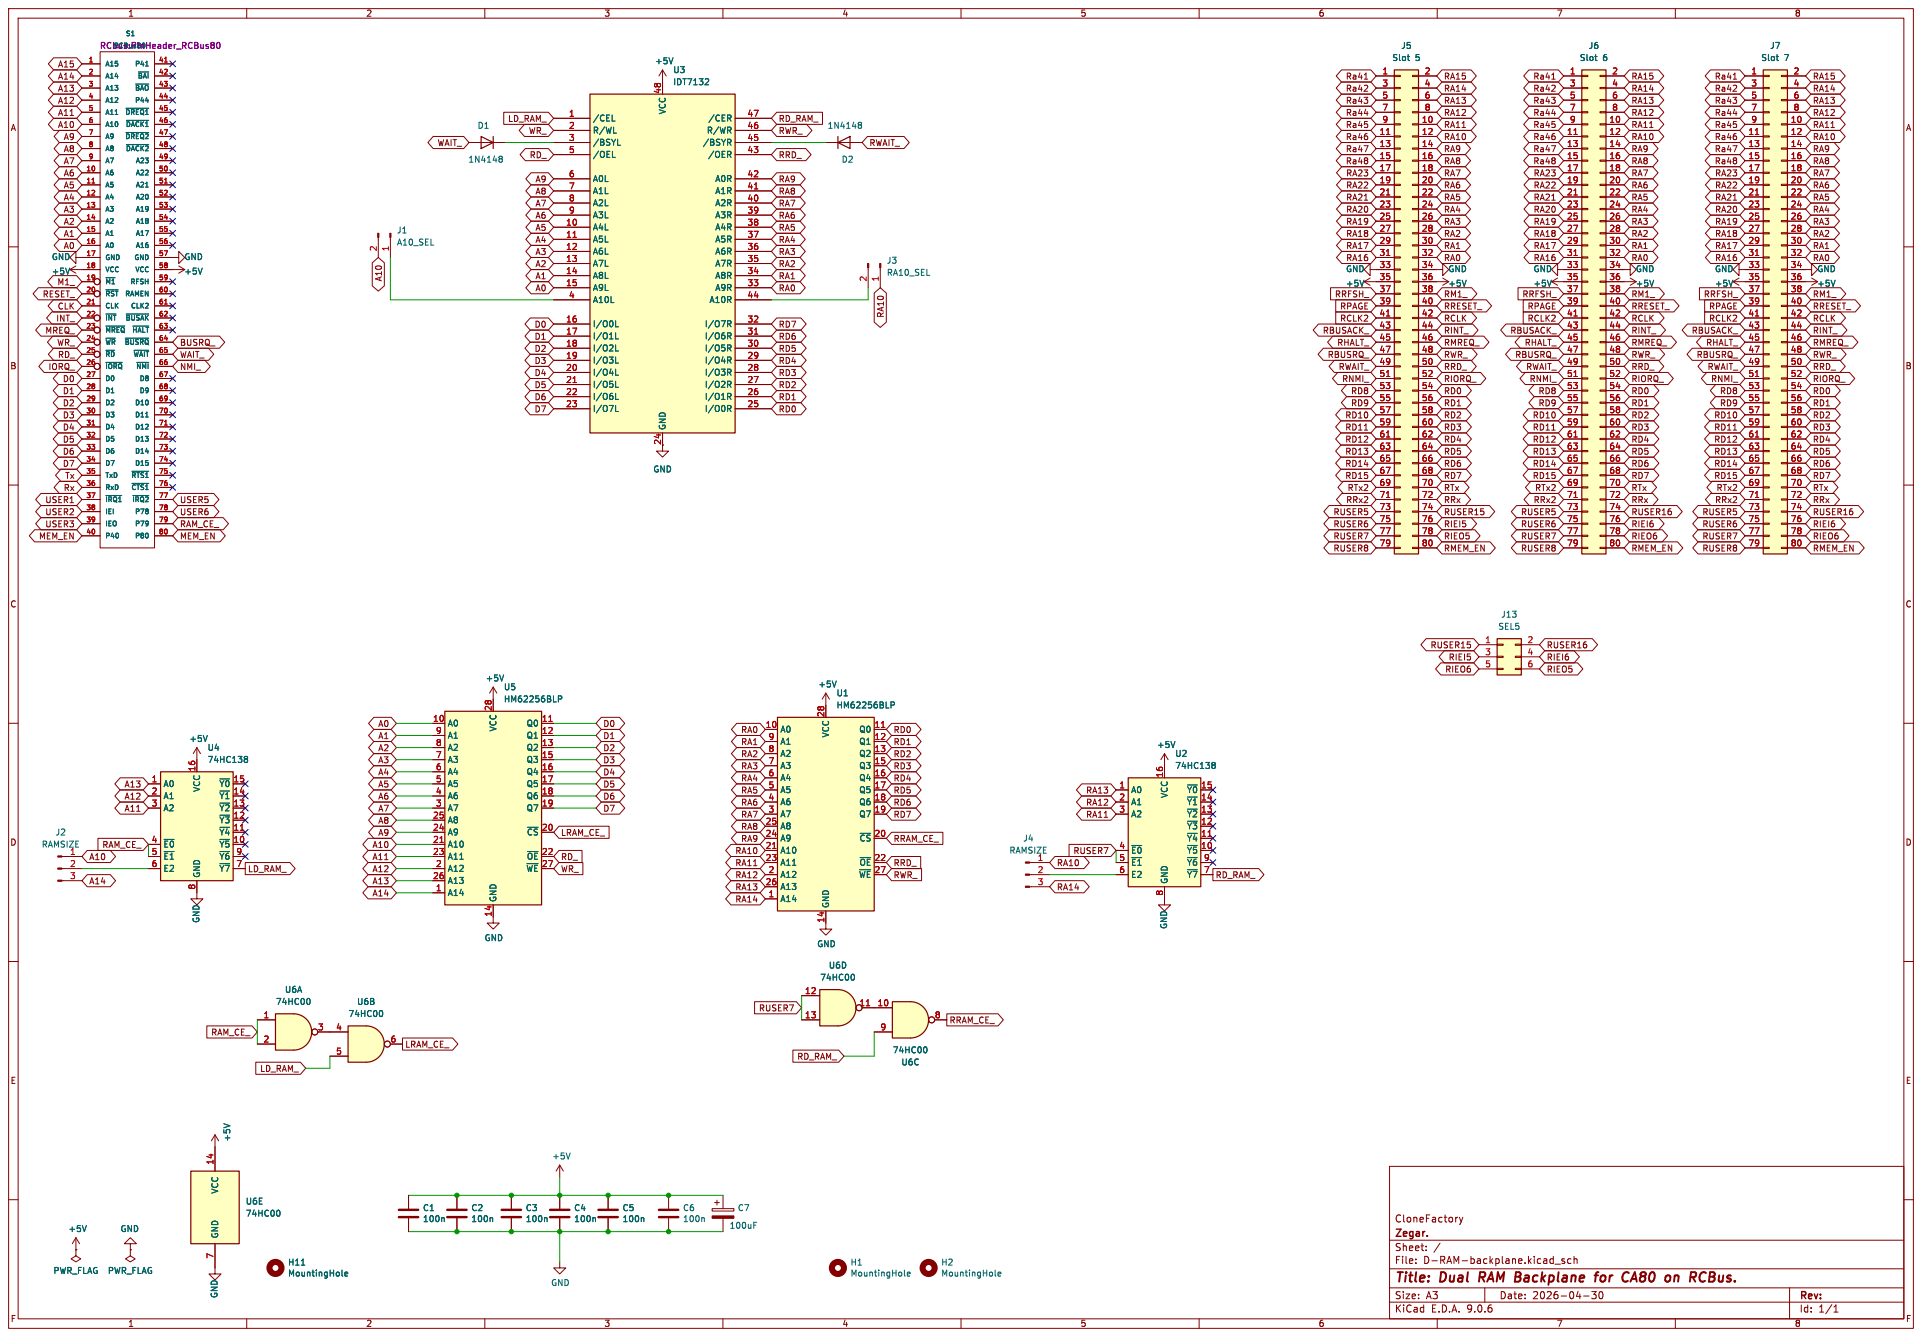
[picture p70: page 1]
