ZegarNotAvailable/CloneFactory/HardWare/MIK51/MIK51.pdf

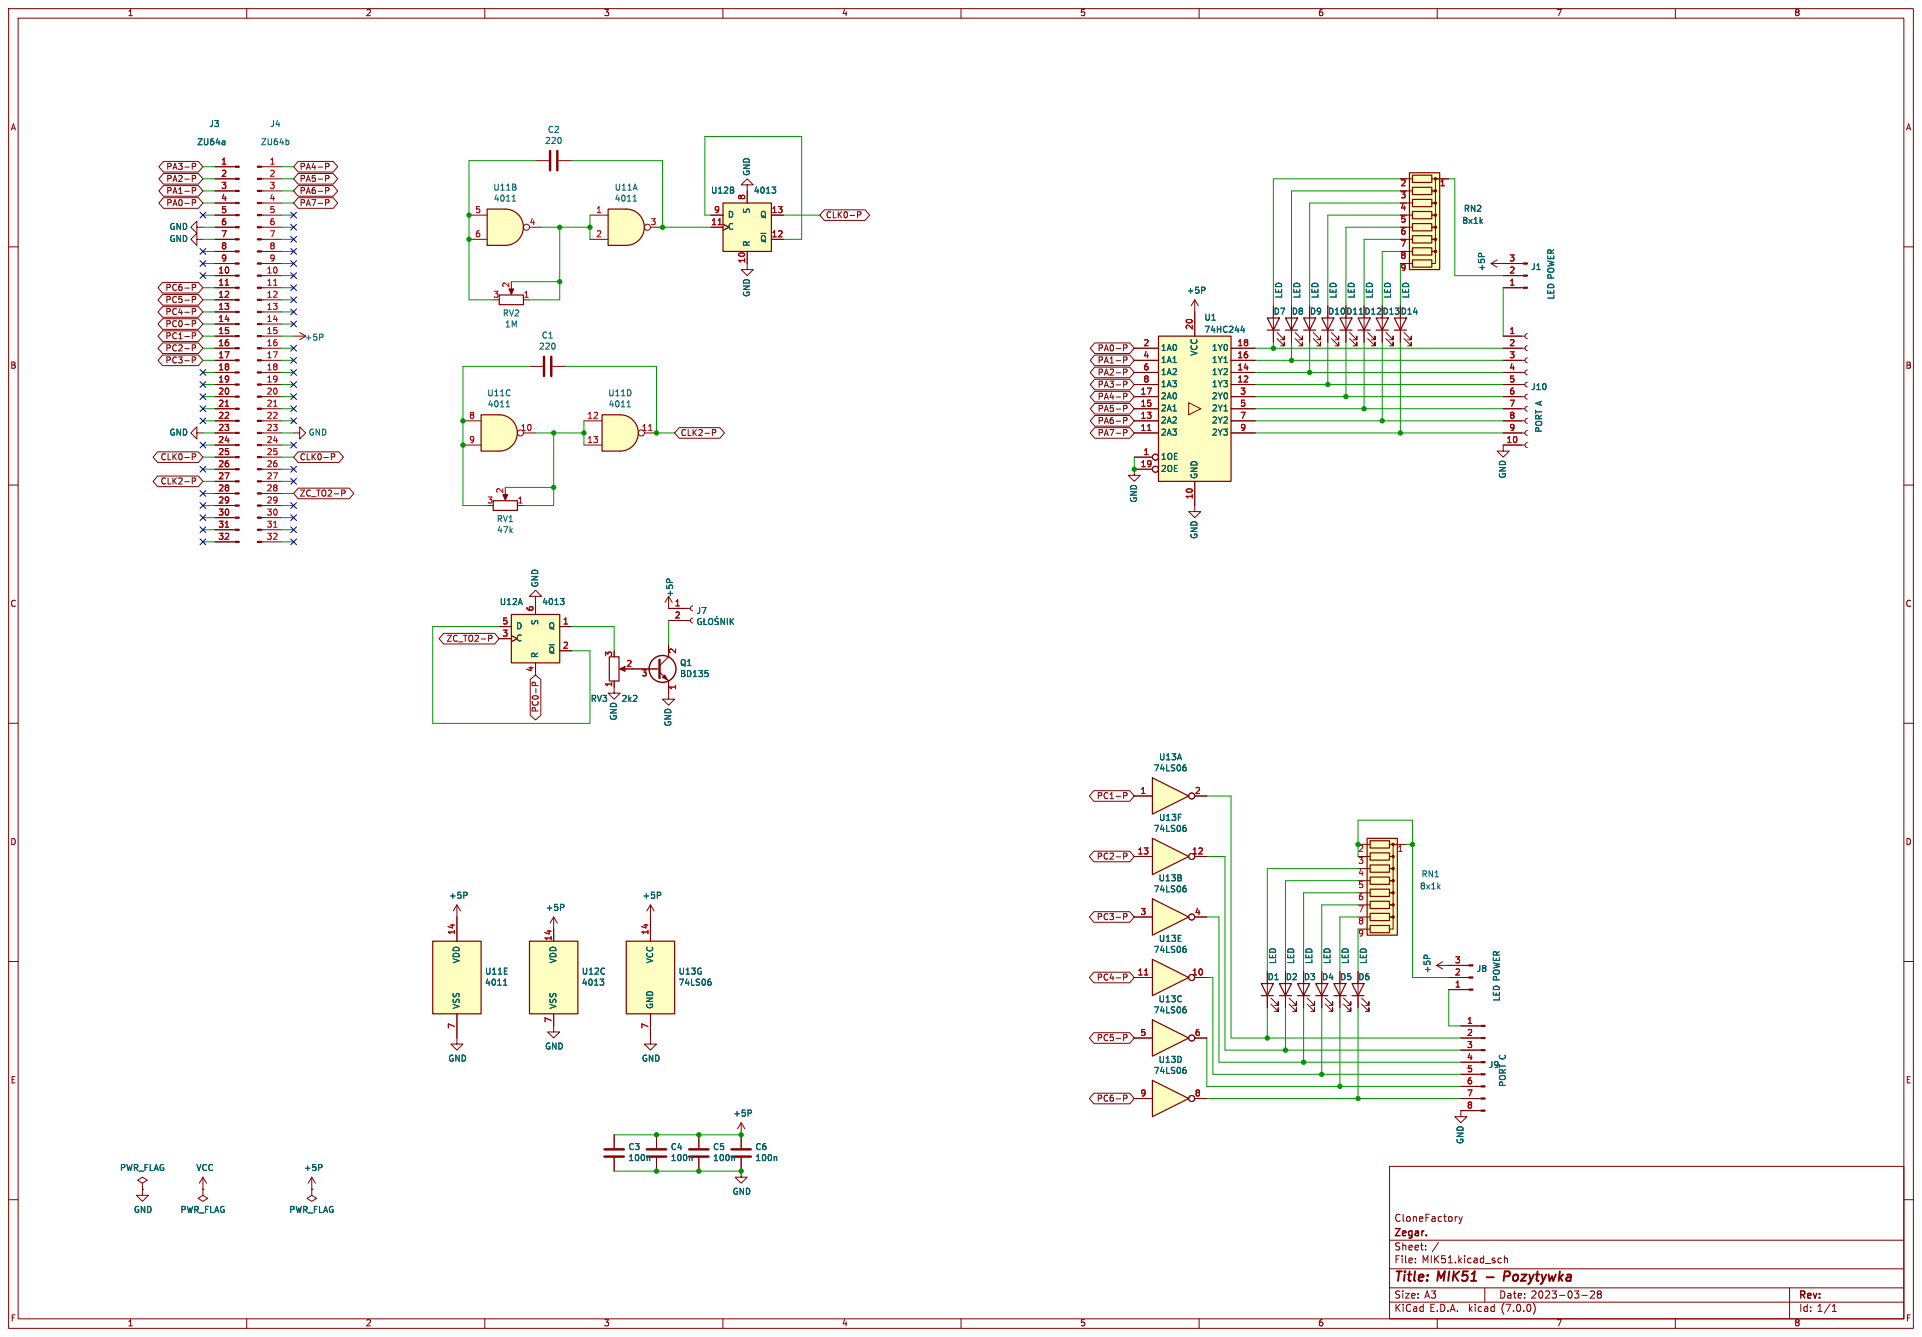
[picture p71: page 1]
