ZegarNotAvailable/CloneFactory/HardWare/MIK94-N/MIK94-RCBus.pdf

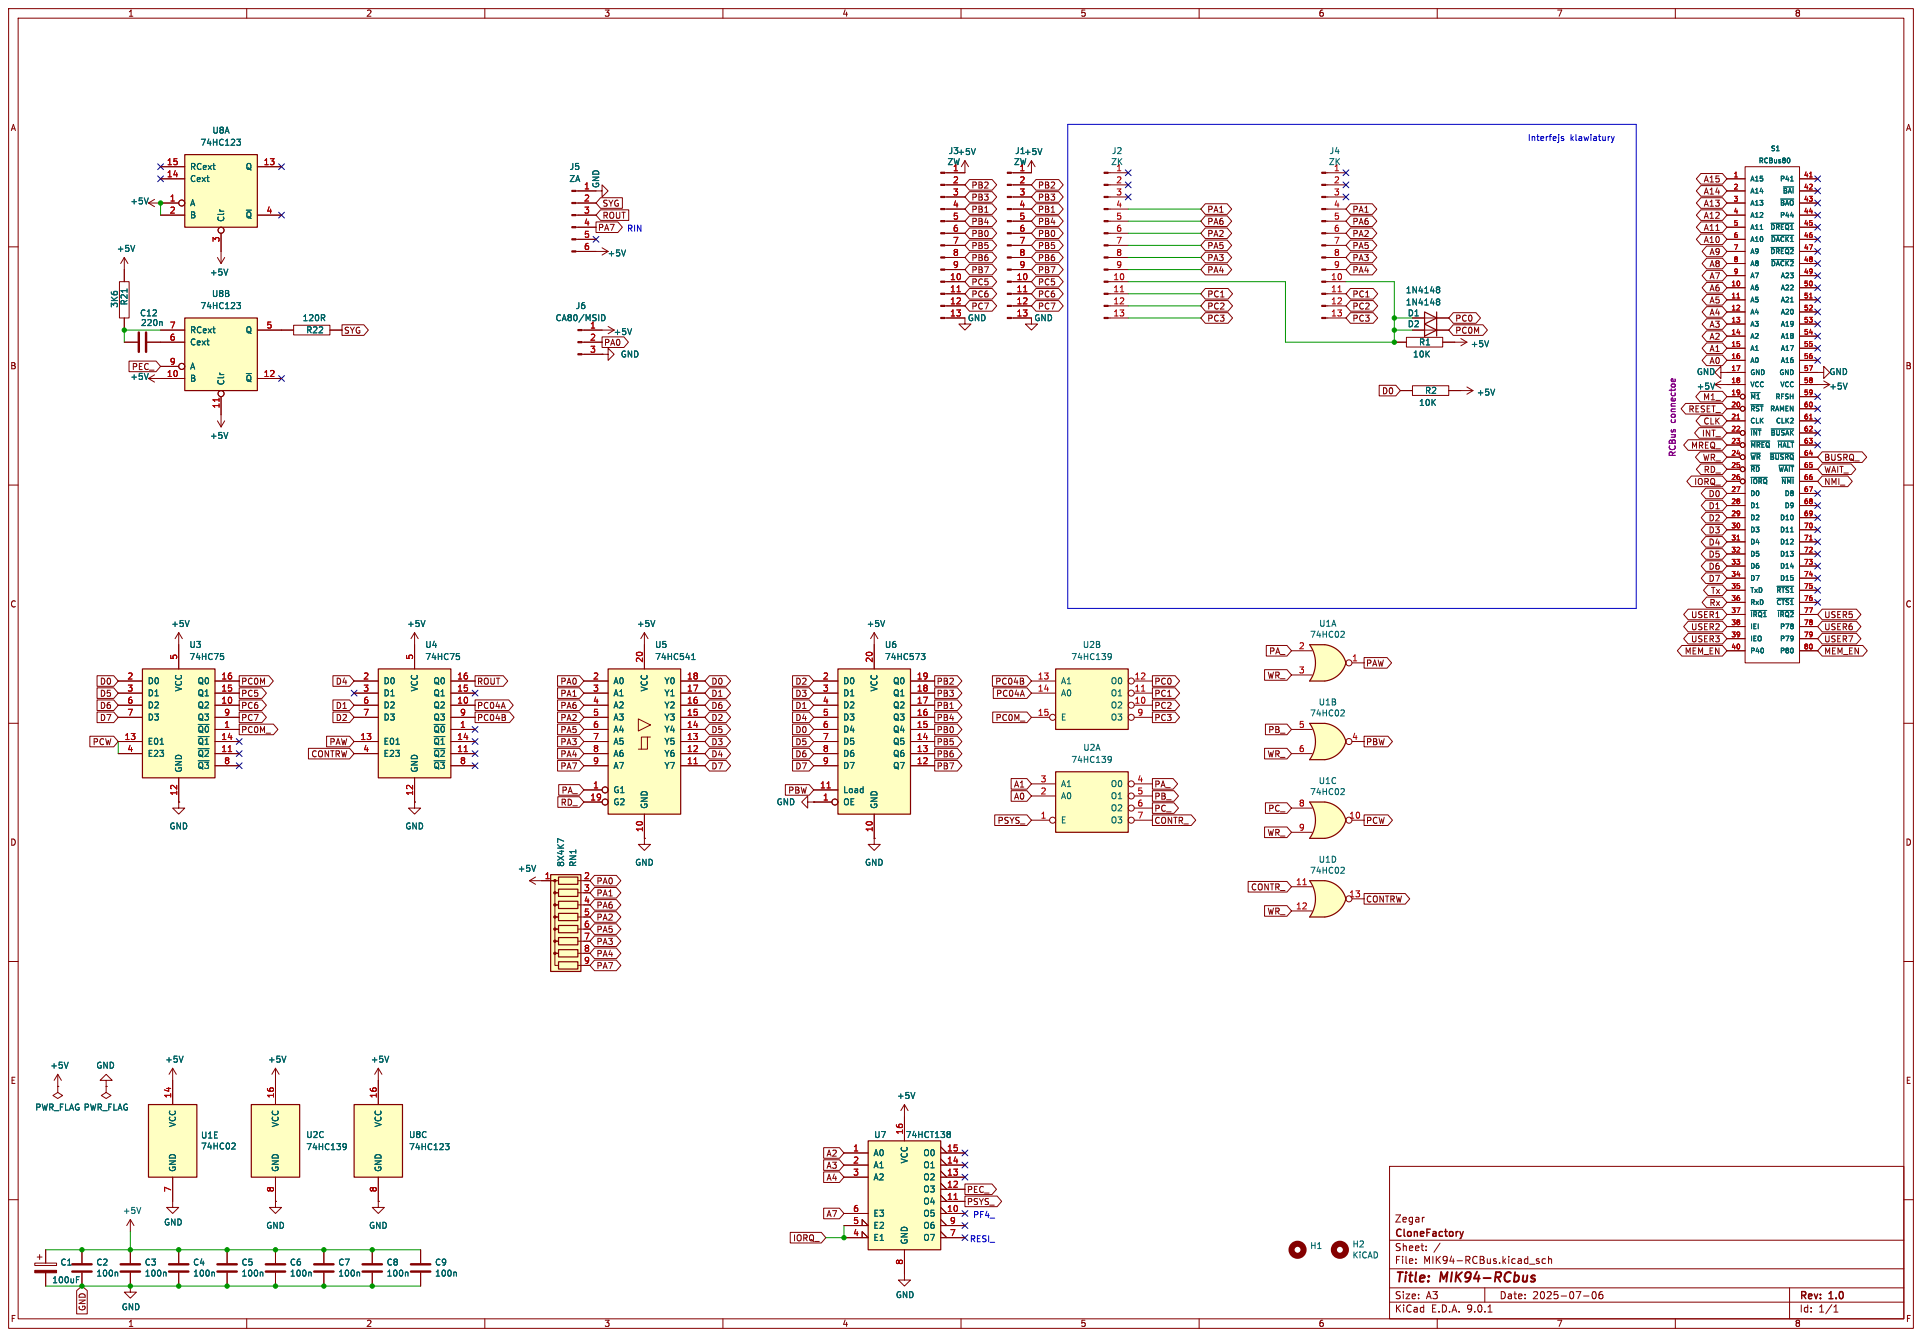
[picture p72: page 1]

IORQ_ RESET_
61 ~{BUSAK} 62 ~{HALT} 63 ~{BUSRQ} 64 ~{WAIT}65 ~{NMI} 66 D8
