ZegarNotAvailable/CloneFactory/HardWare/MIK1-PROTO/MIK1.pdf

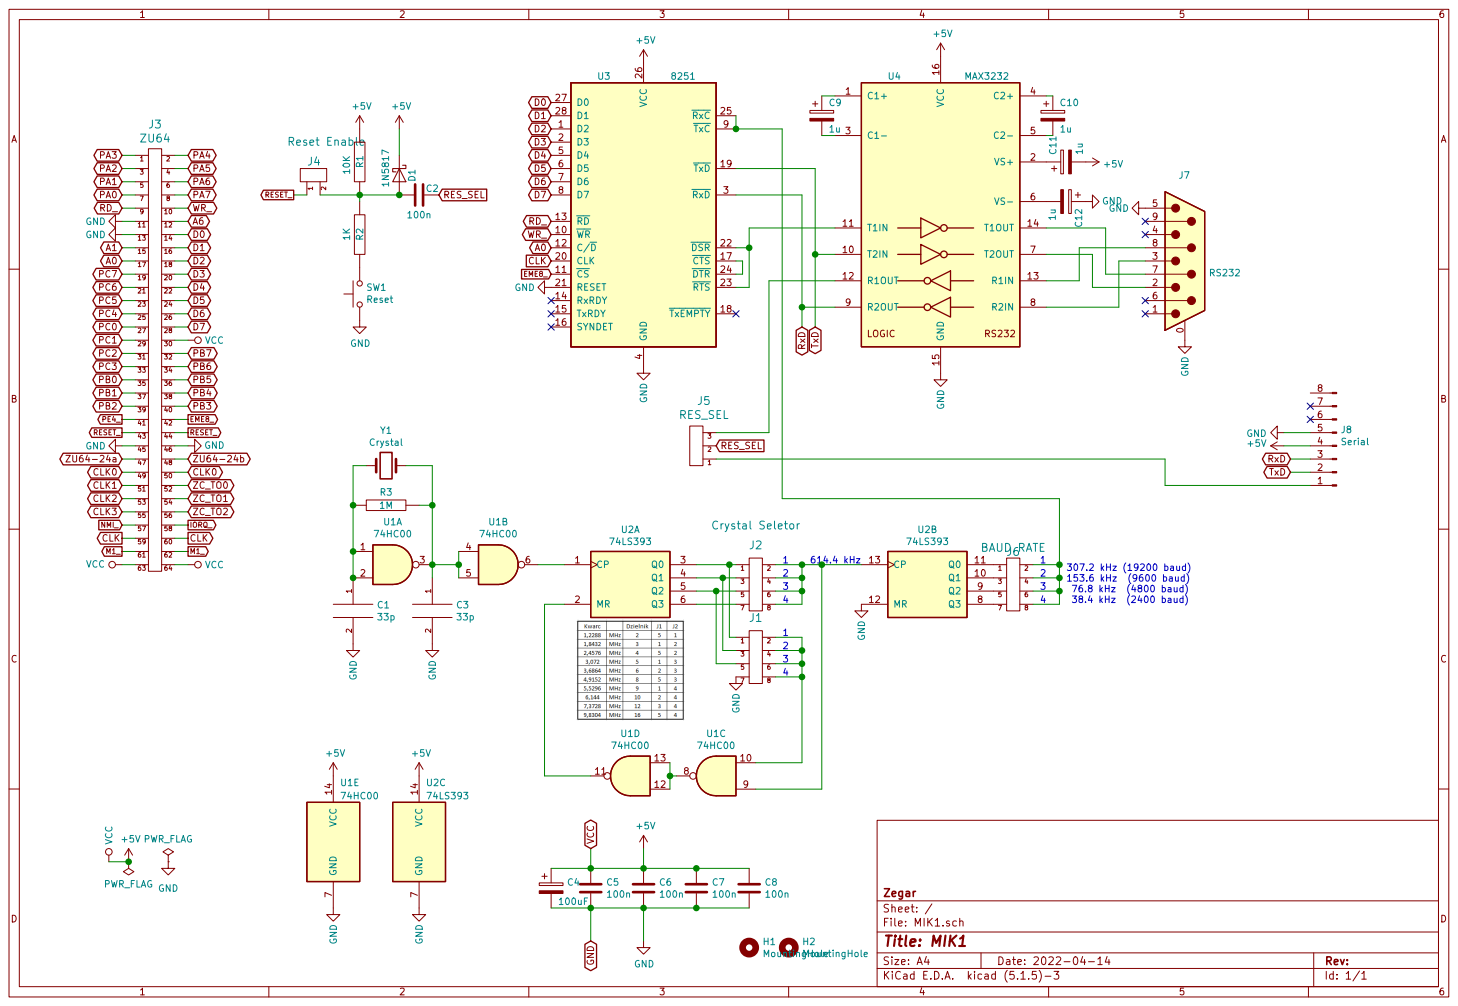
[picture p73: page 1]

3 | 4 3 | 3 | 4 3
5 | 6 4 | 5 | 6 4

File: MIK1.sch Sheet: / Zegar
