ZegarNotAvailable/CloneFactory/HardWare/CA80-bootloader/CA80-boot-RCBus.pdf

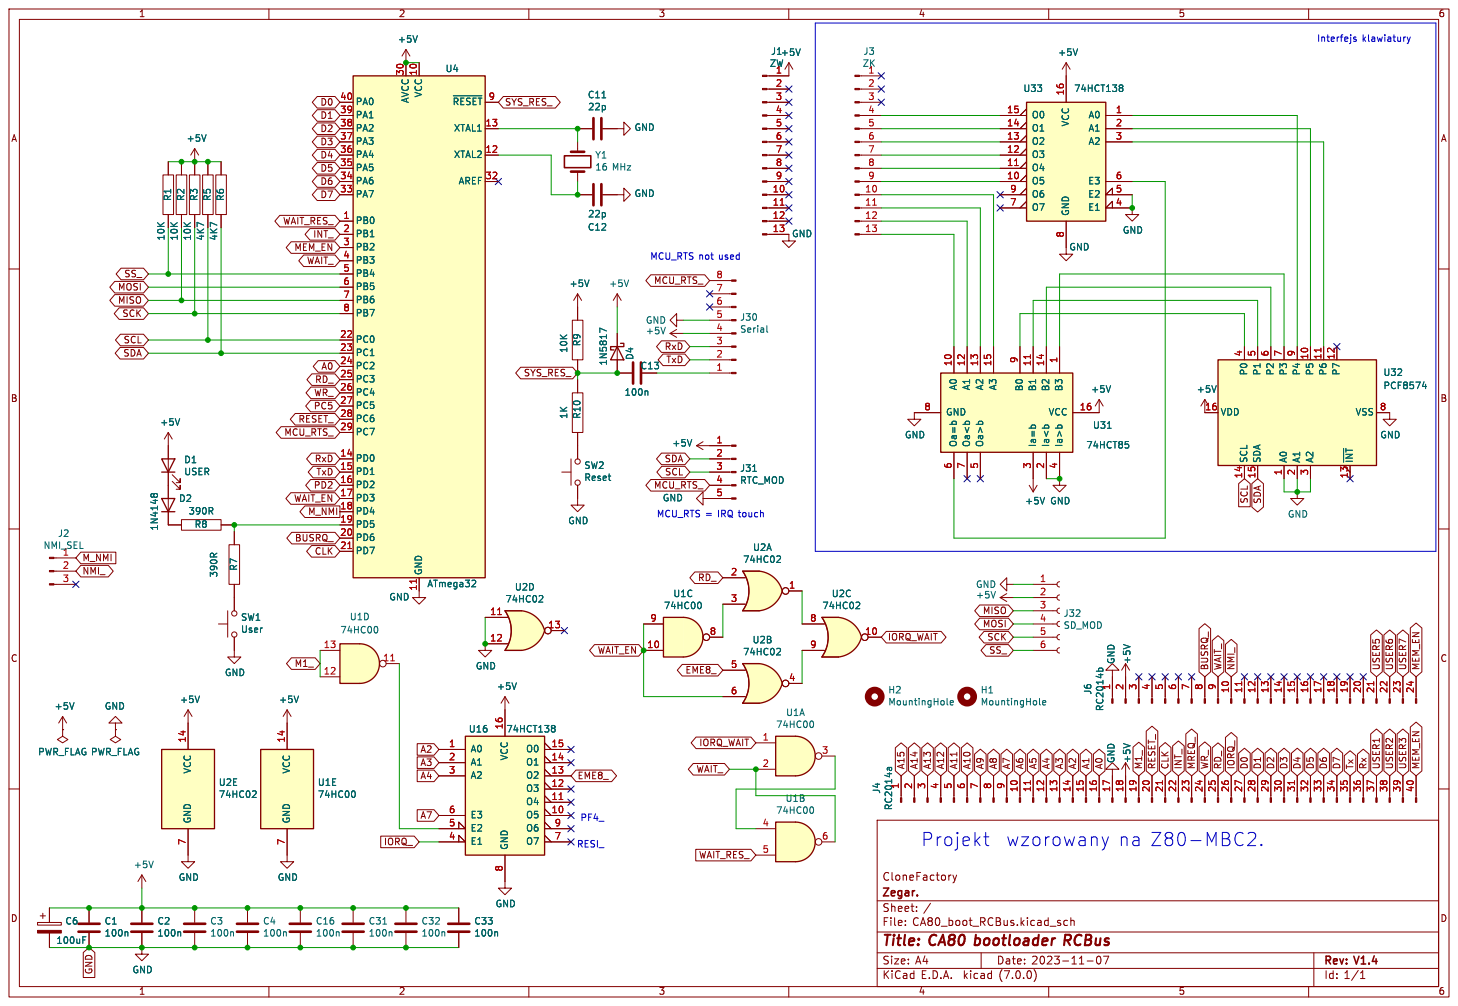
[picture p74: page 1]

1 P5 10 P6 11 P7 12 ~{INT} 13 SCL 14 SDA 15 VDD 16 A1

Id: 1/1 Title: CA80 bootloader RCBus
