ZegarNotAvailable/CloneFactory/CA80-mini/HW/CA80-mini-boot/CA80-mini-boot.pdf

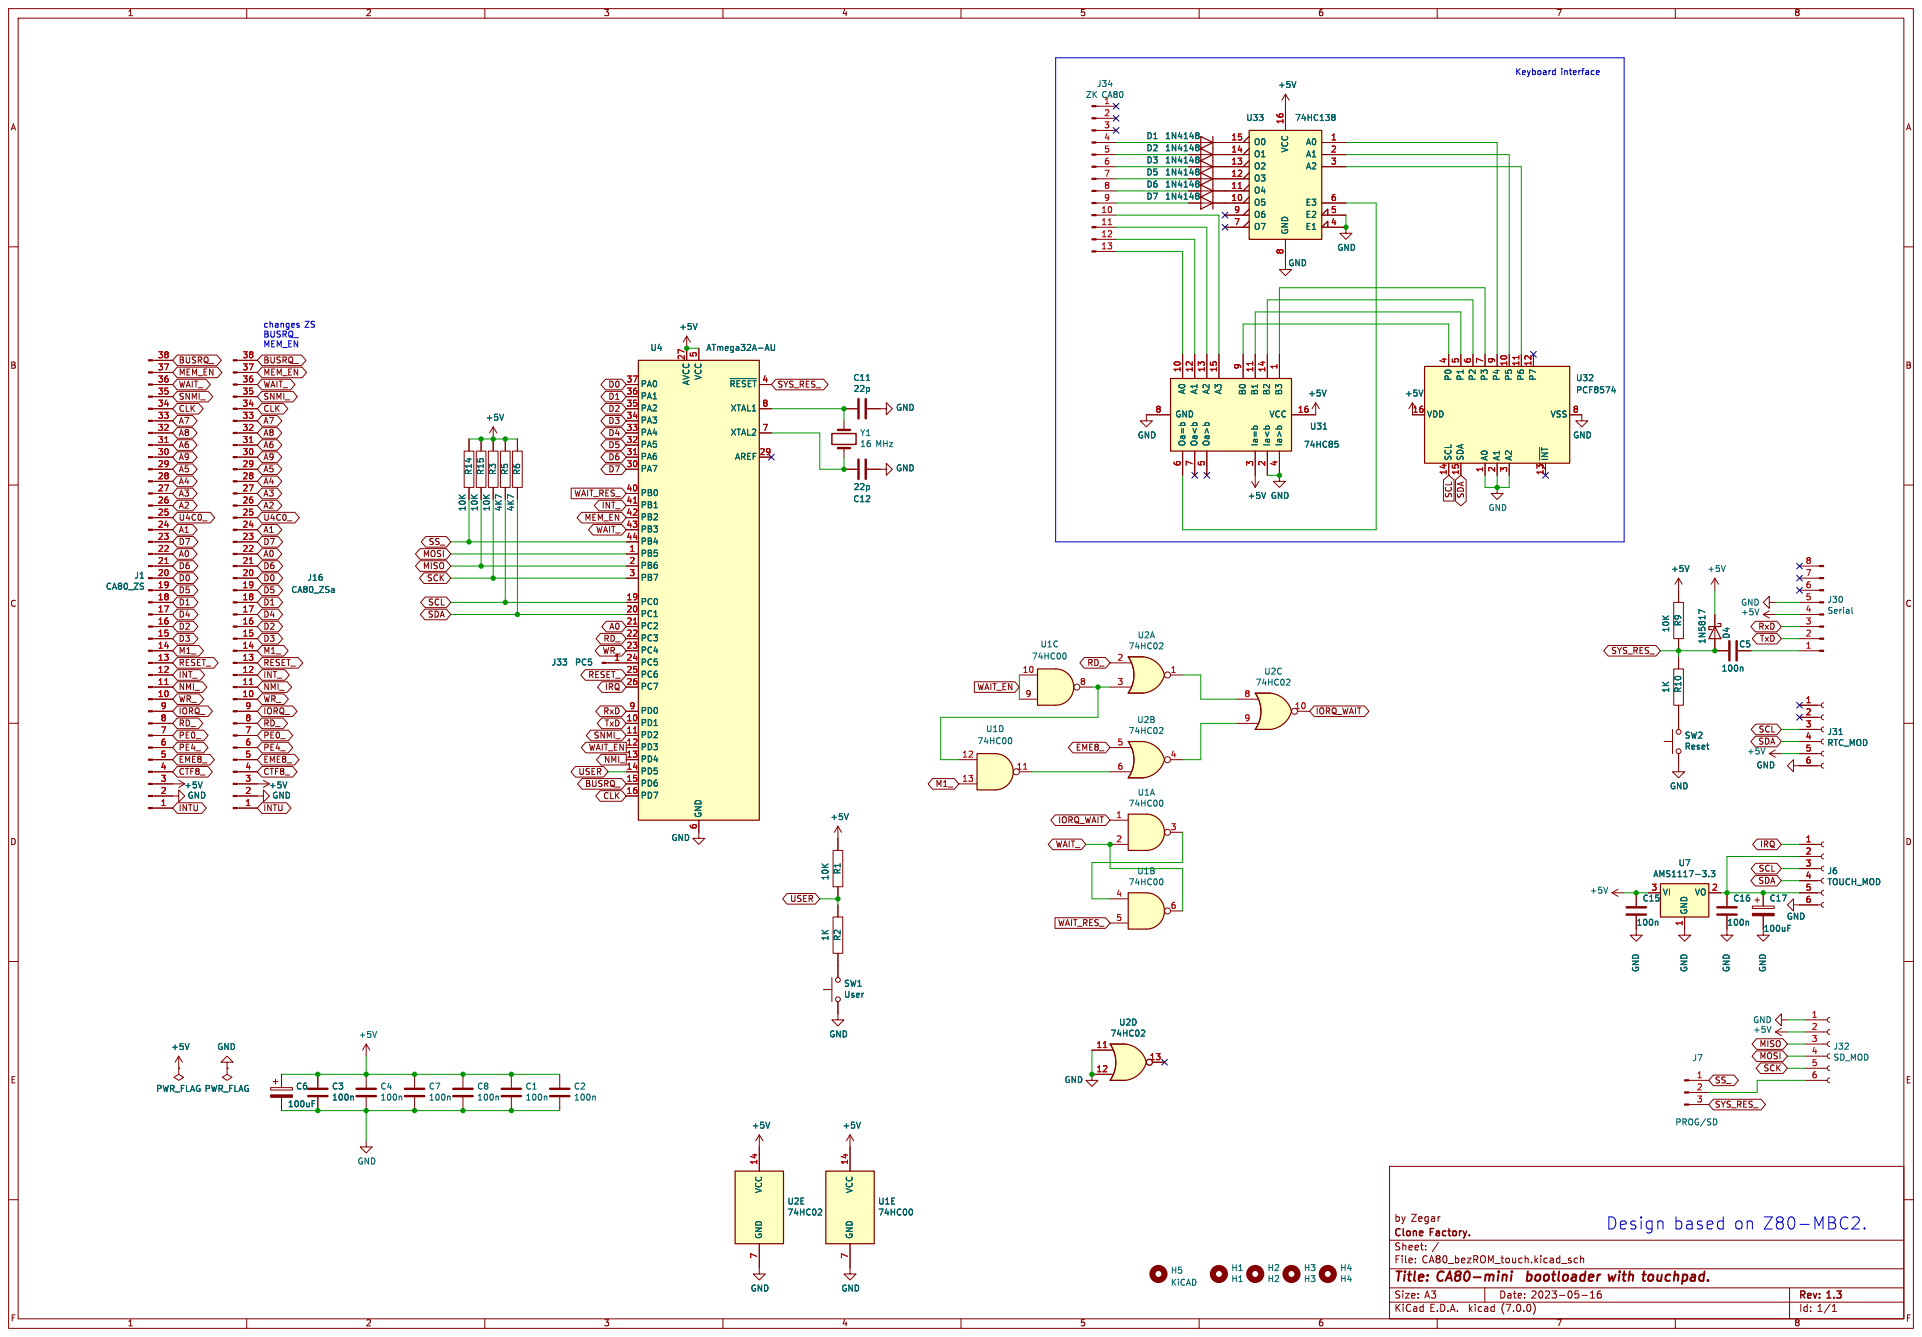
[picture p75: page 1]

1 P5 10 P6 11 P7 12 ~{INT} 13 SCL 14 SDA 15 VDD 16 A1
