ZegarNotAvailable/CloneFactory/(commit log)

2023-12-06 Add documents
    Source code of monitor.
    Schematics.
2023-12-07 HW
    PCB
2023-12-12 Create CA80-RC-BOM.zip
    Add BOM file.
2024-04-12 Some changes.
    Fixed "Starting address" printing.
    [iLoad_CA80.asm]
2024-11-25 Update CA80-BEZ-ROM-3-5-MSID-18-touch.ino
    Touch module issue.
    [CA80-BEZ-ROM-3-5-MSID-18-touch.ino]
2025-01-17 Add new version CAFL
    Transfer files via UART (MIK1).
2025-07-08 CA80-Cube
    Add schematics and code for CA80-mini with CAFL without bootloader.
